GillesClerc/blackbox/docs/escapebox-vision.md

# EscapeBox — Vision produit

*Document de vision — Mai 2026*

---

## Le produit

Box physique électronique posée au centre d'une table. Les joueurs résolvent des énigmes immersives en interagissant avec les différentes faces du cube : écrans, zones tactiles, NFC, capteurs. La box se transforme à chaque scénario téléchargé — même principe qu'une console et ses jeux.

---

## L'objet

Cube ~120-150mm de côté en bois et ardoise *(dimension finale à valider au proto boîtier — la FSD travaille sur 150mm)*. Design artisanal, pensé pour rester sur une étagère entre deux parties. À l'intérieur : ESP32-S3, batterie LiPo, capteurs (NFC, capacitif, accéléromètre/gyro, souffle, température IR, aimant 3D, lumière, micro, potentiomètres), trois écrans (deux yeux ronds + bouche e-ink), haut-parleur stéréo. Un compartiment servo crée le moment de révélation physique (Phase 2).

Deux gammes :
- **Box Lite** (99-129 CHF) : MDF, capteurs essentiels, grand public
- **Box Pro** (199-249 CHF) : bois massif + ardoise + laiton, plateau rotatif, capteurs complets, passionnés et collectors

---

## L'expérience

Le joueur pose un objet NFC sur la box → elle s'allume, une voix lance l'histoire. Chaque énigme exploite un capteur différent. La coopération est dans le design : certaines énigmes nécessitent deux joueurs simultanément. La partie se termine par une révélation physique et un QR vers le leaderboard.

---

## Le modèle

Box achetée une fois. Scénarios achetés à l'unité (19-29 CHF) via la webapp, synchronisés sur la box via WiFi. La box fonctionne 100% offline pendant le jeu.

---

## Go-to-market

1. **FFF** — valider avec proches, retours qualitatifs, ajustements scénario/boîtier
2. **Kickstarter** — 50-100 early adopters à ~150 CHF si traction confirmée
3. **Lancement** — catalogue 3+ scénarios, marketplace créateurs, partenariats escape rooms et établissements scolaires (Phase 3)

---

## Vision à 3 ans

Catalogue de 15-20 scénarios, marketplace ouverte aux créateurs tiers, partenariats B2B (escape rooms, écoles, musées). Référence francophone dans le segment escape game électronique premium rejouable.

---

*Ce document est la vision du projet, pas une spec technique. Il peut évoluer.*
