GillesClerc/blackbox/docs/pcb/01-netlist.txt

══════════════════════════════════════════════════════════════════════════════
  ESCAPEBOX — NETLIST COMPLETE
  Format : texte structure pour reference lors du cablage dans Fusion 360
  Convention : NET_NAME : PIN1, PIN2, PIN3, ...
══════════════════════════════════════════════════════════════════════════════

═══ ALIMENTATIONS ════════════════════════════════════════════════════════════

NET 5V_USB:
  J1.VBUS (4 pins physiques a relier ensemble : A4, A9, B4, B9), U8.IN, C_IN.+, U12.VBUS

NET VSYS:
  U8.OUT (bq24075 power path output)
  U5.VIN (LDO digital), C_D1.+
  U6.VIN (LDO audio), C_A1.+
  U7.VIN (MT3608 boost), U7.EN (tie a VIN), C_B1.+
  L1.1 (inductance boost, autre borne sur BOOST_SW)
  (USB branche: ~4.4V / batterie: 3.0-4.2V)

NET VBAT:
  U8.BAT (bq24075), U9.VDD (DW01A), J2.1 (+), C_BAT.+

NET BAT_TS (2026-09-27, cellule 18650 avec NTC collee) :
  J2.3 (NTC 10k de la cellule), U8.TS (pin 1), R_TS.1 (10k fixe, DNP)
  (J2 = JST-PH 3 broches : 1 = BAT+, 2 = BAT-, 3 = NTC.
   /!\ Monter la NTC OU R_TS, jamais les deux : en parallele la mesure est
   faussee et le bq24075 suspend la charge sans symptome visible. TS flottante
   suspend la charge egalement. Fenetre obtenue : 0-50 C.)

NET 3V3_D (digital):
  U5.VOUT (pin 1 — AP2112M en SO-8 depuis le 2026-09-27, cf. brochage
   dans docs/datasheets/AP2112.md ; U5.GND = pins 6 ET 7), C_D2.+
  U1.3V3 (ESP32-S3 VDD)
  U4.VDD (ICS-43434)
  U11.VDDIO (pin 5, LSM6DSOXTR), U11.VDD (pin 8), U11.CS (pin 12, force mode I2C),
  C4.+ (100nF, decouplage VDDIO), C5.+ (100nF, decouplage VDD) — sheet imu.kicad_sch,
  IMU deplacee du satellite capteurs vers Main (2026-09-21), aucune contrainte de position
  (le ST25DV NFC est parti sur le satellite face Dessus — sheet nfc.kicad_sch, projet
  PCB separe, plus dans ce netlist Main)
  J3.VCC, J4.VCC, J5.VCC, J6.VCC (I2C satellites — pin 2, brochage Qwiic :
   1 = GND, 2 = 3V3, 3 = SDA, 4 = SCL, depuis 2026-09-23)
  J7.VCC (2x GC9A01 yeux)
  J7b.VCC (display bouche, TBD — pas e-ink)
  J8.VCC (toggles face avant + reserve)
  R3.1, R4.1 (pull-up I2C)
  R6.1 (pull-up EN)
  R_PG.1, R_CHG.1 (pull-up debug PGOOD/CHG, DNP par defaut)
  (R7 n'est plus utilise — le ST25DV n'a pas de pin reset/power-down equivalente
   au RSTPD du PN532. R7 retire du BOM.)

NET 3V3_A (audio):
  U6.VOUT, C_A2.+
  R5.1 (pull-up XSMT — vers 3V3_A, cf. NET PCM_XSMT)
  U2.AVDD (pin 8), C_AVDD.+
  U2.DVDD (pin 28), C_DVDD.+
  U2.CPVDD (pin 1), C_CPVDD.+
  U2.XSMT (pin 25) via R5
  (⚠ pins PCM5122 corrigees 2026-09-11 — vs datasheet TI SLAS763C, mode I2C.
   L'ancien netlist avait TOUS les numeros de pins PCM5122 faux, y compris
   ceux-ci. CPGND(3)/DGND(27)/AGND(9) restent a raccorder explicitement —
   non couverts par le NET GND generique actuel, a traiter au schematic capture.)

NET BOOST_SW:
  U7.SW (MT3608 pin 1)
  L1.2 (autre borne sur VSYS)
  D1.A (SS14 anode)

NET BOOST_FB:
  U7.FB (MT3608 pin 3)
  R_FB_H.2 (750k, autre borne sur 5V)
  R_FB_L.1 (100k, autre borne sur GND)

NET 5V_BOOST (sortie du boost, avant le load switch — 2026-09-27) :
  D1.K (SS34 cathode), C_B2.+
  R_FB_H.1 (diviseur feedback — reste cote boost, la regulation ne voit pas
   la chute du load switch)
  Q1.S (AO3401A, source cote boost)

NET GATE_5V:
  Q1.G, Q2.D (2N7002), R21.2 (100k vers 5V_BOOST)
  (Q1 conduit grille basse alors que EN_SYS est haut box allumee -> Q2 inverse)

NET EN_SYS (marche/arret, 2026-09-27) :
  J12.2 (interrupteur SW3 face Cote 2), R20.1 (pull-down 100k vers GND),
  U5.EN (LDO 3V3_D), U6.EN (LDO 3V3_A), U7.EN (boost MT3608), Q2.G
  (etaient tous cables directement sur VSYS avant : la box s'allumait des
   qu'une batterie etait branchee, ~10 mA de repos)

NET VSYS (ajout J12) :
  J12.1 (l'interrupteur ramene VSYS sur EN_SYS quand il est ferme)

NET 5V (apres le load switch) :
  Q1.D
  J9.VCC (WS2812)
  U3.VDD (PAM8406)
  (VOUT = 0.6V x (1 + 750k/100k) = 5.1V — le MT3608 n'a pas de pin VOUT,
   la sortie passe par SW -> D1 -> Q1. Chute du load switch ~50 mV a 0,83 A,
   la charge voit donc ~5,05 V, dans les specs WS2812 et PAM8406.)

NET GND:
  (toutes les masses — plan continu, pas de split)
  J1.GND (4 pins physiques : A1, A12, B1, B12 + EMI plate/shield du connecteur),
  U1.GND, U2.GND, U3.GND, U4.GND, U5.GND, U6.GND,
  U7.GND, U8.GND, U9.GND, U10.GND, U11.GND, U12.GND,
  J3.GND, J4.GND, J5.GND, J6.GND, J7.GND, J7b.GND, J8.GND,
  J9.GND, J2.GND,
  tous condensateurs pin -, toutes resistances retour GND

═══ BUS I2C ══════════════════════════════════════════════════════════════════

NET I2C_SDA:
  U1.GPIO21
  R3.2 (pull-up 4.7k vers 3V3_D)
  U2.SDA (PCM5122 pin 11)
  U11.SDA (pin 14, LSM6DSOXTR)
  J3.SDA, J4.SDA, J5.SDA, J6.SDA (satellites)

NET I2C_SCL:
  U1.GPIO17
  R4.2 (pull-up 4.7k vers 3V3_D)
  U2.SCL (PCM5122 pin 12)
  U11.SCL (pin 13, LSM6DSOXTR)
  J3.SCL, J4.SCL, J5.SCL, J6.SCL (satellites)

NET GND (ajout U11 LSM6DSOXTR):
  U11.SDO/SA0 (pin 1 — fixe l'adresse I2C a 0x6A), U11.SDx (pin 2, inutilise en
  mode 1), U11.SCx (pin 3, inutilise en mode 1)

(U11.INT1 (pin 4), U11.INT2 (pin 9), U11.OSC_AUX (pin 10), U11.SDO_AUX (pin 11) :
 non connectes — pas de GPIO libre pour les interruptions, OSC_AUX/SDO_AUX a
 laisser electriquement flottants en mode 1 par recommandation datasheet ST DS12814.
 Pinout complet verifie sur la datasheet primaire, voir docs/datasheets/LSM6DSOX.pdf)

(Le NET NFC_ANTENNA et le cablage ST25DV sont partis sur le satellite face Dessus,
 projet PCB separe — plus dans ce netlist Main. Voir nfc.kicad_sch.)

═══ BUS I2S0 — AUDIO SORTIE ═════════════════════════════════════════════════

NET I2S0_BCLK:
  U1.GPIO4
  U2.BCK (PCM5122 pin 21)

NET I2S0_LRCK:
  U1.GPIO5
  U2.LRCK (PCM5122 pin 23)

NET I2S0_DOUT:
  U1.GPIO6
  U2.DIN (PCM5122 pin 22)

═══ BUS I2S1 — AUDIO ENTREE (MICRO) ═════════════════════════════════════════

NET I2S1_SCK:
  U1.GPIO16
  U4.SCK (ICS-43434)

NET I2S1_WS:
  U1.GPIO18
  U4.WS (ICS-43434)

NET I2S1_SD:
  U1.GPIO7
  U4.SD (ICS-43434)

═══ BUS SPI2 — DISPLAY BOUCHE (type à définir, pas e-ink) + microSD (J11) ═══
(bus partage : MOSI/SCLK communs, MISO utilise par la SD seule,
 CS distincts — display bouche GPIO10, SD GPIO47)

NET SPI2_MOSI:
  U1.GPIO11
  J7b.MOSI (display bouche DIN)
  J11.DI (microSD Data In — bus partage display + SD)

NET SPI2_SCLK:
  U1.GPIO12 -> R13 (22R serie, ex-FB1) -> SPI2_SCLK (C6 10pF vers GND, DNP)
  J7b.SCLK (display bouche CLK)
  J11.CLK (microSD clock — bus partage)

NET SPI2_CS:
  U1.GPIO10
  J7b.CS (display bouche CS)

NET SPI2_DC:
  U1.GPIO9
  J7b.DC (display bouche DC)

NET SPI2_RST:
  U1.GPIO8
  J7b.RST (display bouche RST)

NET SPI2_BUSY:
  U1.GPIO13
  J7b.BUSY (display bouche BUSY, active low, lecture seule — a confirmer selon composant retenu)

═══ BUS SPI3 — YEUX (2x GC9A01) ════════════════════════════════════════════

NET SPI3_MOSI:
  U1.GPIO38
  J7.MOSI (GC9A01 #1 SDA + GC9A01 #2 SDA, partage)

NET SPI3_SCLK:
  U1.GPIO39 -> R14 (22R serie, ex-FB2) -> SPI3_SCLK (C7 10pF vers GND, DNP)
  J7.SCLK (GC9A01 #1 SCL + GC9A01 #2 SCL, partage)

NET SPI3_CS_L:
  U1.GPIO40
  J7.CS_L (GC9A01 #1 oeil gauche CS)

NET SPI3_CS_R:
  U1.GPIO14
  J7.CS_R (GC9A01 #2 oeil droit CS)

NET SPI3_DC:
  U1.GPIO41
  J7.DC (GC9A01 #1 DC + GC9A01 #2 DC, partage)

NET SPI3_RST:
  U1.GPIO42
  J7.RST (GC9A01 #1 RES + GC9A01 #2 RES, partage)

═══ TOGGLES FACE AVANT (via J8) ═════════════════════════════════════════════
(les 8 controles analogiques SL1-SL4 + RV1-RV4 sont numerises par l'ADS7830
 sur le PCB face avant — voir section FACE AVANT. GPIO1-3 liberes.)

NET SW1:
  U1.GPIO1
  J8.SW1 (toggle SPDT commun -> GPIO1, borne vers GND, pull-up interne ESP32)

NET SW2:
  U1.GPIO2
  J8.SW2 (toggle SPDT commun -> GPIO2, borne vers GND, pull-up interne ESP32)

NET VBAT_SENSE:
  U1.GPIO3 (ADC1_CH2 — ex-reserve, desormais dediee a la lecture batterie)
  J8.RSV (meme fil, garde le nom de pin J8 pour compat connecteur)
  R_VBAT_H.2, R_VBAT_L.2, C_VBAT_SENSE.1 (pont diviseur sur feuille Power)
  (pont VBAT -> R_VBAT_H 1M -> VBAT_SENSE -> R_VBAT_L 1M -> GND, + C_VBAT_SENSE
   100nF filtrage. Ratio 1:1 -> VBAT 3.0-4.2V lu comme 1.5-2.1V sur l'ADC.
   Ajoute suite a l'audit brownout 2026-09-20 : le dropout LDO (~250mV) fait
   decrocher le rail 3V3 bien avant le seuil de coupure DW01A (2.4V, filet de
   securite cellule, pas indicateur "batterie faible") — necessite une
   surveillance logicielle active de VBAT via cet ADC, seuils a definir cote
   firmware.)

═══ GPIO DIVERS ═════════════════════════════════════════════════════════════

NET WS2812_DATA:
  U1.GPIO48
  R8.1 (330R serie — valeur non issue de la datasheet WS2812B, dans la plage
   recommandee Adafruit NeoPixel Uberguide 300-500R)
  R8.2 -> LED2.DIN (chaine des 12 WS2812 montees sur Main, halo face Dessous) :
   LED2.DOUT->LED3.DIN->LED4.DIN->LED5.DIN->LED6.DIN->LED7.DIN->LED8.DIN->
   LED9.DIN->LED10.DIN->LED11.DIN->LED12.DIN->LED13.DIN
   LED13.DOUT -> J9.DATA (continue vers le halo visage, satellite Devant)
  (chaque LED : pin1 VDD->5V, pin3 VSS->GND — sheet connector.kicad_sch,
   reference WS2812B-B/T LCSC C2761795, ajoutees 2026-09-21)

NET SPI2_MISO:
  U1.GPIO15
  J11.DO (microSD Data Out — seul peripherique SPI2 utilisant MISO)

NET SPI2_CS_SD:
  U1.GPIO47
  J11.CS (microSD chip select — distinct du CS display bouche GPIO10)

NET 3V3_D (ajout J11):
  J11.VDD (pin 4, alimentation carte SD — absente du netlist jusqu'ici, trou
   comble lors du cablage du sheet Connecteurs)

NET GND (ajout J11):
  J11.VSS (pin 6), J11.GND (pins 10,11,12,13 — masses mecaniques/blindage
   du slot TF-01A)

PULL-UPS CARTE SD (ajoutees le 2026-09-27, ESP-IDF sd_pullup_requirements.rst :
 « en mode SPI ou SD 1 bit, CMD et DAT0-DAT3 doivent etre tirees au plus par 10k,
 y compris les lignes non reliees a l'hote ») — R15 a R19, 10k vers 3V3_D sur un
 rail commun, feuille connector :
  R15 -> SPI2_CS_SD (J11.2, CS/DAT3)
  R16 -> SPI2_MOSI  (J11.3, CMD/DI)
  R17 -> SPI2_MISO  (J11.7, DAT0/DO)
  R18 -> SD_DAT1    (J11.8, DAT1 — net nomme a cette occasion)
  R19 -> SD_DAT2    (J11.1, DAT2 — net nomme a cette occasion)

(J11 pin 9/CD non connectee — card-detect
 non utilises, pas de GPIO libre pour le CD)

NET BTN1:
  U1.GPIO45
  (⚠ STRAPPING VDD_SPI — JAMAIS de pull-up externe : GPIO45 = 1 au reset
   → VDD_SPI 1,8 V → flash illisible. Flottante = pull-down interne = OK.
   Bouton seulement actif haut (vers 3V3_D), relache au reset.
   Ref. ESP32-S3 datasheet §3.2, docs/datasheets/ESP32-S3-datasheet.md)

NET BTN2:
  U1.GPIO46
  (strapping boot/ROM log — pas de pull-up externe ; flottante = 0 = OK.
   Download mode exige GPIO0 = 0 ET GPIO46 = 0. Ref. ESP32-S3 datasheet §3.1)

NET USB_DM:
  J1.D- (2 pins physiques a relier ensemble : A7=Dn1, B7=Dn2 — connecteur
  reversible, les deux paires miroir doivent etre courtcircuitees pour
  fonctionner quelle que soit l'orientation du plug, design USB2.0 only)
  R11.1 (22R serie)
  R11.2 -> U12.IO1 (USBLC6-2SC6 protection ESD)
  U12.IO1 -> U1.GPIO19

NET USB_DP:
  J1.D+ (2 pins physiques a relier ensemble : A6=Dp1, B6=Dp2 — idem D-)
  R12.1 (22R serie)
  R12.2 -> U12.IO2 (USBLC6-2SC6 protection ESD)
  U12.IO2 -> U1.GPIO20

NET USB_ESD_VCC:
  U12.VBUS -> 5V_USB (reference clamping USBLC6-2SC6)

NET USB_CC1:
  J1.CC1 (pin A5)
  R9.1 (5.1k, autre borne GND)

NET USB_CC2:
  J1.CC2 (pin B5)
  R10.1 (5.1k, autre borne GND)

(⚠ J1 = HOOYA/HAOYU USB-307HB-B-SU, connecteur USB-C SMD 24 pins verifie via
 datasheet fabricant 2026-09-20. Pins SS non utilisees (design USB2.0 only,
 pas de USB3) : A2/A3=SSTXp1/n1, A10/A11=SSRXn2/p2, B1... /B2/B3=SSTXp2/n2,
 B10/B11=SSRXn1/p1 -> NC, ne pas router. SBU1(A8)/SBU2(B8) -> NC egalement,
 pas utilises dans ce design.)

═══ PCM5122 — CONNEXIONS INTERNES ═══════════════════════════════════════════

NET PCM_XSMT:
  U2.XSMT (pin 25)
  R5.2 (10k pull-up vers 3V3_A -> unmute)

NET PCM_LDOO:
  U2.LDOO (pin 26)
  C_LDOO.+ (100nF vers GND, sortie LDO interne)

NET PCM_OUTL:
  U2.OUTL (pin 6)
  R1.1 (100R filtre)

NET PCM_OUTR:
  U2.OUTR (pin 7)
  R2.1 (100R filtre)

NET AUDIO_L:
  R1.2 (sortie filtre 100R)
  C21.1 (22nF vers GND)
  U3.INL (PAM8406 entree gauche)

NET AUDIO_R:
  R2.2 (sortie filtre 100R)
  C22.1 (22nF vers GND)
  U3.INR (PAM8406 entree droite)

NET PCM_CAPP:
  U2.CAPP (pin 2)
  C19.+ (2.2uF/25V flying cap)

NET PCM_CAPM:
  U2.CAPM (pin 4)
  C19.- (autre borne flying cap)
  C20.+ (2.2uF/25V reservoir cap, autre borne vers VNEG)

NET PCM_VNEG:
  U2.VNEG (pin 5)
  C20.- (reservoir cap)

(⚠ CPGND, pin 3, non raccorde dans ce netlist textuel — masse charge pump,
 a relier a GND au schematic capture, cf. note NET 3V3_A plus haut.)

═══ PAM8406 — SORTIES HP ════════════════════════════════════════════════════

Chaine de sortie (2026-09-27, audit A2 corrige) : chaque fil passe par une ferrite
BLM21PG221SN1D (220R@100MHz, 2 A, LCSC C85840) avant le connecteur J10, comme
l'exige la datasheet PAM8406 en classe D sans filtre (Application Note 2).
J10 = JST PH 4 broches : 1 = L+, 2 = L-, 3 = R+, 4 = R-.
/!\ Sorties en pont : AUCUNE masse commune sur J10, ne jamais relier les "-"
    entre elles ni a GND.
Haut-parleur retenu : PUI AS04008PO-2-R, 8 ohm, 1 W nominal / 2 W max
(docs/datasheets/AS04008PO.md), cable sur le canal L ; canal R en reserve.

NET HP_L+:
  U3.OUTL+ -> FB3.1

NET SPK_L+:
  FB3.2 -> J10.1 (haut-parleur +)

NET HP_L-:
  U3.OUTL- -> FB4.1

NET SPK_L-:
  FB4.2 -> J10.2 (haut-parleur -)

NET HP_R+:
  U3.OUTR+ -> FB5.1

NET SPK_R+:
  FB5.2 -> J10.3 (reserve 2e HP +)

NET HP_R-:
  U3.OUTR- -> FB6.1

NET SPK_R-:
  FB6.2 -> J10.4 (reserve 2e HP -)

NET PAM_SHDN:
  U3.SHDN -> 3V3_D via 10k (toujours actif)

═══ CHARGE BATTERIE (bq24075 + DW01A/FS8205) ════════════════════════════════

NET BQ_ILIM:
  U8.ILIM (pin 12) -> R_ILIM (1.5k vers GND -> I_IN max ~1.07A, mode RILIM actif)

NET BQ_ISET:
  U8.ISET (pin 16) -> R_ISET (890R vers GND -> courant charge 1A)

NET BQ_TMR:
  U8.TMR (pin 14) -> R_TMR 56k 1% -> GND
  (timers de securite actifs : t_MAXCHG = 10 x K_TMR x R_TMR = 5,6 a 9,3 h,
   t_PRECHG 34-56 min. Etait TMR->GND = timers desactives avant le 2026-09-27.)

NET BQ_SYSOFF:
  U8.SYSOFF (pin 15) -> GND (systeme ON, NE PAS laisser flottant)

NET BQ_TS:
  U8.TS -> R_TS (10k vers GND)
  (pas de NTC dans le pack : 10k fixe TS->VSS maintient une tension valide,
   SLUS810N table 7-1 et §9.3.6 — un diviseur vers VSYS fausserait la mesure
   car TS est polarisee par une source de courant interne 75uA)

NET BQ_CE:
  U8.CE (pin 4) -> GND (active LOW, LOW = charge ON)

NET BQ_EN1:
  U8.EN1 (pin 6) -> GND (LOW)

NET BQ_EN2:
  U8.EN2 (pin 5) -> VSYS (HIGH)
  (EN2=H, EN1=L -> mode RILIM : I_IN max = K_ILIM/R_ILIM ~1.07A, ref SLUS810N table 7-2)

NET BQ_PGOOD:
  U8.PGOOD (pin 7, open drain)
  R_PG.2 (100k pull-up vers 3V3_D, DNP par defaut — testpoint debug sonde)

NET BQ_CHG:
  U8.CHG (pin 9, open drain)
  R_CHG.2 (100k pull-up vers 3V3_D, DNP par defaut — testpoint debug sonde)

NET BAT_PROT:
  U9.VCC (pin 5) -> R_VCC 100R -> bq24075 BAT (pin 2,3) -> J2.+ (LiPo B+)
  U9.CS (pin 2) -> midpoint (jonction S1/S2 FS8205)
  U9.GND (pin 6) -> midpoint (idem, PAS le GND systeme)
  U9.OD (pin 1) -> U10.G1 (pin 4)
  U9.OC (pin 3) -> U10.G2 (pin 5)
  U9.TD (pin 4) -> NC (flottant)
  U10.D12 (pin 1, pin 8) -> J2.- (LiPo B-) -> GND systeme
  U10.S1 (pin 2, pin 3) -> midpoint
  U10.S2 (pin 6, pin 7) -> midpoint

═══ ESP32 — RESET ═══════════════════════════════════════════════════════════

NET ESP_EN:
  U1.EN
  R6.2 (10k pull-up vers 3V3_D)
  C_EN.+ (100nF vers GND, filtre RC)

═══ SATELLITE CAPTEURS (bus I2C sur JST) ════════════════════════════════════

> ⚠ Section legacy (architecture 2-satellites pre-2026-09-21). Le decoupage
> reel en PCB par face (Devant/Dessus/Cote1/Cote2/Cote3, voir FSD §2.2.3)
> n'est pas encore fige. LSM6DSOXTR (ex-U21 ici) est CONFIRME deplace sur
> Main (U11) — retire de cette section. VEML7700/BMP280/MLX90614 restent
> prevus sur la face Cote3/Devant selon le nouveau decoupage FSD ; MTCH2120
> et TMAG5273 idem sur Cote2/Cote3 — references U20/U22-U25 a reprendre
> quand chaque satellite aura son propre projet KiCad (namespace independant).

Sur le PCB satellite, les nets sont internes :

NET SAT_I2C_SDA:
  J_SAT.SDA (JST-SH pin 3)
  U20.SDA (MTCH2120)
  U22.SDA (VEML7700)
  U23.SDA (BMP280)
  U24.SDA (MLX90614)
  U25.SDA (TMAG5273)

NET SAT_I2C_SCL:
  J_SAT.SCL (JST-SH pin 4)
  U20.SCL (MTCH2120)
  U22.SCL (VEML7700)
  U23.SCL (BMP280)
  U24.SCL (MLX90614)
  U25.SCL (TMAG5273)

NET SAT_3V3:
  J_SAT.VCC (JST-SH pin 2 — brochage Qwiic/STEMMA QT depuis 2026-09-23)
  U20.VDD, U22.VDD, U23.VDD, U23.VDDIO,
  U24.VDD, U25.VDD (TMAG5273)
  C30-C35.+ (decouplage 100nF chaque — nombre a ajuster, 6 caps prevus pour
  un IC de moins depuis le depart du LSM6DSOXTR)

NET SAT_GND:
  (⚠ absente de ce netlist avant 2026-09-11 — a relier : JST-SH pin 1 (Qwiic),
   U20.GND, U22.GND, U23.GND, U24.GND, U25.GND (pin2, TMAG5273),
   C30-C35.-)

(⚠ Pins verifiees 2026-09-11 contre datasheets officiels — a integrer au
 schematic capture, non presentes dans ce netlist textuel :
 - MTCH2120 (U20, QFN-20, Microchip DS40002613) : SCL=1, ADD_SEL=2 (→ GND),
   GND=3, VDD=4, INT=11, RESET=19 (→ pull-up), SDA=20.
 - TMAG5273 (U25, SOT-23-6, TI SLYS045C) : SCL=1, GND=2, GND(TEST)=3 (→ GND),
   VCC=4, INT=5, SDA=6.
 - MLX90614 (U24, TO-39, Melexis DOC#3901090614) : SCL/Vz=1, SDA/PWM=2, VDD=3,
   VSS(GND)=4. Seulement 4 broches, pas d'adresse pin — cablage simple confirme.
   ⚠ Variante 3 V MLX90614Bxx obligatoire (Axx = 4,5-5,5 V). 100nF pres VDD/VSS.
 - BMP280 (U23, LGA-8, Bosch BST-BMP280-DS001 rev 1.26, verifie 2026-09-23) :
   GND=1, CSB=2 (→ VDDIO en DIRECT, sinon verrouillage SPI), SDI/SDA=3, SCK/SCL=4,
   SDO=5 (→ GND : adresse 0x76), VDDIO=6, GND=7, VDD=8. 100nF sur VDD et VDDIO.
 - MTCH2120 : adresse reelle 0x20 (ADD_SEL=GND), pas 0x28 (verifie 2026-09-23).
 - TMAG5273 : commander la variante A1 (adresse 0x35) ; INT non utilisee → GND +
   MASK_INTB=1 en firmware ; >= 0.01uF sur VCC.

Pinout ST25DV04KC-IE6S3 (SO8, remplace le PN532, EOL/abandonne 2026-09-20,
use-case badge externe abandonne) — deplace sur le futur satellite face
Dessus (sera U11 la-bas, namespace independant de Main) : pinout confirme
contre datasheet officielle ST DS10925 Rev9 : V_EH=1 (NC), AC0=2, AC1=3,
[CORRIGE 2026-09-27 : l'ancienne ligne inversait 1 et 2 ; figure 2 relue, symbole LCSC juste]
VSS=4 (GND), SDA=5, SCL=6, GPO=7 (NC, polling I2C prefere a l'interrupt —
budget GPIO sature), VCC=8 (3V3_D, decouplage 10nF+100nF). Beaucoup plus
simple que le PN532 : pas de cristal, pas de reseau d'adaptation RF externe
(capacite de tuning 28.5pF deja interne). Regulateur interne confirme
empecher tout retour de tension sur VCC quand alimente par RF seule (safe
meme box eteinte). Voir docs/datasheets/ST25DV04K.md pour le detail complet.

═══ FACE AVANT — ADS7830 + CONTROLES ANALOGIQUES (bus I2C sur JST) ══════════

Le PCB face avant porte U26 (ADS7830, ADC 8 canaux 8 bits, adresse I2C 0x48)
qui numerise les 4 faders SL1-SL4 et les 4 pots rotatifs RV1-RV4. Connexion
au main par un JST-SH 4p du bus I2C (J3-J6). Mesure ratiometrique : REFIN
cable sur le rail 3V3 qui alimente aussi les potentiometres (PD1PD0=01 cote
firmware pour couper la ref interne 2.5V).

NET FP_I2C_SDA:
  J_FP.SDA (JST-SH pin 3)
  U26.SDA (pin 15)

NET FP_I2C_SCL:
  J_FP.SCL (JST-SH pin 4)
  U26.SCL (pin 14)

NET FP_3V3:
  J_FP.VCC (JST-SH pin 2 — Qwiic)
  U26.+VDD (pin 16), C_FP1.+ (100nF decouplage)
  U26.REFIN (pin 10), C_FP2.+ (1uF — ref externe ratiometrique)
  SL1.1, SL2.1, SL3.1, SL4.1 (faders, borne haute)
  RV1.1, RV2.1, RV3.1, RV4.1 (pots rotatifs, borne haute)

NET FP_GND:
  J_FP.GND (JST-SH pin 1 — Qwiic)
  U26.GND (pin 9)
  U26.COM (pin 11, borne -IN commune single-ended)
  U26.A0 (pin 12), U26.A1 (pin 13) -> adresse 0x48
  SL1.3, SL2.3, SL3.3, SL4.3, RV1.3, RV2.3, RV3.3, RV4.3 (bornes basses)
  C_FP1.-, C_FP2.-

NET FP_CH0:  U26.CH0 (pin 1) -> SL1.2 (curseur fader 1)
NET FP_CH1:  U26.CH1 (pin 2) -> SL2.2 (curseur fader 2)
NET FP_CH2:  U26.CH2 (pin 3) -> SL3.2 (curseur fader 3)
NET FP_CH3:  U26.CH3 (pin 4) -> SL4.2 (curseur fader 4)
NET FP_CH4:  U26.CH4 (pin 5) -> RV1.2 (curseur pot rotatif 1)
NET FP_CH5:  U26.CH5 (pin 6) -> RV2.2 (curseur pot rotatif 2)
NET FP_CH6:  U26.CH6 (pin 7) -> RV3.2 (curseur pot rotatif 3)
NET FP_CH7:  U26.CH7 (pin 8) -> RV4.2 (curseur pot rotatif 4)

(Attention firmware : le mapping canal -> bits C2-C0 du command byte n'est
 pas sequentiel — voir docs/datasheets/ADS7830.md)

═══ NOTES DE CABLAGE ════════════════════════════════════════════════════════

1. Les condensateurs de decouplage doivent etre places au plus pres
   des pins VDD de chaque composant, avec via GND adjacent.

2. Le plan GND est sur le layer 2 (PCB 4 couches main board).
   Il doit etre CONTINU — aucune fente, aucune coupure.

3. Les traces I2S (BCLK, LRCK, DOUT) doivent etre courtes (< 3cm),
   groupees, et blindees par des traces GND adjacentes.

4. La zone audio (PCM5122 + LDO audio + filtre RC + PAM8406) doit
   etre isolee dans un coin du PCB, sans traces digitales en dessous.

5. (Note antenne ST25DV deplacee — s'applique au PCB satellite face Dessus,
   plus au Main. Zone de garde sans cuivre sous la boucle a prevoir la-bas.)

6. Le micro ICS-43434 necessite un trou acoustique D1mm dans le PCB.

7. Les deux GC9A01 et le display bouche (type a definir, pas e-ink) sont
   des MODULES externes connectes via JST-SH. Pas de composants ecran sur
   le PCB main.

══════════════════════════════════════════════════════════════════════════════
