GillesClerc/blackbox/docs/datasheets/CAP1298.md

# CAP1298 (Microchip) — contrôleur tactile 8 canaux, SMBus/I2C

> _Synthèse de la datasheet DS00001571B (fichier local [./CAP1298.pdf](./CAP1298.pdf) — PDF
> chiffré AES-128 sans mot de passe d'ouverture), lue le 2026-09-27._

**Catégorie** : 8 entrées tactiles, détection de proximité, garde active, motifs multi-touches
**Boîtiers** : SOIC-14, QFN-16 (3 × 3, pastille exposée)
**LCSC / JLCPCB (27/09/2026)** : CAP1298-1-SL-TR (SOIC-14) **C2652072**, 1,61 $ (1,35 $ par 10),
stock **125** ; CAP1298-1-A4-TR (QFN-16) C144326, stock 0

## Points vérifiés

- **8 entrées CS1-CS8** (description générale). **CS5 partagée avec SG** (garde active) : garde utilisée ⇒
  **7 touches** (tableau 1-1, broche 12 SOIC).
- **Adresse SMBus fixe `0101_000` = 0x28** (§3.2.2) — la même que le CAP1296 et le CAP1206 :
  **un seul contrôleur CAP12xx par bus**.
- VDD **3,0 à 5,5 V** (caractéristiques électriques) ; broches numériques tolérantes 5 V.
- SMBus / I2C : horloge **10 à 400 kHz** (caractéristiques SMBus).
- **ALERT#** : sortie d'interruption active basse, drain ouvert (pull-up requis).
- Entrées inutilisées : à la masse ; N/C à la masse.

## Brochage SOIC-14 (figure 1-2 + tableau 1-1)

| SOIC | Nom | | SOIC | Nom |
|---|---|---|---|---|
| 1 | CS2 | | 8 | GND |
| 2 | CS1 | | 9 | CS8 |
| 3 | ALERT# | | 10 | CS7 |
| 4 | SMDATA | | 11 | CS6 |
| 5 | SMCLK | | 12 | CS5 / SG |
| 6 | N/C (à la masse) | | 13 | CS4 |
| 7 | VDD | | 14 | CS3 |

## Notes projet

- ✅ **Retenu le 2026-09-27 pour le clavier de Côté 2** (8 touches, ou 7 + garde) : moins cher et
  disponible. BOM : COTE2-U2, C2652072.
- **ALERT# inutilisée → à GND** (tableau 1-1, « Unused Connection »), N/C à GND ; découplage
  100 nF au plus près de VDD.
- Adresse 0x28 prise : **aucun autre CAP12xx possible** sur le bus.
- **Répartition Côté 2 (27/09)** : CS1-CS4, CS6, CS7 = 6 touches ; **CS8 = proximité** « approche
  ta main » (grande électrode, gain augmenté, §4.5) ; **CS5 = garde SG** (registre 0x29 Signal Guard
  Enable, bit CS8_SG_EN ; CS5 désactivée quand la garde est active, §5.13).
- Découplage **1 µF + 0,1 µF** sur VDD (figure 3-1) ; pas de résistance série sur les CSx.
- Le connecteur Qwiic (4 fils) ne transporte pas ALERT# jusqu'à la Main → lecture par
  scrutation (polling) du registre d'état.
