GillesClerc/blackbox/docs/datasheets/AT42QT2120.md

# AT42QT2120 (Microchip, ex-Atmel) — QTouch 12 touches, I2C

> _Synthèse de la datasheet 9634E–AT42–06/12 (fichier local [./AT42QT2120.pdf](./AT42QT2120.pdf),
> miroir LCSC de C614938), lue le 2026-09-27._

**Catégorie** : 12 touches capacitives (dont proximité et canal de garde), I2C
**Boîtiers** : SOIC-20, TSSOP-20 (et VQFN)
**LCSC / JLCPCB (27/09/2026)** : AT42QT2120-SUR **C614938**, 1,85 $, stock **80** ;
AT42QT2120-XUR C2652098, 2,73 $, stock **25**

## Points vérifiés

- **Adresse I2C fixe 0x1C, non modifiable** (§4.2) → un seul par bus.
- I2C **400 kHz max** (§4.1.1) ; ligne **CHANGE** (drain ouvert, active basse) signalant un
  changement d'état, pull-up externe requis.
- 1 à 12 touches selon le mode ; 3 canaux peuvent former un slider ou une molette (il reste alors 9 touches). Supporte des **capteurs de
  proximité** et un **canal de garde** (§2.1).

## Notes projet

- **Écarté le 2026-09-27** au profit du CAP1298.

- Alternative « Microchip, documentation anglaise » au SC12B pour Côté 2, mais **stock JLCPCB
  faible** (80 / 25) et prix 3,5 à 5 fois plus élevé.
