GillesClerc/blackbox/docs/datasheets/MLX90614.md

# MLX90614

> ⚠ **Retiré du produit le 2026-09-27** (coût de la variante 3 V, bus I2C bridé à 100 kHz).
> Synthèse conservée pour référence.

> _Synthèse de la datasheet Melexis DOC#3901090614, rév. 021 du 02/06/2026 (fichier local [./MLX90614.pdf](./MLX90614.pdf))._

**Fabricant** : Melexis
**Catégorie** : Thermomètre infrarouge sans contact (thermopile), sortie SMBus / PWM
**Référence officielle** : MLX90614**B**xx (3 V) — ex. MLX90614ESF-BCC-000-TU (35° FOV)
**Datasheet source** : https://www.melexis.com/en/documents/documentation/datasheets/datasheet-mlx90614

## Vue d'ensemble

Capteur IR TO-39 étalonné en usine (température objet et ambiante), précision ±0,5 °C
autour de l'ambiante, interface SMBus compatible I2C ou sortie PWM / relais thermique.
Existe en variantes 5 V (Axx) et **3 V (Bxx, Dxx)**, et en plusieurs champs de vue (FOV).

## Codification (tableau 1)

`MLX90614` + température (E = −40…85 °C, K = −40…125 °C) + boîtier (SF = TO-39) +
**alimentation (A = 5 V, B = 3 V)** + gradient + FOV (ex. C = 35°).

## Pinout (TO-39)

| Pin | Nom | Fonction |
|---|---|---|
| 1 | SCL / Vz | Horloge SMBus (Vz : zener 5,7 V sur Axx seulement) |
| 2 | SDA / PWM | Données SMBus / sortie PWM |
| 3 | VDD | Alimentation |
| 4 | VSS | Masse |

## Paramètres électriques (Bxx, 3,0 V, 25 °C)

| Param | Min | Typ | Max | Unité | Note |
|---|---|---|---|---|---|
| VDD (Bxx) | 2,6 | 3,0 | 3,6 | V | Axx : 4,5–5,5 V |
| Courant | — | 1,3 | 2,5 | mA | |
| Sleep (Bxx uniquement) | — | 2 | 6 | µA | pas de sleep sur Axx |
| Horloge SMBus | 10 | — | 100 | kHz | |
| Adresse par défaut | — | 0x5A | — | | reprogrammable en EEPROM (0x0E) |
| Timeout SCL bas | 27 | — | 33 | ms | reset de l'interface |
| Requête SMBus (depuis PWM) | 1,44 | — | — | ms | SCL bas |
| Cycles EEPROM | — | 100 000 | — | | 25 °C |
| Effacement / écriture EEPROM | — | 5 / 5 | — | ms | |

## Interface

- **SMBus par défaut** au POR (PWM désactivé en usine).
- Lectures RAM/EEPROM sur 16 bits + octet **PEC** (CRC-8) ; adresse 0x00 = appel général.
- Jusqu'à 127 capteurs sur un bus (adresse 7 bits en EEPROM).
- Découplage : **100 nF céramique au plus près de VDD et VSS** (§5.7) ; du bruit peut être
  couplé par SCL dans le boîtier.

## Notes spécifiques projet

- Satellite face Côté 3, alimenté en 3V3 → **impérativement une variante Bxx** (une Axx ne
  fonctionne pas sous 4,5 V). Vérifier que la référence LCSC C58661 (FSD §10.1) est bien Bxx.
- Adresse : 0x5A entre en conflit avec le MPR121 (Phase 1 uniquement). En Phase 2 le
  MTCH2120 est en 0x20/0x21 → **pas de conflit, la reprogrammation en 0x5C n'est utile que
  si le MPR121 reste sur le bus**.
- Le bus I2C doit rester ≤ 100 kHz (firmware actuel : 100 kHz ✓).
- Brochage de la netlist documentée conforme (SCL 1, SDA 2, VDD 3, VSS 4).

## Sources

- Datasheet Melexis rév. 021 (PDF local)
