GillesClerc/blackbox/docs/datasheets/MPR121.md

# MPR121

> _Synthèse de la datasheet NXP MPR121 (fichier local [./MPR121.pdf](./MPR121.pdf), copie Adafruit). Composant de la **Phase 1** (breakout Adafruit STEMMA QT) ; remplacé par le **CAP1298** sur PCB (décision 2026-09-27) — voir [./CAP1298.md](./CAP1298.md). Fin de vie NXP depuis 2019._

**Fabricant** : NXP (ex-Freescale)
**Catégorie** : Contrôleur tactile capacitif 12 électrodes, I2C
**Référence officielle** : MPR121QR2 (QFN-20)

## Vue d'ensemble

12 électrodes tactiles + électrode de proximité virtuelle (13e), seuils et filtres
configurables, 8 électrodes utilisables en sorties LED/GPIO, broche IRQ.

## Paramètres clés

| Param | Valeur | Note |
|---|---|---|
| VDD | 1,71 – 3,6 V | régulateur interne 2,0–3,6 V (config 2) ; config 1 pour 1,71–2,75 V |
| Adresse I2C | 0x5A / 0x5B / 0x5C / 0x5D | ADDR relié à VSS / VDD / SDA / SCL |
| Boîtier | QFN-20 | |

## Notes spécifiques projet

- Phase 1 : breakout Adafruit (ADDR → GND, **0x5A**), identique à `MPR121_ADDR` du firmware ✓.
- ~~Conflit d'adresse avec le MLX90614 (0x5A)~~ : MLX90614 retiré du produit le 2026-09-27.
- Calibrage de la ligne de base à l'init : un doigt posé au démarrage devient la référence
  (constaté au proto, mémoire projet) → le menu de boot détecte le toucher après l'init.

## Sources

- Datasheet NXP MPR121 (PDF local, copie Adafruit : https://cdn-shop.adafruit.com/datasheets/MPR121.pdf)
