GillesClerc/blackbox/docs/datasheets/MTCH2120.md

# MTCH2120

> ⚠ **Abandonné le 2026-09-27** (aucun stock JLCPCB) : remplacé par le **CAP1298** —
> voir [./CAP1298.md](./CAP1298.md). Synthèse conservée pour référence.

> _Synthèse de la datasheet Microchip DS40002613E (fichier local [./MTCH2120.pdf](./MTCH2120.pdf))._

**Fabricant** : Microchip Technology
**Catégorie** : Contrôleur tactile capacitif 12 canaux, I2C, blindage actif
**Référence officielle** : MTCH2120 (VQFN-20, SOIC-20, SSOP-20)
**Datasheet source** : https://ww1.microchip.com/downloads/aemDocuments/documents/MCU08/ProductDocuments/DataSheets/MTCH2120-12CH-CapacitiveTouchControl-DataSheet-DS40002613.pdf

## Vue d'ensemble

12 capteurs tactiles ou de proximité (à travers plastique, bois, métal), réglage automatique
« Easy Tune », blindage actif (Driven Shield) sur BUTTON11, 4 « lumps » (groupes de
boutons), broche INT, paramètres réglables par I2C.

## Package & Footprint

- **Package** : VQFN-20 (aussi SOIC-20 / SSOP-20, brochage différent)
- **VQFN « REB »** (dessin C04-21380) : corps 3,00 × 3,00 mm, pas 0,40, hauteur 0,85 typ.
  (0,90 max), broches b = 0,20 (0,15-0,25) × L = 0,40 (0,35-0,45), pastille exposée
  D2 = E2 = 1,70 (1,60-1,80). Variante « 2LX » (C04-2476) : même corps, flancs mouillables.
- **Motif de pastilles recommandé REB** (C04-23380) : C1 = C2 = **3,00** (entraxe des
  rangées), pastilles X1 × Y1 = **0,20 × 0,80** (×20), pastille centrale X2 = Y2 = **1,80**,
  G1 (pastille ↔ centre) = 0,20, G2 (entre pastilles) = 0,20 ; vias thermiques Ø 0,30 au
  pas de 1,00, bouchés ou « tented » (note 2).
- **Pastille exposée (EP)** : non citée dans le tableau 1-1 ; à relier à **GND** (pratique
  usuelle, pas de consigne explicite dans le texte de la datasheet).
- **Codes de commande** : la section 8 de la datasheet renvoie à la page produit (aucun
  code listé). Plages de température annoncées : −40…+105 °C et −40…+125 °C.
  LCSC **C45606479 = MTCH2120-V/REB** (VQFN 3 × 3) ; stock JLCPCB **0** au 27/09/2026.
- ⚠ Le PDF local est **chiffré** (AES-256, R6, sans mot de passe d'ouverture) et ses polices
  sont encodées avec un décalage : `tools/pdf_text.py` ne sort rien tel quel.

## Pinout (VQFN-20, tableau 1-1)

| Pin | Nom | Fonction | Si inutilisée |
|---|---|---|---|
| 1 | SCL | Horloge I2C | — |
| 2 | ADD_SEL | Sélection d'adresse | relier à GND |
| 3 | GND | Masse | — |
| 4 | VDD | Alimentation | — |
| 5–10 | BUTTON0–5 / GPIO0–5 | Électrodes | ne pas connecter, configurer en sortie basse |
| 11 | INT | Interruption | — |
| 12 | GPIO12 | GPIO dédiée | relier à VDD ou GND |
| 13–17 | BUTTON6–10 / GPIO6–10 | Électrodes | idem |
| 18 | BUTTON11 / DS / GPIO11 | Électrode ou blindage actif | idem |
| 19 | RESET | Reset matériel | **pull-up** |
| 20 | SDA | Données I2C | — |

## Paramètres électriques

| Param | Valeur | Note |
|---|---|---|
| VDD | **3,0 – 5,5 V** | détecteur de sous-tension : reset sous 3 V |
| I2C | 100 kHz (standard), 400 kHz (fast) | |
| Charge du bus (C_B) | ≤ 400 pF | |
| Temps de montée t_R | ≤ 1000 ns (100 kHz), ≤ 300 ns (400 kHz) | |

## Interface I2C

- **Adresse** (tableau 3-3, lue au reset) : ADD_SEL = 0 → **0x20** ; ADD_SEL = 1 → **0x21**.
- **Adressage mémoire sur 16 bits** : écrire l'offset 16 bits, puis relire (start répété
  possible). Pour écrire à deux adresses distinctes, utiliser un stop, pas un start répété.
  Ordre des octets de l'offset : voir la figure 3-5 (à confirmer avant de coder ; driver
  hôte de référence : github.com/MicrochipTech/MTCH2120).

## Registres clés

| Offset | Nom | Reset | Description |
|---|---|---|---|
| 0x0000 | DEVID | 0x0B | Identifiant du composant (sonde au démarrage) |
| 0x0102 | BTNSTA | 0x0000 | État des 12 boutons (bits 0–11) et 4 lumps (bits 12–15), 1 = touché |

## Notes spécifiques projet

- Satellite face Côté 2 (zones tactiles). Brochage de la netlist documentée conforme
  (SCL 1, ADD_SEL 2 → GND, GND 3, VDD 4, INT 11, RESET 19 → pull-up, SDA 20).
- ⚠ **Adresse réelle 0x20** (ADD_SEL = GND), et non 0x28 comme dans le FSD et
  `firmware/components/hal_touch/mtch2120.h`.
- ⚠ Le driver `mtch2120.c` lit des registres 8 bits 0x00/0x01 : **incompatible** avec
  l'adressage 16 bits → lire DEVID (0x0000) pour la sonde et BTNSTA (0x0102) pour l'état.
- VDD min 3,0 V : sur batterie basse, 3V3_D (VBAT − dropout AP2112, − chute dans le câble)
  peut passer sous 3 V → reset du MTCH2120. Prévoir une extinction firmware sur VBAT basse.

## Sources

- Datasheet DS40002613E : https://ww1.microchip.com/downloads/aemDocuments/documents/MCU08/ProductDocuments/DataSheets/MTCH2120-12CH-CapacitiveTouchControl-DataSheet-DS40002613.pdf
