GillesClerc/blackbox/docs/datasheets/CH32V003.md

# CH32V003 (WCH) — MCU RISC-V très bon marché

> _Synthèse partielle de la datasheet V1.8 (en chinois, fichier local [./CH32V003.pdf](./CH32V003.pdf),
> miroir LCSC de C5299908 — PDF chiffré RC4, texte chinois mal extrait), lue le 2026-09-27._

**Catégorie** : RISC-V (RV32EC) 48 MHz, 16 Ko de flash, 2 Ko de SRAM
**LCSC / JLCPCB (27/09/2026)** : CH32V003F4U6 (QFN-20 3 × 3) **C5299908**, 0,31 $, stock 5 000 ;
CH32V003F4P6 (TSSOP-20) C5187096, 0,29 $, stock 1 035

## Points vérifiés (tableau de sélection et figure 1-1)

- F4P6 / F4U6 : 20 broches, **18 GPIO**, 1 I2C, 1 SPI, 1 USART, ADC 10 bits **8 entrées (AIN0-AIN7)**.
- Alimentation **2,7 à 5,5 V**.
- Programmation par **SDI une broche** (sonde WCH-LinkE).

## Non vérifié

- La détection tactile (« TKey », via l'ADC) est annoncée par WCH, mais je n'ai pas pu la lire dans
  la datasheet (texte chinois illisible à l'extraction). Au mieux 8 touches (8 entrées ADC).
