GillesClerc/blackbox/docs/datasheets/STM32F042.md

# STM32F042 (ST) — MCU Cortex-M0 avec contrôleur tactile TSC

> _Synthèse partielle de la datasheet (fichier local [./STM32F042.pdf](./STM32F042.pdf), miroir LCSC
> de C2969989), lue le 2026-09-27._

**LCSC / JLCPCB (27/09/2026)** : STM32F042F6P6TR (TSSOP-20) C2969989, 1,77 $, stock 3 200

- TSC (§3.11) : jusqu'à 14 canaux capacitifs selon le boîtier ; **TSSOP-20 (F042Fx) : 7 canaux**
  seulement (tableau 6). Écarté le 2026-09-27 pour un clavier de 8-12 touches.
