GillesClerc/blackbox/docs/datasheets/bq24075.md

# bq24075

> _Synthèse générée par component-research. Datasheet PDF : [./bq24075.pdf](./bq24075.pdf)_

**Fabricant** : Texas Instruments
**Catégorie** : Chargeur LiPo linéaire 1 cellule + power path management (DPPM)
**Référence officielle** : BQ24075RGTR (datasheet commun BQ24072/73/74/75/79, SLUS810N rév. octobre 2021)
**Datasheet source** : https://www.ti.com/lit/ds/symlink/bq24075.pdf

## Vue d'ensemble

Chargeur Li-Ion/LiPo linéaire 1 cellule (4,2 V) jusqu'à 1,5 A avec power path dynamique
(DPPM) : alimente le système sur OUT tout en chargeant la batterie indépendamment, et bascule
en « battery supplement mode » si la source ne suffit pas. Compatible USB (limites 100 mA /
500 mA / programmable via ILIM), VIN-DPM contre les sources USB faibles, protection
surtension entrée 28 V max (suspension > 6,6 V). Le BQ24075 ajoute la pin SYSOFF
(déconnexion batterie) ; OUT régulé à 5,5 V typ quand l'entrée est présente.
Configuration 100 % matérielle par résistances — aucun bus de contrôle.

## Package & Footprint

- **Package** : VQFN-16 (RGT) avec pad thermique exposé
- **Dimensions** : 3 × 3 mm
- **Pitch** : 0,5 mm
- **Empreinte LCSC** : C15464 (BQ24075RGTR)
- **Pad thermique** : à connecter au plan GND (même potentiel que VSS), vias thermiques — mais VSS pin 8 reste la masse principale du circuit

## Pinout (BQ24075, VQFN-16 RGT)

| Pin | Nom | Direction | Fonction |
|---|---|---|---|
| 1 | TS | IN | Entrée thermistance NTC 10k du pack batterie. **Sans thermistance : une résistance fixe 10 kΩ TS→VSS** (maintient une tension valide, sinon charge suspendue) |
| 2, 3 | BAT | I/O | Sortie étage de charge + sense batterie. Vers borne + LiPo. Bypass 4,7–47 µF vers VSS |
| 4 | CE | IN | Charge enable **actif bas**. LOW = charge ON. Pull-down interne ~285 kΩ, ne pas laisser flottant |
| 5 | EN2 | IN | Sélection limite courant d'entrée (voir table EN1/EN2). Pull-down interne ~285 kΩ |
| 6 | EN1 | IN | idem EN2 |
| 7 | PGOOD | OUT | Open-drain, LOW = source d'entrée valide. Pull-up 1 k–100 kΩ ou LED |
| 8 | VSS | PWR | Masse. Toujours connectée (le pad thermique ne remplace pas cette pin) |
| 9 | CHG | OUT | Open-drain, LOW = charge en cours. High-Z = charge finie ou désactivée. Pull-up 1 k–100 kΩ ou LED |
| 10, 11 | OUT | OUT | Sortie système (power path). 5,5 V typ sur entrée valide, sinon VBAT (sauf SYSOFF haut). Bypass 4,7–47 µF |
| 12 | ILIM | IN | Programmation limite courant d'entrée (mode EN2=H/EN1=L) : R 1,1 k–8 kΩ vers VSS. **ILIM flottant = toute charge désactivée** |
| 13 | IN | IN | Entrée DC 4,35–6,4 V (suspension au-dessus, destruction > 28 V). Bypass 1–10 µF vers VSS |
| 14 | TMR | IN | Timers de sécurité : flottant = défauts (précharge 30 min, charge 5 h), R 18–72 kΩ = programmable, **GND = timers désactivés** |
| 15 | SYSOFF | IN | HIGH = déconnecte la batterie de OUT. **GND pour fonctionnement normal, ne pas laisser flottant** |
| 16 | ISET | I/O | Programmation courant de charge rapide : R 590 Ω–8,9 kΩ (1 %) vers VSS. La tension sur ISET reflète le courant de charge réel (monitoring). Flottant = charge désactivée |

### Table EN1/EN2 (limite courant d'entrée)

| EN2 | EN1 | Limite IN |
|---|---|---|
| 0 | 0 | 100 mA (USB100) |
| 0 | 1 | 500 mA (USB500) |
| 1 | 0 | Programmée par R_ILIM (K_ILIM/R_ILIM) |
| 1 | 1 | Standby (USB suspend) |

## Paramètres électriques

| Param | Min | Typ | Max | Unité | Note |
|---|---|---|---|---|---|
| VIN opérationnel | 4,35 | — | 6,4 | V | BQ24075 (le '74 monte à 10,2 V) |
| VIN abs max | –0,3 | — | 28 | V | suspension (OVP) à 6,6 V typ |
| V_OVP | 6,4 | 6,6 | 6,8 | V | seuil surtension entrée |
| UVLO | 3,2 | 3,3 | 3,4 | V | |
| V_BAT(REG) | 4,16 | 4,20 | 4,23 | V | tension de fin de charge |
| V_OUT(REG) | 5,4 | 5,5 | 5,6 | V | entrée valide (power path) |
| V_DO(IN-OUT) | — | 300 | 475 | mV | dropout IN→OUT @ 1 A |
| V_DO(BAT-OUT) | — | 50 | 100 | mV | dropout BAT→OUT @ 1 A (sur batterie) |
| I_CHG | 100 | — | 1500 | mA | K_ISET/R_ISET, K_ISET = 890 AΩ typ |
| I_PRECHG | — | K_PRECHG/R_ISET | — | A | K_PRECHG = 88 AΩ typ (~10 % de I_CHG) |
| I_TERM (interne) | 0,09×I_CHG | 0,10×I_CHG | 0,11×I_CHG | A | fin de charge |
| V_LOWV | 2,9 | 3,0 | 3,1 | V | seuil précharge → charge rapide |
| V_RCH | — | V_REG–100mV | — | V | seuil de recharge auto |
| V_DPPM | 4,2 | 4,3 | 4,4 | V | seuil OUT où la charge est réduite ('75) |
| I_BAT sleep | — | 4,3 | 6,5 | µA | conso sur BAT sans entrée (85 °C) |
| I_NTC (bias TS) | 72 | 75 | 78 | µA | courant injecté dans TS pendant la charge |
| T_J max | –40 | — | 125 | °C | régulation thermique à 125 °C (réduit I_CHG) |

## Interface

- **Type** : configuration matérielle pure (résistances + niveaux logiques). Aucun bus I²C/SPI.
- **Statuts vers MCU (optionnel)** : PGOOD et CHG en open-drain → pull-up vers 3V3 et lecture GPIO.
- **Monitoring courant de charge (optionnel)** : tension ISET ∝ I_CHG réel → lisible sur un ADC.

## Registres clés

_(non applicable — composant analogique sans interface numérique)_

## Dimensionnement (formules)

```
R_ISET = K_ISET / I_CHG        → 890 AΩ / 1,0 A  = 890 Ω   (charge 1 A)
R_ILIM = K_ILIM / I_IN_MAX     → 1610 AΩ / 1,5 kΩ ≈ 1,07 A  (mode EN2=H/EN1=L)
R_TMR  = t_MAXCHG / (10 × 48 s/kΩ)   — ou TMR→GND pour désactiver les timers
TS sans NTC : R fixe 10 kΩ TS→VSS (§9.3.6 et table 7-1 du datasheet)
```

## Séquence d'initialisation

```
1. Aucune — démarrage autonome dès VIN > UVLO et VIN > VBAT + 80 mV.
2. Au power-on : test court-circuit ILIM/ISET, détection batterie, puis précharge
   (VBAT < 3,0 V) ou charge rapide. Inrush limité par séquence propriétaire (USB-IF).
3. Côté firmware : rien d'obligatoire. Option : lire PGOOD/CHG sur GPIO pour
   afficher l'état de charge.
```

## Exemple ESP-IDF

Pas de driver nécessaire. Lecture optionnelle des statuts open-drain :

```c
// PGOOD / CHG : open-drain, pull-up externe 100k vers 3V3_D.
// LOW = actif (source valide / charge en cours).
static void charger_status_read(gpio_num_t pgood, gpio_num_t chg)
{
    bool input_ok  = (gpio_get_level(pgood) == 0);
    bool charging  = (gpio_get_level(chg) == 0);
    ESP_LOGI("charger", "input=%s charge=%s",
             input_ok ? "OK" : "absent", charging ? "en cours" : "terminee/off");
}
```

_(dans l'EscapeBox les pins PGOOD/CHG ne sont pas câblées au MCU — budget GPIO épuisé ; pull-ups optionnels prévus pour debug sonde)_

## Drivers existants

| Source | URL | License | Couvre | Maturité |
|---|---|---|---|---|
| — | — | — | ❌ aucun driver requis : composant 100 % matériel | — |

## Breakouts disponibles

- **Adafruit #4755** (bq24074, cousin direct) : https://www.adafruit.com/product/4755 — schéma open hardware CC-BY-SA, bonne référence de câblage
- **SparkFun Power Cell / chargeurs bq2407x** : variantes selon stock
- **TI EVM** : BQ24075EVM, design de référence avec layout

## Notes spécifiques projet

- **EscapeBox** : U8 sur Main board. R_ISET = 890 Ω → I_CHG = 1,0 A. R_ILIM = 1,5 kΩ.
- CE→GND (charge ON), SYSOFF→GND (obligatoire, jamais flottant).
- **TMR : R_TMR 56 kΩ 1 % vers VSS** (schéma, 2026-09-27) → t_MAXCHG = 10 × K_TMR × R_TMR
  = **5,6 à 9,3 h** (K_TMR 36-60 s/kΩ), t_PRECHG 34-56 min. Une charge de 3000 mAh à 1 A
  dure ~4 h, donc pas de faux défaut ; le timer se ralentit quand DPPM réduit le courant.
  Auparavant TMR→GND, c'est-à-dire **timers de sécurité désactivés** (§6.1).
- **TS : NTC 10 kΩ de la cellule** (schéma du 2026-09-27) — net `BAT_TS`, broche 3 de J2
  (JST-PH **4** broches) ; **retour de la NTC sur J2.4 = GND** (VSS), pas sur BAT− : la TS
  mesure par rapport à VSS, et BAT− est séparé de GND par les MOSFET du FS8205 (audit
  2026-09-27 H2). `R_TS` (10 kΩ fixe) est conservée sur le PCB mais **en DNP** :
  montée en même temps que la NTC, elle fausserait la mesure et le chargeur suspendrait
  la charge **sans aucun symptôme visible**. Monter l'une **ou** l'autre, jamais les deux,
  et jamais aucune des deux (TS flottante = charge suspendue aussi).
  Fenêtre de charge obtenue : **0-50 °C** [§8.5, note (1)].
- _(historique : une résistance fixe de 10 kΩ était prévue tant que la batterie retenue
  n'avait pas de thermistance ; le choix d'une cellule 18650 avec NTC collée la remplace.)_
  ⚠ L'ancien schéma utilisait un diviseur 10k/10k vers VSYS — incorrect : TS est polarisée
  par une source de courant interne 75 µA, un diviseur vers VSYS fausse la tension et peut
  suspendre la charge silencieusement (CHG reste bas → aucun symptôme visible).
- **EN1/EN2 : mode RILIM retenu** (décision 2026-06-11) : EN2=VSYS (H), EN1=GND (L)
  → entrée limitée à ~1,07 A par R_ILIM = 1,5 kΩ, la charge atteint son 1 A.
  Implique un chargeur USB ≥ 1,5 A (pas un vieux port USB-A 500 mA — VIN-DPM
  n'est actif qu'en modes USB100/500, EN2=L).
- OUT = VSYS (5,5 V sur USB, VBAT sur batterie) → alimente les 2 AP2112K + MT3608.

## Sources

- Datasheet officiel SLUS810N : https://www.ti.com/lit/ds/symlink/bq24075.pdf
- Page produit TI : https://www.ti.com/product/BQ24075
- Breakout de référence Adafruit bq24074 : https://www.adafruit.com/product/4755
