GillesClerc/blackbox/docs/datasheets/FS8205.md

# FS8205

> _Synthèse de la datasheet Fortune Semiconductor FS8205 rév. 1.7 (fichier local [./FS8205.pdf](./FS8205.pdf))._

**Fabricant** : Fortune Semiconductor Corporation
**Catégorie** : Double MOSFET canal N (drain commun) pour protection batterie Li-ion
**Référence officielle** : FS8205 / FS8205A (SOT23-6)
**Datasheet source** : https://wmsc.lcsc.com/wmsc/upload/file/pdf/v2/lcsc/1811081616_Fortune-Semicon-FS8205A_C32254.pdf

## Vue d'ensemble

Deux MOSFET N à drain commun (D12), utilisés en série sur le négatif d'une cellule
Li-ion et pilotés par un DW01A (grille 1 = décharge, grille 2 = charge).

## Package & Footprint

- **Package** : SOT23-6 (vue de dessus : G1 / D12 / G2 en haut, S1 / D12 / S2 en bas)
- **Empreinte LCSC** : C32254 (FS8205A)

## Pinout (SOT23-6)

| Pin | Nom | Fonction |
|---|---|---|
| 1 | S1 | Source MOSFET 1 |
| 2 | D12 | Drain commun |
| 3 | S2 | Source MOSFET 2 |
| 4 | G2 | Grille MOSFET 2 |
| 5 | D12 | Drain commun |
| 6 | G1 | Grille MOSFET 1 |

_(brochage **confirmé le 2026-09-27** sur la datasheet, §4 « Pin Assignment », SOT23-6
vue de dessus : 1 S1, 2 D12, 3 S2 / 6 G1, 5 D12, 4 G2 — capture fournie par Gilles, le
PDF local n'ayant pas de texte extractible. Le schéma KiCad est conforme.)_

## Paramètres électriques

| Param | Valeur | Unité | Note |
|---|---|---|---|
| V_DS | 20 | V | abs max |
| V_GS | ±12 | V | abs max |
| I_D continu @ 25 °C / 70 °C | 6 / 5 | A | |
| I_DM pulsé | 25 | A | |
| R_DS(on) @ V_GS 4,5 V, I_D 4 A | ≤ 28 | mΩ | max |
| R_DS(on) @ V_GS 2,5 V, I_D 3 A | ≤ 37 | mΩ | max |
| P_D @ 25 °C | 1 | W | |
| Rth j-a | 125 | °C/W | max |

## Notes spécifiques projet

- **U10** : pin 1 (S1) = VBAT− (J2.2), pin 6 (G1) = OD du DW01A, pins 2/5 = drain commun,
  pin 3 (S2) = GND carte, pin 4 (G2) = OC du DW01A → conforme ✓.
- Deux R_DS(on) en série (≈ 56–74 mΩ) fixent le seuil de surintensité du DW01A (voir `DW01A.md`).

## Sources

- Datasheet : https://wmsc.lcsc.com/wmsc/upload/file/pdf/v2/lcsc/1811081616_Fortune-Semicon-FS8205A_C32254.pdf
