GillesClerc/blackbox/docs/datasheets/MT3608.md

# MT3608

> _Synthèse de la datasheet Aerosemi MT3608 (fichier local [./MT3608.pdf](./MT3608.pdf))._

**Fabricant** : Xi'an Aerosemi Technology
**Catégorie** : Convertisseur boost DC-DC 1,2 MHz, switch intégré 4 A
**Référence officielle** : MT3608 (SOT23-6)
**Datasheet source** : https://datasheet.lcsc.com/lcsc/XI-AN-Aerosemi-Tech-MT3608_C84817.pdf (copie locale issue d'un miroir Olimex)

## Vue d'ensemble

Boost à fréquence fixe 1,2 MHz, entrée 2–24 V, sortie réglable jusqu'à 28 V, limite de
courant switch interne 4 A, PFM automatique à faible charge, protection thermique.
Topologie asynchrone : inductance + diode Schottky externes.

## Package & Footprint

- **Package** : SOT23-6
- **Empreinte LCSC** : C84817

## Pinout

| Pin | Nom | Fonction |
|---|---|---|
| 1 | SW | Sortie du switch de puissance (vers inductance et diode) |
| 2 | GND | Masse |
| 3 | FB | Feedback, régulé à 0,6 V (pont diviseur) |
| 4 | EN | Enable : haut = marche, bas = arrêt. Non utilisé → relier à IN |
| 5 | IN | Alimentation |
| 6 | NC | Non connecté |

## Paramètres électriques

| Param | Min | Typ | Max | Unité | Note |
|---|---|---|---|---|---|
| VIN opérationnel | 2 | — | 24 | V | abs max IN/EN 26 V |
| VOUT | — | — | 28 | V | SW jusqu'à 28 V |
| V_FB | 0,588 | 0,6 | 0,612 | V | |
| Courant d'arrêt (EN = 0 V) | — | 0,1 | 1 | µA | |
| Iq PFM (sans commutation) | — | 100 | 200 | µA | |
| Iq PWM (commutation) | — | 1,6 | 2,2 | mA | |
| Fréquence | — | 1,2 | — | MHz | |
| Rapport cyclique max | 90 | — | — | % | |
| EN V_IH / V_IL | 1,5 / — | — | — / 0,4 | V | |
| Limite de courant SW | — | 4 | — | A | VIN 5 V, D 50 % |
| Arrêt thermique | — | 155 | — | °C | |

## Dimensionnement

`VOUT = 0,6 V × (1 + R_haut / R_bas)`

⚠ Boost asynchrone : **EN bas ne coupe pas la sortie**, le chemin IN → inductance → diode
maintient VOUT ≈ VIN − V_F. Pour une vraie coupure du rail, un interrupteur de charge
(load switch) est nécessaire (conséquence de la topologie, pas une fonction du composant).

## Notes spécifiques projet

- **U7** : VSYS → rail `5V` (12 × WS2812B, PAM8406, connecteur J9).
- R_FB_H = 750 kΩ, R_FB_L = 100 kΩ → VOUT = 5,1 V (5,0–5,2 V avec la tolérance de V_FB) :
  sous le max absolu WS2812B (5,3 V) et dans la plage PAM8406 (≤ 5,5 V) ✓.
- **L1 = Sunlord SWPA5040S6R8MT** (6,8 µH ±20 %, Isat 2,9 A — `SWPA5040S.md`, décision 2026-09-27 ; remplace un 22 µH 1210 sans référence). D1 = **SS34** (`SS34.md`). C_B2 22 µF en sortie ; **C_B1 22 µF 16 V en entrée** (passé de 10 à 22 µF le 2026-09-27 : la datasheet recommande 22 µF céramique en entrée et en sortie, « Capacitor Selection »).
- EN actuellement relié à VSYS (toujours actif). Pilotable en 3,3 V (V_IH 1,5 V).
- Courant de charge estimé et limites : voir audit `docs/audits/2026-09-23-hardware-db.md`.

## Sources

- Datasheet : https://datasheet.lcsc.com/lcsc/XI-AN-Aerosemi-Tech-MT3608_C84817.pdf
