GillesClerc/blackbox/docs/audits/2026-09-27-audit.md

# Audit complet — 2026-09-27

Périmètre : hardware Main (schéma KiCad, BOM), firmware, web/API, base de données, outils,
documentation (FSD, BOM, netlist documentée). Satellites : pas de schéma, seulement les
constats du 23/09 repris.

Base : commit `5cf7de7`, plus la sauvegarde KiCad **non commitée** de 14:01 (fichiers
`hardware/main/*.kicad_sch` et `.kicad_pro`). La synthèse vivante qui en découle est
`RESTE-A-FAIRE.md`. Les audits du 23/09 restent la référence pour le détail des points déjà
soldés.

## Méthode

- Netlist reconstruite par `tools/kicad_netlist.py` (6 feuilles, 145 symboles, 134 nets,
  499 broches) sur l'état actuel **et** sur `HEAD`, puis comparée. Pas d'ERC/DRC ici
  (kicad-cli absent du container) : le dernier rapport `ERC.rpt` (13:11) liste 5 erreurs,
  traitées dans `5cf7de7`.
- Chaque bloc confronté à sa synthèse `docs/datasheets/*.md` et, pour les points neufs, au
  PDF (`tools/pdf_text.py`) : bq24075, DW01A, FS8205, AP2112, MT3608, PAM8406, AS04008PO,
  WS2812B V5, AO3401A, 2N7002, LSM6DSOX, ESP32-S3 + WROOM-1 + guide de conception.
- BOM : `tools/check_bom.py`, puis relecture ligne par ligne des **deux** fichiers BOM.
- Firmware : relecture de `main/` et des composants (hors cJSON, minimp3 et assets), des
  conventions CLAUDE.md et de `sdkconfig`. Tests host relancés : validateur 26/26 et
  crypto OK.
- Web : routes `/api/box/*`, `lib/box-auth.ts`, `next.config.ts`, `package.json`.

**Verdict** : le schéma Main est électriquement propre, et ses corrections du 23/09 sont
toutes vérifiées sur la netlist. Il reste **trois points à régler avant de router** (H1-H3),
**quatre décisions de placement** (H4-H7), et une **BOM de référence qui dit autre chose
que le schéma** (H8) : ce dernier point ne bloque pas le routage, mais il faut le régler
avant toute commande. Le firmware et le web n'ont pas bougé depuis le 23/09 : leurs points
ouverts restent valables. S'y ajoutent des écarts avec le nouveau hardware (F1-F6).

---

## 1. Hardware — carte Main

### État de la sauvegarde KiCad non commitée

À la connectivité près, la netlist est **identique à `HEAD`**. La sauvegarde a seulement :
- **annoté les points de test** : `TP_VBUS` → `TP_VBUS1`, etc. (13 références). La BOM et
  `docs/pcb/03-validation-qualite.md` utilisent encore les anciens noms, et
  `check_bom.py` signale 13 écarts ;
- retourné R_VCC (broches 1/2 échangées, sans effet sur une résistance) ;
- laissé **deux bouts de fil pendants** sur la feuille `power` : (86,36 ; 161,29) → 162,56,
  superposé à `C_U9`, et (124,46 ; 162,56) → 167,64, **dessiné sur le corps de `R_CS`**
  mais ne touchant que sa broche 2. Aucun effet électrique, mais l'ERC les signalera et
  le second trompe à la lecture.

### 🔴 À régler avant de router

**H1 — L1 (boost MT3608) : aucune référence choisie, empreinte 1210.**
La datasheet recommande 4,7 à 22 µH et demande de tenir compte du courant de saturation
[MT3608, « Inductor Selection »]. En boost, le courant moyen dans l'inductance vaut
I_OUT × V_OUT / (V_IN × η). Avec 1 A sur le rail 5 V (12 LEDs à 432 mA + audio + halo J9),
V_IN = 3,4 V en fin de batterie et η ≈ 0,85 (hypothèse, à mesurer au proto), on obtient
**≈ 1,8 A**. Le ripple reste faible (≈ 0,05 A en 22 µH, ≈ 0,2 A en 4,7 µH à 1,2 MHz).
Il faut donc une inductance avec **I_sat ≥ ~2,5 A** et une DCR faible. La BOM ne donne ni
référence ni LCSC (« Inductance 22uH, 1210 »), et le choix fixe l'empreinte.
→ Choisir la référence et télécharger sa fiche **avant le placement**. Une 4,7-10 µH
blindée d'environ 5 × 5 mm est l'ordre de grandeur habituel pour ce courant, mais c'est
sa fiche qui doit trancher.

**H2 — La NTC de la cellule revient sur `VBAT-`, pas sur `VSS`.**
J2 = BAT+ / BAT− / NTC : l'autre patte de la NTC collée sur la cellule rejoint donc
BAT− = `VBAT-`, le négatif de la cellule **avant** les MOSFET de protection. La TS du
bq24075 mesure par rapport à VSS (= `GND`), en injectant **I_NTC = 75 µA**, avec un seuil
chaud **V_HOT = 300 mV** (270-330) et un seuil froid V_COLD = 2,1 V [bq24075 §8.5,
« Battery-pack NTC monitor »]. Pendant la charge, le courant traverse les deux MOSFET du
FS8205 : **56-74 mV à 1 A** (2 × R_DS(on) ≤ 28 mΩ à V_GS 4,5 V, ≤ 37 mΩ à 2,5 V
[FS8205]). Cette tension s'ajoute à la mesure :
- le seuil chaud n'est atteint que pour R_NTC ≈ (0,30 − 0,065) / 75 µA ≈ 3,1 kΩ au lieu
  de 4,0 kΩ, soit **≈ +7 °C** avec une NTC B ≈ 3950 : la coupure passe d'environ 47-50 °C
  à environ 54-57 °C (calcul avec l'équation B, pas la courbe Vishay exacte) ;
- après une décharge profonde, le DW01A laisse le MOSFET de décharge ouvert et la charge
  passe par sa diode interne (≈ 0,6 V) : **la protection en surchauffe disparaît** pendant
  toute la phase de récupération.
→ **J2 en JST-PH 4 broches** (BAT+, BAT−, NTC, retour NTC relié à `GND`), avec un
harnais de cellule à 4 fils. C'est un changement d'empreinte : à faire avant le
placement.

**H3 — FS8205 (U10) : brochage SOT-23-6 déduit, jamais lu.**
La synthèse précise « numérotation déduite de la vue de dessus » : le PDF local est une
image, sans texte extractible. Le schéma suit ce brochage (1 = S1 sur `VBAT-`, 2/5 = D12,
3 = S2 sur `GND`, 4 = G2 ← OC, 6 = G1 ← OD). Une erreur ici court-circuite ou isole la
batterie.
→ Ouvrir le PDF et confirmer à l'œil le dessin « Pin configuration » avant de router.
Au passage, la BOM annonce un TSSOP-8 pour C32254 : c'est le schéma (SOT-23-6) qui doit
faire foi, mais il faut vérifier sur la page LCSC que C32254 est bien en SOT-23-6.

### 🟠 Décisions à prendre avant ou pendant le placement

**H4 — BTN1/BTN2 (GPIO45/46) ne sortent nulle part.** Les deux nets restent sur la feuille
`esp32`, alors que le FSD place des boutons poussoir sur Côté 1 (§2.2.3) et une navigation
par GPIO45/46 (§6.4). J8.5 et J8.6 sont libres (J8 va justement vers Côté 1).
Si on les route :
- bouton **actif haut** vers 3V3_D, jamais de pull-up : GPIO45 à 1 au reset sélectionne
  une flash à 1,8 V et la box ne démarre plus [ESP32-S3 §3, `ESP32-S3-datasheet.md`] ;
- une pull-down externe est autorisée (elle confirme l'état 0 voulu) et utile sur un câble
  de 10-20 cm, car la pull-down interne ne fait que 45 kΩ [ESP32-S3, tableau des
  caractéristiques DC] ;
- un bouton maintenu pendant le reset reste un risque résiduel : c'est une contrainte de
  firmware (ne pas demander d'appui au démarrage) et d'ergonomie.
Sinon, on les laisse en réserve avec une pastille de test.

**H5 — Connecteurs I2C : 4 sur la carte, 5 faces satellites en ont besoin.** Devant
(BMP280, VEML7700), Dessus (ST25DV), Côté 1 (ADS7830), Côté 2 (MTCH2120) et Côté 3
(MLX90614, TMAG5273) ont chacun des composants I2C. Il faut soit un 5ᵉ connecteur J3-J6,
soit un chaînage (un satellite avec deux connecteurs Qwiic). La question est déjà ouverte
au FSD, mais elle devient bloquante au placement.

**H6 — Où sort le port USB-C ?** Le FSD place le « port USB-C réel » (charge + énigme de la
clé) sur **Côté 2**, mais J1 (USB-307HB-B-SU, vertical) est soudé sur la Main, qui est la
face **Dessous**. Il faut trancher entre :
- une rallonge USB-C panneau vers Côté 2 : impédance et longueur à respecter pour
  l'USB 2.0, et l'ESD se déplace ;
- un port en face Dessous : le FSD est à corriger ;
- une Main orientée pour que J1 affleure un côté.
Ce choix influence aussi l'énigme de la clé USB (S7 : fournir le VBUS en mode host).

**H7 — Antenne du module et entourage.** Le module doit être en bord de carte, avec au moins
15 mm de dégagement une fois en boîtier et sans module placé au centre avec évidement
[guide de conception ESP32-S3, `ESP32-S3-WROOM-1-hardware-design-guidelines.md`]. Sur la
face Dessous, l'antenne a pour voisins la cellule 18650 (enveloppe acier) et l'aimant du
haut-parleur. → À intégrer dès le placement : antenne au bord opposé à la cellule, et pas
de cuivre sous l'antenne.

### 🟠 BOM de référence (avant toute commande)

**H8 — `hardware/main/BOM/02-bom-lcsc.csv` (celle que lit `check_bom.py`) contredit le
schéma.**

| Ligne BOM | BOM dit | Schéma / décision |
|---|---|---|
| U11 (Main) | **PN5321A3HN, lecteur NFC**, C28925 | **LSM6DSOXTR** (C481766) — la carte recevrait un PN532 |
| U21 (Satellite) | LSM6DSOXTR | Doublon : l'IMU est sur la Main depuis le 21/09 |
| R1, R2 | **100 Ω** | **470 Ω** (filtre de sortie du DAC [PCM5122 §8.3.5.2]) |
| C21, C22 | **22 nF**, sans diélectrique | **2,2 nF NP0/C0G** (même filtre, f_c ≈ 153 kHz) |
| U25 | TMAG5273**A2** | **A1** (±40/80 mT, décision du 23/09 [TMAG5273, tableau 6-2]) |
| U10 | TSSOP-8 | SOT-23-6 au schéma (voir H3) |
| « — » bouche | SSD1680 e-ink 2,9" | Écran bouche **non choisi, pas e-ink** |
| J7b | « vers SSD1680 e-ink » | idem |
| R_PG, R_CHG | « DNP par défaut » | montées au schéma |
| D1, Q1, Q2 | code LCSC dans la colonne MPN | colonne LCSC vide → comptées « sans LCSC » |
| J9 | « 32 LEDs ≈ 1,9 A » | objectif retiré (décision du 27/09) |
| J8 | « réserve GPIO3 » | J8.5 non connectée depuis le 27/09 |
| U3 | « 5W+5W » | 1,8 W/canal max sur 8 Ω [PAM8406] |
| L1 | « 22uH recommandé datasheet » | la datasheet dit 4,7-22 µH ; référence à choisir (H1) |
| TP_* | anciens noms | `TP_xxx1` depuis la sauvegarde KiCad |
| — | haut-parleur absent | AS04008PO-2-R (hors carte, comme SW3) |

`docs/pcb/02-bom-lcsc.csv` est une **seconde BOM, plus ancienne**, qui a divergé
(FB1/FB2 encore présentes, noms `C1_AV`… faux, R_MODE_D en double). Deux BOM, c'est une
dérive garantie.
→ Corriger la BOM de `hardware/main/`, supprimer celle de `docs/pcb/` (ou la générer), et
faire comparer par `check_bom.py` **la MPN et les valeurs des lignes à plusieurs
références** : il n'a vu ni U11 ni R1/R2/C21/C22, justement parce qu'il ne regarde que les
lignes à une seule référence et jamais la MPN.

### 🟡 Faible

- **H9 — Rail 5 V et max absolu WS2812** : 5,3 V [WS2812B V5]. Sur USB, V_OUT(REG) du
  bq24075 peut atteindre 5,6 V avec une source haute [bq24075], donc 5V_BOOST ≈ VSYS −
  V_F(D1) ≈ 5,2-5,3 V (boost inactif quand V_IN > V_OUT). Avec une source USB conforme
  (≤ 5,25 V), on reste vers 4,9 V. Risque marginal, à mesurer au proto (TP_5V) avec
  plusieurs chargeurs.
- **H10 — Charge sur un port PC à 500 mA** : mode R_ILIM = 1,07 A, CC en 5,1 kΩ sans
  détection de capacité de la source, et VIN-DPM inactif dans ce mode [`bq24075.md`, table
  EN1/EN2]. Un port USB 2.0 peut couper ou s'effondrer. C'est assumé (chargeur ≥ 1,5 A
  requis), mais à écrire dans la notice et à tester.
- **H11 — UART0 (TXD0/RXD0) sans pastille** : c'est la seule console si l'USB natif ne
  répond plus (firmware planté tôt, USB mal soudé). Deux pastilles coûtent peu, et le
  guide Espressif recommande aussi une pull-up externe sur GPIO0 (pull-up interne seule
  aujourd'hui, `TP_GPIO0` présent).
- **H12 — J12 fait sortir VSYS dans un câble** vers l'interrupteur. Les protections
  existent (court-circuit OUT du bq24075, DW01A), mais une résistance série de 1-10 kΩ
  sur la broche VSYS de J12 limiterait un défaut de câble à quelques mA. EN_SYS ne
  consomme rien (R20 = 100 kΩ). Remarque de conception, pas une exigence datasheet.
- **H13 — Micro ICS-43434 bottom-port sur une carte en face Dessous** : son trou traverse
  la carte vers la table, ou vers l'intérieur du cube selon la face de montage. À prévoir
  avec le boîtier (conduit acoustique ou orientation), sinon le test « claquement à 1 m »
  risque d'échouer.
- **H14 — Fenêtre de charge 0-50 °C vs cellule** : beaucoup de cellules 18650 limitent la
  charge à 45 °C. À vérifier sur la fiche de la cellule choisie. Si c'est le cas, la
  fenêtre du bq24075 se resserre avec deux résistances autour de la NTC (formules dans la
  section TS de la datasheet, « IC's Hot/Cold Trip Threshold »).
- **H15 — Synthèse `LSM6DSOXTR.md` : tableau de brochage faux** (broches 4 à 14). Le
  **schéma est juste** : 4 INT1, 5 VDDIO, 6-7 GND, 8 VDD, 9 INT2, 10 OCS_Aux, 11 SDO_Aux,
  12 CS, 13 SCL, 14 SDA [DS12814 p. 8, tableau 2]. **Synthèse corrigée le
  2026-09-27.**
- **DW01A (rappel, non modifié)** : seuil de surintensité 1,6-3,2 A selon la dispersion
  [DW01A V_OI1 120-180 mV / 2 × R_DS(on)]. Le pire cas (LEDs blanches, audio fort, WiFi TX,
  batterie basse) peut s'en approcher par le bas → plafonds firmware (F1) et mesure au
  proto (FSD §8.1.1, « charge crête »).

### Contraintes de layout (rappel consolidé)

- **U5 (AP2112M SO-8)** : plan de cuivre sous et autour (θJA 114 °C/W ; +64 °C à 0,56 W sous USB).
- **bq24075** : pad exposé sur GND avec vias thermiques ; VSS (broche 8) raccordée aussi.
- **Boost** : boucle SW → L1 → D1 → C_B2 → GND la plus courte possible ; C_B1 au pied de IN.
- **USBLC6 (U12)** au plus près de J1 [USBLC6-2 §2.3].
- **ICS-43434** : C3 au plus près des broches 5 et 3, sans via [ICS-43434] ; trou du micro (H13).
- **Audio** : PCM5122 + PAM8406 dans un coin, pas de piste numérique dessous, **GND unique
  continu (pas de split)** ; I2S court et groupé.
- **EN (RC 10 k / 1 µF)** : piste courte [guide Espressif].
- **Antenne** : H7.
- **Points de test** : nom sérigraphié, regroupés face Dessous, une masse qui accepte une pince.

### ✅ Vérifié conforme (netlist actuelle)

- Tous les points 🔴/🟠 du 23/09 sont présents dans la netlist : C20 sur VNEG–GND, C19 sur
  CAPP–CAPM, J10 + FB3-FB6 (`HP_x → FBn → SPK_x → J10`), J3-J6 en Qwiic (1 = GND,
  2 = 3V3_D), R15-R19 (10 k) sur les 5 lignes SD dont `SD_DAT1`/`SD_DAT2`, R13/R14 22 Ω
  + C_CLK2/3 en DNP, R_TMR 56 k, NTC sur `BAT_TS` avec R_TS en DNP, D1 SS34, U5 en SO-8.
- **U5 AP2112M** : 1 = VOUT, 5 = EN, 6/7 = GND, 8 = VIN, conforme au dessin SO-8
  [`AP2112.md`] ; EN_SYS ≤ 5,6 V < V_IH max 6,0 V [AP2112].
- **Marche/arrêt** : EN_SYS → EN de U5/U6/U7 + grille de Q2 ; R20 100 k en pull-down.
  Q1 AO3401A : S = 5V_BOOST, D = 5V, R21 grille-source, diode interne orientée pour ne
  pas alimenter le 5 V à l'arrêt ; R_DS(on) < 60 mΩ à V_GS −4,5 V [AO3401A]. Q2 2N7002 :
  V_GS(th) ≤ 2,0 V, conduit sur toute la plage batterie [2N7002]. MT3608 : EN V_IH 1,5 V,
  arrêt ≤ 1 µA [MT3608]. Consommation éteinte estimée : ≈ 15-20 µA (sommeil BAT du
  bq24075 4,3-6,5 µA, DW01A, pont VBAT 2 µA, pont FB du boost ≈ 4,4 µA via L1/D1,
  veilles AP2112/MT3608 ≤ 1 µA chacune) → cohérent avec le critère ≤ 20 µA du FSD §8.1.1,
  à mesurer.
- **bq24075** : brochage [§6.1], EN2 = VSYS / EN1 = GND (R_ILIM), CE et SYSOFF à GND,
  ISET 890 Ω (1 A), ILIM 1,5 k, TMR 56 k, PGOOD/CHG en pull-up 100 k vers 3V3_D (open-drain :
  aucun courant quand 3V3_D est coupé).
- **DW01A + FS8205** : R_VCC 100 Ω / C_U9 100 nF, R_CS 1 k vers GND (P−), TD non connectée,
  OD → G1, OC → G2, sous réserve de H3 [DW01A, application typique].
- **MT3608** : FB 750 k / 100 k → 5,1 V (5,0-5,2 V) [MT3608].
- **PAM8406** : R_MODE_D montée / R_MODE_AB en DNP (jamais les deux), MUTE et SHDN tirés
  hauts, VREF 1 µF, découplage 3 × 1 µF + 22 µF, sorties en pont sans masse commune [PAM8406].
- **LSM6DSOX** : CS = VDDIO (I2C), SA0 = GND (0x6A), SDx/SCx → GND (« connect to VDDIO or
  GND »), OCS_Aux et SDO_Aux non connectées (« leave unconnected »), INT1 flottante =
  pull-down interne, I2C + I3C actifs [DS12814 tableau 2, §5] ; C4/C5 100 nF.
- **ESP32** : EN RC 10 k / 1 µF ; C1 10 µF + C2 100 nF ; USB série 22 Ω ; VBAT_SENSE sur
  ADC1_CH2 avec 100 nF ; GPIO35-37 non connectées (PSRAM octale) [guide Espressif].
- **Carte SD** : brochage microSD standard (1 DAT2, 2 CD/DAT3, 3 CMD, 4 VDD, 5 CLK, 6 VSS,
  7 DAT0, 8 DAT1), CD non connectée.
- **WS2812** : chaîne R8 330 Ω → LED2 … LED13 → J9.3, pilotage en 3,3 V (V_IH 2,7 V) [WS2812B V5].

---

## 2. Firmware

Aucun changement de code depuis le 23/09. Les points ouverts à cette date restent valables
(WiFi, BLE, OTA, hygiène : voir `2026-09-23-audit.md`). S'y ajoutent les écarts avec le
hardware rév. actuelle.

- **F1 — LEDs** (`hal_leds.c`, `main.c`) : `hal_leds_init(48, 1)` alors qu'il y en a 12,
  plus la chaîne J9 ; timings hors spécification V5 (T0H 0,4 µs > 380 ns, T1L 0,45 µs
  < 580 ns ; il faut 0,3/0,9 et 0,8/0,6 µs [WS2812B V5]). **Aucun plafond global de
  luminosité** : `action_flash` pousse jusqu'à 255 sur toutes les LEDs (12 × 36 mA =
  432 mA en blanc). `s_buf` et `hal_leds_show` sont appelés sans mutex depuis flash_task
  (cœur 0), le moteur de scénario et le menu de boot : glitches visuels possibles.
- **F2 — Audio** (`hal_audio_set_volume`) : 100 % = 0 dB. Plafond à poser vers **−22 dB**
  (0x5C) pour le haut-parleur 8 Ω / 1 W [`PAM8406.md`, `AS04008PO.md`] ; alternative
  propre, le gain analogique −6 dB (page 1, reg. 0x02) plus un plafond numérique réduit
  d'autant. La loi de volume est linéaire en pas de 0,5 dB : 50 % donne déjà −51 dB, il
  faut une courbe utilisable. **Un seul haut-parleur, sur L** (J10.1-2) : les sources
  stéréo perdent leur canal R → mixage mono (L+R)/2 dans le mixer, et R coupé
  numériquement.
- **F3 — Extinction sur batterie basse** : aucun code ADC (VBAT_SENSE non lu). Seuil
  ~3,4-3,5 V (MTCH2120 et ESP32 ≥ 3,0 V après le dropout de l'AP2112). Le pont 1 M // 1 M
  impose un échantillonnage lent (C_VBAT_SENSE 100 nF).
- **F4 — Drivers capteurs** : `hal_imu` vise l'IMU à **400 kHz** alors que le bus est
  plafonné à **100 kHz par le MLX90614** [MLX90614 §3.2] ; il contient 7
  `ESP_ERROR_CHECK` sur des accès I2C (IMU absente ou défaillante → abort → reboot en
  boucle, contraire à CLAUDE.md), et il n'est pas branché (l'inclinaison est simulée par
  un appui long). `hal_light` (VEML7700, **satellite débranchable**) a le même défaut.
  **Drivers inexistants** : TMAG5273, MLX90614, BMP280, ADS7830, ST25DV (`hal_nfc` est
  l'ancien PN532), servo, micro I2S. Le FSD les disait « écrits » pour certains.
- **F5 — MTCH2120** : toujours en 0x28 et registres 8 bits (voir le 23/09).
- **F6 — Boutons GPIO45/46** : rien côté firmware ; dépend de H4.
- **F7 — Verrouillage PLL du PCM5122 mal lu** (`hal_audio.c`, init) : le code lit le
  registre **0x05**, marqué « Reserved. Do not access », et affiche « locked » quand
  bit 4 = 1. Le flag est au **registre 4, bit 4 (PLCK), 0 = verrouillé, 1 = non
  verrouillé** [PCM5122 tableau 57, « Page 0 / Register 4 »]. Le son fonctionne quand
  même, mais le log « PLL locked » cité comme preuve de validation le 23/09 n'a pas de
  valeur. La synthèse `pcm5122-registers.md` ne mentionne pas PLCK : à compléter.
- **F8 — `yaml2json.py` ne connaît pas `eye_blink`/`eye_emotion`/`eye_look`** : ces
  actions ne font qu'un avertissement (« action inconnue ») alors que le firmware les
  exécute ; `servo` y est encore listée.

Rappels du 23/09, toujours ouverts : reconnexion WiFi et sync périodique, BLE LE Secure
Connections + fermeture de la fenêtre après `wifi_ok`, OTA (mark_valid, sha256/signature,
MP3 embarqué d'1 Mo à retirer : binaire à 2,63 Mo pour 3 Mo de partition), raccourcis
debug du keypad hors mode dev, borne sur `count` (`action_flash`), `voice_stop_wait` qui
peut expirer, licences cJSON/NimBLE, `dependencies.lock` gitignoré, code mort. Nouveau et
mineur : coredump désactivé (`CONFIG_ESP_COREDUMP_ENABLE_TO_NONE`), utile pour le terrain
(il faudrait une partition dédiée).

## 3. Web et base de données

Aucun changement depuis le 23/09 ; tous les points restent ouverts : licences liées à la
box plutôt qu'à l'utilisateur (à trancher avant Stripe), migrations SQL versionnées,
contraintes `firmware_releases`, `/register` qui répond 500 sur une course (23505) au lieu
de 409, version de scénario en double (DB + manifest), clé JWT = master brut (le
commentaire « dérivée » de `box-auth.ts` est faux), pas de rate limiting (WB-11), pas
d'en-têtes de sécurité (`next.config.ts` vide), `shadcn` en `dependencies`, pas de CI.
Précision : aucune révocation de JWT (WB-12) — une box retirée d'un compte garde son
token jusqu'à 2 h.

## 4. Documentation

- **FSD** : une trentaine de passages périmés ou contradictoires (drivers annoncés écrits
  qui n'existent pas, commande de flash en 8 Mo à 0x10000, UUID et sécurité BLE qui ne
  sont pas ceux du code, API §6.1 différente des routes réelles, AP2112K/SS14/J2 en 2
  broches/J9 à 1,9 A, AGND/PGND séparées contre « GND unique », servos et AS5600 retirés
  mais toujours dans les exigences). **Nettoyé le 2026-09-27** (voir le journal en tête
  du FSD).
- **BOM** : deux fichiers qui divergent, et une référence fausse (H8).
- **`docs/pcb/01-netlist.txt`** : en retard sur KiCad (section power, J8.5 encore sur
  VBAT_SENSE, pas de J10/J12/Q1/Q2). KiCad est désormais la source de vérité : ce fichier
  est à régénérer depuis `kicad_netlist.py` ou à archiver.
- **`docs/schematics/*.txt`** : schémas ASCII d'avant KiCad (ILI9488, XPT2046, PN532,
  AS5600, SS14…) → à archiver.
- **CLAUDE.md** : « Reste : BLE + option B (F5), OTA (F6) » contredit « Enregistrement
  box (dette soldée, F5) » quelques lignes plus haut ; seul le parcours E2E navigateur
  reste pour F5 (`docs/plans/firmware-cloud-client.md`).

## 5. Sécurité produit (inchangé)

Secure Boot et flash encryption désactivés (secret de la box en clair en NVS), packages
de scénario en clair sur la SD, pas de signature des scénarios ni du firmware (FW-02/WB-05
non réalisés). Acceptable en prototype, pas à la vente.
