GillesClerc/blackbox/docs/datasheets/AP2112.md

# AP2112 (AP2112K-3.3)

> _Synthèse de la datasheet Diodes Inc. DS32315 (fichier local [./AP2112.pdf](./AP2112.pdf)). Valeurs relevées dans le PDF — ne pas compléter de mémoire._

**Fabricant** : Diodes Incorporated
**Catégorie** : Régulateur linéaire LDO CMOS 600 mA avec enable
**Référence officielle** : AP2112K-3.3TRG1 (SOT-23-5 « SOT25 »)
**Datasheet source** : https://www.diodes.com/assets/Datasheets/AP2112.pdf

## Vue d'ensemble

LDO 600 mA garantis (min), dropout 250 mV typ à 600 mA, Iq 55 µA, stable avec 1 µF
céramique. Entrée EN active haute avec pull-down interne, décharge active de la sortie
quand EN est bas. Protection courant (foldback, 50 mA en court-circuit) et thermique (160 °C).

## Package & Footprint

- **Packages et codes de commande** : SOT25 = **AP2112K**, SOT89-5 = **AP2112R5**,
  SO-8 = **AP2112M**
- **Empreintes LCSC** : C51118 (AP2112K-3.3TRG1, SOT-25) · **C5290219**
  (AP2112M-3.3TRG1, SO-8)

### Brochage SO-8 (≠ SOT-25 !)

Relevé sur le dessin « Pin Assignments (Top View) » de la datasheet (le tableau
correspondant n'est pas extractible en texte) :

| Broche | Fonction |
|---|---|
| **1** | VOUT |
| 2, 3, 4 | NC |
| **5** | EN |
| **6, 7** | GND (les deux à relier) |
| **8** | VIN |

⚠ Rien à voir avec le SOT-25 (1 = VIN, 2 = GND, 3 = EN, 4 = NC, 5 = VOUT) : ne jamais
transposer une empreinte d'un boîtier à l'autre sans refaire le brochage.

## Pinout (SOT25)

| Pin | Nom | Fonction |
|---|---|---|
| 1 | VIN | Entrée |
| 2 | GND | Masse |
| 3 | EN | Enable : H = marche, L = arrêt (pull-down interne 3 MΩ) |
| 4 | NC | Non connecté |
| 5 | VOUT | Sortie |

## Paramètres électriques (AP2112-3.3, VIN = 4,3 V, CIN = COUT = 1 µF)

| Param | Min | Typ | Max | Unité | Note |
|---|---|---|---|---|---|
| VIN (recommandé) | 2,5 | — | 6,0 | V | abs max 6,5 V |
| VOUT | 3,251 | 3,3 | 3,350 | V | ±1,5 %, 1–30 mA |
| IOUT(MAX) | 600 | — | — | mA | garanti |
| Dropout @ 10 mA | — | 5 | 8 | mV | |
| Dropout @ 300 mA | — | 125 | 200 | mV | |
| Dropout @ 600 mA | — | 250 | 400 | mV | |
| Iq | — | 55 | 80 | µA | IOUT = 0 |
| I standby (EN bas) | — | 0,01 | 1,0 | µA | |
| PSRR 100 Hz / 1 kHz | — | 65 / 65 | — | dB | IOUT = 100 mA |
| EN V_IH | 1,5 | — | 6,0 | V | |
| EN V_IL | 0 | — | 0,4 | V | |
| EN pull-down | — | 3,0 | — | MΩ | |
| Décharge sortie (EN bas) | — | 60 | — | Ω | |
| Courant de court-circuit | — | 50 | — | mA | VOUT = 0 V |
| Arrêt thermique / hystérésis | — | 160 / 25 | — | °C | |
| θJA SOT25 / SOT89-5 / SO-8 | — | 184 / 120 / 114 | — | °C/W | sans dissipateur |
| TJ max (abs) | — | — | 150 | °C | |

Condensateurs : 1 µF céramique mini en entrée et sortie, X7R/X5R recommandé (note 4).

## Interface

_(non applicable — composant analogique, seule l'entrée EN est logique)_

## Dimensionnement thermique

`P = (VIN − 3,3 V) × IOUT` ; `ΔT_J = P × θJA` (184 °C/W en SOT25).
Exemples : VIN 4,9 V / 250 mA → 0,40 W → +74 °C ; VIN 4,9 V / 400 mA → 0,64 W → +118 °C.
Sur batterie (VIN ≈ 3,7 V) la dissipation est faible (0,1 W à 250 mA).

## Notes spécifiques projet

- **U5** → `3V3_D` (ESP32, SD, écrans, satellites I2C, IMU) ; **U6** → `3V3_A` (PCM5122, ICS-43434).
- Entrée = VSYS (sortie bq24075) : ≈ VBAT sur batterie, ≈ VIN USB − dropout sur secteur ;
  V_OUT(REG) du bq24075 max 5,6 V < 6,0 V recommandé ✓.
- Budget 3V3_D : l'ESP32-S3 exige une alimentation ≥ 0,5 A (datasheet ESP32-S3 §5.2) ;
  pics TX WiFi 355 mA / BLE 344 mA (datasheet WROOM-1 §6.4). 600 mA garantis → marge
  faible une fois SD + écrans ajoutés.
- **Décision 2026-09-27** : **U5 (3V3_D) passe en SO-8** (`AP2112M-3.3TRG1`, LCSC
  C5290219) — θJA 114 au lieu de 184 °C/W, soit +64 °C au lieu de +103 °C à 0,56 W sous
  USB. **U6 (3V3_A) reste en SOT-25** : il n'alimente que le PCM5122 (~25 mA), il ne
  chauffe pas. Deux références du même LDO dans la BOM, c'est assumé.
  ⚠ Stock LCSC faible (~30 pièces en direct, ~2 660 chez d'autres fournisseurs sous
  3-5 jours) : suffisant pour les prototypes, à surveiller pour une série — et un
  composant « extended » à faible stock peut bloquer un ordre d'assemblage JLCPCB.
- Symbole : la bibliothèque KiCad officielle ne contient que les variantes K (SOT-25).
  Le symbole `lcsc_imported:AP2112M-3.3` a été créé dans la bibliothèque projet à partir
  du brochage ci-dessus, avec les positions de broches du symbole officiel pour que le
  câblage existant reste valable.
- EN : piloté par l'interrupteur marche/arrêt proposé (TODO FSD Phase 2).

## Sources

- Datasheet officiel : https://www.diodes.com/assets/Datasheets/AP2112.pdf
