GillesClerc/blackbox/docs/datasheets/2N7002.md

# 2N7002 — MOSFET N d'inversion de commande (Q2)

> _Synthèse de la datasheet **Diodes Incorporated DS30366** (fichier local
> [./2N7002.pdf](./2N7002.pdf))._

**Catégorie** : MOSFET canal N de signal, enrichissement
**Référence projet** : 2N7002 — **LCSC C8545** (fabricant **JSCJ / Jiangsu Changjing**)
**Datasheet source (PDF local)** : https://www.diodes.com/assets/Datasheets/ds30366.pdf

## ⚠ Fabricant du PDF ≠ fabricant approvisionné

Le PDF local est celui de **Diodes Inc.** ; le composant en stock chez LCSC/JLCPCB sous
C8545 est celui de **JSCJ**. Le 2N7002 est un type industriel standard (même brochage,
mêmes ordres de grandeur), mais **les valeurs fines diffèrent d'un fabricant à l'autre**.
Pour cet usage — tirer une grille de MOSFET, donc à courant nul — aucun paramètre critique
n'est en jeu ; si un jour ce transistor devait commuter un vrai courant, reprendre la
fiche JSCJ depuis la page LCSC.

## Package & Footprint

- **Package** : SOT-23 — empreinte KiCad `Package_TO_SOT_SMD:SOT-23`
- **Brochage** : **1 = G, 2 = S, 3 = D** (symbole KiCad `Transistor_FET:2N7002`)

## Paramètres électriques (datasheet Diodes)

| Param | Min | Typ | Max | Unité | Condition |
|---|---|---|---|---|---|
| **V_GS(th)** (seuil de grille) | **0,8** | 1,4 | **2,0** | V | V_DS = V_GS, I_D = 1 mA |
| R_DS(ON) | — | 3,2 | — | Ω | |
| V_GS max | — | — | ±20 | V | |
| I_GSS | — | — | ±100 | nA | |

Caractéristiques mises en avant par la datasheet : **seuil de grille bas**, faible
capacité d'entrée, commutation rapide.

## Notes spécifiques projet

- **Q2** (feuille `power`) : inverseur de commande du load switch Q1 (`AO3401A.md`).
  Grille sur `EN_SYS`, drain sur `GATE_5V`, source sur `GND`.
- **Pourquoi un inverseur** : Q1 est un P-MOS high-side, il conduit **grille basse**, alors
  que `EN_SYS` est **haut** quand la box est allumée. Q2 met `GATE_5V` à la masse dans ce
  cas ; sinon R21 (100 kΩ) ramène la grille à la source et Q1 reste bloqué.
- **Marge sur le seuil — vérification faite** : `EN_SYS` est à VSYS, soit **3,0 V au pire**
  (batterie en fin de décharge) contre un **V_GS(th) de 2,0 V maximum**. Q2 conduit donc
  dans toute la plage d'usage. Son R_DS(ON) élevé (3,2 Ω) est sans importance : il ne
  charge qu'une grille de MOSFET, à courant quasi nul (I_GSS ±100 nA).
- Le 2N7002 est donné pour un courant drain faible (~115 mA chez JSCJ) : **ne pas le
  réutiliser** ailleurs pour commuter une charge réelle.

## Sources

- Datasheet Diodes DS30366 : https://www.diodes.com/assets/Datasheets/ds30366.pdf
- LCSC C8545 (JSCJ) : https://www.lcsc.com/product-detail/C8545.html
