GillesClerc/blackbox/docs/datasheets/AO3401A.md

# AO3401A — MOSFET P, load switch du rail 5 V (Q1)

> _Synthèse de la datasheet Alpha & Omega Semiconductor, **rév. 3.1, décembre 2023**
> (fichier local [./AO3401A.pdf](./AO3401A.pdf))._

**Fabricant** : Alpha & Omega Semiconductor (AOS)
**Catégorie** : MOSFET canal P, technologie trench
**Référence officielle** : AO3401A — **LCSC C15127**
**Datasheet source** : http://www.aosmd.com/pdfs/datasheet/AO3401A.pdf

## Vue d'ensemble

MOSFET P à faible R_DS(ON), faible charge de grille, commandable dès **2,5 V de tension de
grille**. La datasheet le désigne explicitement comme convenant à un **usage en load
switch** — c'est exactement notre emploi.

## Package & Footprint

- **Package** : SOT-23 — empreinte KiCad `Package_TO_SOT_SMD:SOT-23`
- **Brochage (vue de dessus)** : **1 = G, 2 = S, 3 = D** (symbole KiCad
  `Transistor_FET:AO3401A`, conforme)

## Paramètres électriques (T_A = 25 °C sauf mention)

| Param | Min | Typ | Max | Unité | Condition |
|---|---|---|---|---|---|
| BV_DSS (tension drain-source) | −30 | — | — | V | |
| I_D (courant drain continu) | — | — | **−4,0** | A | V_GS = −10 V, T_A = 25 °C |
| **R_DS(ON)** | — | — | **< 50** | mΩ | V_GS = −10 V |
| **R_DS(ON)** | — | — | **< 60** | mΩ | **V_GS = −4,5 V** ← notre cas |
| R_DS(ON) | — | — | < 85 | mΩ | V_GS = −2,5 V |
| V_GS(th) (seuil) | −0,5 | −0,9 | −1,3 | V | |
| I_GSS (fuite de grille) | — | — | ±100 | nA | |
| R_θJA | — | 70 | 100 | °C/W | |
| T_J, T_STG | −55 | — | 150 | °C | |

## Notes spécifiques projet

- **Q1** (feuille `power`) : load switch du rail 5 V, entre `5V_BOOST` (sortie du MT3608
  après D1) et `5V` (12 WS2812 + PAM8406 + J9).
- **Pourquoi il est indispensable** : le MT3608 est un **boost asynchrone**. Même EN bas,
  VBAT passe par L1 puis D1 et le rail 5 V reste à VBAT − V_F : sans ce switch, les WS2812
  resteraient alimentées box éteinte (`MT3608.md`).
- **Orientation — le point qui casse ce montage s'il est inversé** : **Source côté boost,
  Drain côté charge**. La diode intrinsèque du P-MOS va du Drain vers la Source ; box
  éteinte, la source est à VBAT − V_F et le drain à 0 V, donc elle est **bloquée**. Dans
  l'autre sens, elle conduirait et le switch ne servirait à rien.
- **Pertes** : sous 5 V, V_GS = −5 V → R_DS(ON) ≈ 60 mΩ (valeur max à −4,5 V, donc
  pessimiste). À la charge réelle de 0,83 A : **50 mV de chute, 41 mW**. Même à 1,6 A :
  96 mV et 0,15 W, soit ~15 °C d'élévation à 100 °C/W. Confortable.
- **Commande** : la grille (`GATE_5V`) est tirée à la source par **R21 = 100 kΩ** (bloqué
  par défaut) et mise à la masse par **Q2** (2N7002) quand `EN_SYS` est haut — un P-MOS
  high-side conduit grille basse, alors que EN_SYS est haut box allumée, d'où l'inverseur.
- ⚠ **V_GS maximal** : ±12 V (abs. max, datasheet). Ici V_GS ne dépasse jamais 5,5 V. OK.

## Sources

- Datasheet AOS rév. 3.1 : http://www.aosmd.com/pdfs/datasheet/AO3401A.pdf
- LCSC C15127 : https://www.lcsc.com/product-detail/C15127.html
