GillesClerc/blackbox/docs/datasheets/SS14.md

# SS14

> _Synthèse de la datasheet Vishay SS12-SS16 (doc 88746, fichier local [./SS14.pdf](./SS14.pdf))._

**Fabricant** : Vishay General Semiconductor
**Catégorie** : Diode Schottky de redressement 1 A
**Référence officielle** : SS14 (DO-214AC / SMA)
**Datasheet source** : https://www.vishay.com/docs/88746/ss12.pdf

## Vue d'ensemble

Schottky 40 V / 1 A en boîtier SMA, faible chute directe, forte capacité de surcharge.

## Package & Footprint

- **Package** : DO-214AC (SMA) — empreinte KiCad `Diode_SMD:D_SMA`

## Pinout

| Pin | Nom | Fonction |
|---|---|---|
| 1 | K | Cathode (bande) |
| 2 | A | Anode |

## Paramètres électriques

| Param | Valeur | Unité | Note |
|---|---|---|---|
| V_RRM (SS14) | 40 | V | |
| I_F(AV) | 1,0 | A | courant moyen max à T_L (courbe de derating fig. 1) |
| I_FSM | 40 | A | 8,3 ms demi-sinus |
| V_F @ 1,0 A | 0,50 (SS12–SS14) / 0,75 (SS15–SS16) | V | valeur max datasheet |
| RθJA / RθJL | 88 / 28 | °C/W | typique |

## Notes spécifiques projet

- **D1** : diode de sortie du boost MT3608 (rail `5V`). Dans un boost, le courant moyen de
  la diode = courant de sortie. 1 A max → insuffisant pour la charge du rail 5 V.
  **❌ Plus utilisé sur le projet depuis le 2026-09-27** : D1 est passée au **SS34** (3 A,
  même empreinte SMA, LCSC C8678) — voir `SS34.md`. Cette fiche reste pour mémoire.

## Sources

- Datasheet officiel : https://www.vishay.com/docs/88746/ss12.pdf
