GillesClerc/blackbox/docs/datasheets/SS34.md

# SS34 — Schottky 40 V / 3 A, SMA (remplace le SS14 en D1)

> _PDF local [./SS34.pdf](./SS34.pdf) = **Vishay General Semiconductor, famille SS32 thru
> SS36**, révision du 02/04/2020._

**Catégorie** : diode Schottky de redressement 3 A, boîtier DO-214AC (SMA)
**Référence projet** : **SS34**
**Composant approvisionné** : **MDD (Microdiode Semiconductor) SS34 — LCSC C8678**,
référencé **Basic part** chez JLCPCB (pas de frais de composant étendu).

## ⚠ Limite de vérification — à lire avant de citer un chiffre

Deux précautions, conformes à la règle « datasheet d'abord » du projet :

1. **Le PDF local est celui de Vishay, pas celui du composant qui sera monté.** LCSC bloque
   le téléchargement automatisé de la fiche MDD depuis le container (renvoie une page HTML).
   Les deux sont des SS34 40 V / 3 A en SMA, mais **les valeurs fines diffèrent d'un
   fabricant à l'autre** (V_F, I_R, thermique) : pour tout chiffre critique, ouvrir la fiche
   MDD depuis la page LCSC C8678.
2. **Les tableaux du PDF Vishay ne sont pas extractibles en texte** dans le container : sa
   police perd les chiffres à l'extraction (« .0 A » au lieu de « 3.0 A »). Les valeurs
   ci-dessous viennent donc des **fiches distributeur**, identifiées comme telles, et non
   d'une lecture du PDF. À confirmer visuellement dans le PDF avant tout dimensionnement
   serré.

## Caractéristiques (source : fiches LCSC / JLCPCB du MDD C8678)

| Param | Valeur | Source |
|---|---|---|
| V_RRM (tension inverse répétitive) | 40 V | fiche LCSC C8678 |
| I_F(AV) (courant moyen redressé) | **3 A** | fiche LCSC C8678 |
| V_F à 3 A | 550 mV | fiche LCSC C8678 |
| I_R à 40 V | 500 µA | fiche LCSC C8678 |
| Boîtier | SMA (DO-214AC) | fiche LCSC + PDF Vishay |
| Marquage | « S4 » (famille Vishay : S2/S3/S4/S5/S6 selon la tension) | PDF Vishay, device marking code |

Caractéristiques qualitatives lisibles dans le PDF Vishay : faibles pertes, rendement
élevé, faible chute directe, **forte capacité de surcharge**, protection par avalanche
non répétitive, plage de température de jonction et de stockage étendue (valeurs
numériques non extractibles, cf. avertissement ci-dessus).

## Pourquoi le remplacement (audit 2026-09-23, A5)

Le MT3608 est un **boost asynchrone** : tout le courant de sortie passe par D1, donc le
courant moyen dans la diode **est** le courant du rail 5 V.

| Charge du rail 5 V | Courant | Source |
|---|---|---|
| 12 × WS2812B en blanc | 432 mA | `WS2812B-B.md` |
| PAM8406 sur 8 Ω, un haut-parleur | ≈ 400 mA | `PAM8406.md`, `AS04008PO.md` |
| **Total sans J9** | **≈ 0,83 A** | |
| J9 (LEDs externes, intention FSD) | jusqu'à ~1,9 A | FSD §2.2.3 |

Le **SS14 est donné pour 1,0 A** (`SS14.md`) : le total actuel passe tout juste, sans
marge, et le moindre usage de J9 le dépasse. Le SS34 porte la limite à 3 A **dans la même
empreinte SMA**, pour ~0,013 $. Aucune raison de s'en priver.

À notre courant réel (~0,83 A, bien en dessous des 3 A nominaux), la chute directe sera
sensiblement **inférieure** aux 550 mV spécifiés à 3 A — le rendement du boost ne se
dégrade pas par rapport au SS14.

## Notes spécifiques projet

- **D1** sur la feuille `power` : anode sur `BOOST_SW` (sortie SW du MT3608 + L1), cathode
  sur le rail `5V`. Remplacement effectué le 2026-09-27 (symbole `Diode:SS34` dérivé de
  `Diode:SS14`, mêmes broches et même empreinte).
- ⚠ **Symbole** : KiCad n'étant pas installé dans le container, la définition `Diode:SS34`
  a été dérivée de `Diode:SS14` et embarquée dans la feuille. Si la bibliothèque système
  ne contient pas de symbole `SS34`, KiCad le signalera lors d'un « Update Symbols from
  Library » — sans effet sur la netlist ni sur le PCB.
- **L'objectif de 1,9 A sur J9 reste à revoir** indépendamment de la diode : sur batterie,
  1,9 A de LEDs externes représenteraient à eux seuls ~3,1 A côté cellule, au-delà du seuil
  de coupure du DW01A (1,6-3,2 A, `DW01A.md`).
- **BOM** : remplacer `Diode Schottky SS14 / SMA` par `Diode Schottky SS34 / SMA`,
  LCSC **C8678**.

## Sources

- PDF local : Vishay SS32 thru SS36 — https://www.vishay.com/docs/88751/ss32.pdf
- Composant approvisionné : https://www.lcsc.com/product-detail/C8678.html (MDD SS34)
- JLCPCB (Basic part) : https://jlcpcb.com/partdetail/C8678
