GillesClerc/blackbox/docs/datasheets/ICS-43434.md

# ICS-43434

> _Synthèse de la datasheet TDK InvenSense DS-000069 v1.2 (fichier local [./ICS-43434.pdf](./ICS-43434.pdf), copie Farnell)._

**Fabricant** : TDK InvenSense
**Catégorie** : Microphone MEMS numérique, sortie I2S 24 bits
**Référence officielle** : ICS-43434 (LGA-6, port par le dessous)
**Datasheet source** : https://invensense.tdk.com/wp-content/uploads/2016/02/DS-000069-ICS-43434-v1.2.pdf

## Vue d'ensemble

Micro omnidirectionnel avec ADC sigma-delta, filtres de décimation et interface I2S
esclave (24 bits, complément à deux). Deux modes (haute performance / basse consommation)
selon la fréquence d'échantillonnage ; veille automatique si SCK < ~200 kHz.

## Package & Footprint

- **Package** : LGA-6 3,5 × 2,65 mm, port acoustique par le dessous (trou dans le PCB)
- **Empreinte KiCad** : `Sensor_Audio:InvenSense_ICS-43434-6_3.5x2.65mm` ; LCSC C5656610 (BOM projet)

## Pinout

| Pin | Nom | Direction | Fonction |
|---|---|---|---|
| 1 | WS | IN | Word select I2S (pull-down interne) |
| 2 | LR | IN | Canal : bas = gauche, haut = droite |
| 3 | GND | PWR | Masse |
| 4 | SCK | IN | Horloge bit I2S |
| 5 | VDD | PWR | 1,65–3,63 V — **découpler par 0,1 µF vers GND** |
| 6 | SD | OUT | Données I2S, trois états hors de son slot — **pull-down 100 kΩ recommandée** |

## Paramètres électriques

| Param | Min | Typ | Max | Unité | Note |
|---|---|---|---|---|---|
| VDD | 1,65 | — | 3,63 | V | abs max −0,3 à 3,63 V |
| Sensibilité (1 kHz, 94 dB SPL) | −27 | −26 | −25 | dB FS | haute performance |
| SNR (20 kHz, pondéré A) | — | 64 | — | dBA | |
| Point de surcharge acoustique | — | 120 | — | dB SPL | |
| Courant (haute performance, VDD 1,8 V) | — | 490 | 550 | µA | |
| Courant (basse conso, VDD 1,8 V) | — | 230 | 300 | µA | |
| Courant en veille | — | 12 | 20 | µA | f_S < 3,125 kHz |
| Échantillonnage haute performance | 23 | — | 51,6 | kHz | |
| Démarrage | — | — | 20 | ms | |
| Charge max sur SD | — | — | 85 | pF | |

## Interface

- I2S esclave, 24 bits, **64 cycles SCK par trame WS**.
- Canal gauche (LR bas) : données après le front descendant de WS.
- Ne pas envoyer d'horloges (WS/SCK) quand VDD est coupé (diodes ESD passantes, fiabilité).

## Notes spécifiques projet

- **U4** : VDD = 3V3_A ✓, LR = GND (gauche) ✓, SD avec R_SD_PD 100 kΩ ✓, I2S1 : SCK = GPIO16,
  WS = GPIO18, SD = GPIO7.
- ⚠ Pas de condensateur de 0,1 µF au pied de VDD (fortement recommandé par la datasheet,
  au plus près des pins 5/3, sans via) → à ajouter.

## Sources

- Datasheet officiel DS-000069 : https://invensense.tdk.com/wp-content/uploads/2016/02/DS-000069-ICS-43434-v1.2.pdf

## Note projet — découplage (vérifié 2026-09-27)

Le condensateur de découplage **existe déjà** : `C3`, 100 nF 0402, entre `3V3_A` et `GND`,
placé sur le schéma juste au-dessus de U4 (feuille `audio`). Le constat A4 de l'audit
2026-09-23 (« aucun condensateur de découplage ») était **infondé** — vérification faite
par netlist sur le fichier du 23/09, C3 y était déjà.

⚠ Ce qui reste vrai est une **contrainte de layout, pas de schéma** : la datasheet demande
le 0,1 µF X7R **au plus près des broches 5 et 3, sans via** entre le condensateur et le
composant. À vérifier au placement.
