GillesClerc/blackbox/docs/datasheets/AS04008PO.md

# PUI Audio AS04008PO-2-R (haut-parleur)

> _Synthèse de la datasheet PUI Audio « 40 x 28.3mm Speaker », dessin
> AS04008PO-2-R.idw révision C du 05/05/2015 (fichier local
> [./AS04008PO.pdf](./AS04008PO.pdf))._

**Fabricant** : PUI Audio (Dayton, Ohio)
**Catégorie** : haut-parleur ovale à aimant néodyme, cône papier
**Référence officielle** : AS04008PO-2-R
**Datasheet source** : https://puiaudio.com/file/specs-AS04008PO-2-R.pdf
**Fiche produit** : https://puiaudio.com/product/speakers-and-receivers/as04008po-2-r

## ⚠ Contradiction interne au PDF — lire le tableau, pas l'accroche

La **page 1** (« Product Overview », texte commercial) annonce « **2W continuous, 4W
maximum** power handling ». Le **tableau SPECIFICATIONS du dessin coté** du même document
dit « RATED INPUT POWER **1 W** / MAX INPUT POWER **2 W** ». La fiche produit en ligne
confirme 1 W / 2 W.

→ **Retenir 1 W nominal / 2 W maximum.** L'accroche de la page 1 semble reprise d'un
modèle voisin (l'AS04008PR-6 fait bien 3 W / 4 W). Dimensionner sur 2 W max.

## Spécifications (tableau du dessin coté)

| Param | Valeur | Unité |
|---|---|---|
| Puissance nominale | **1** | W |
| Puissance maximale | **2** | W |
| Impédance | **8 ±15 %** | Ω |
| SPL @ 1 W / 0,5 m (moy. 1,0 / 1,2 / 1,5 / 2,0 kHz) | 84 ±3 | dBA |
| Distorsion (max.) | 5 | % |
| Fréquence de résonance | **450 ±20 %** | Hz |
| Plage de fréquences | 450 à 20 000 | Hz |
| Masse | 13 | g |

- **Dimensions** : 40 × 28,3 mm (ovale). Hauteur **12 mm** d'après la fiche produit en
  ligne — le PDF porte une révision « REVISED SPEAKER HEIGHT » (05/05/2015) mais la cote
  n'est que dans le dessin graphique, non extractible en texte : à confirmer sur le dessin.
- **Terminaison** : fils (« wire leads ») d'après la fiche produit. Longueur, section et
  couleurs ne sont pas dans le texte du PDF (dessin seul) → à relever à la réception.
- **Température d'utilisation** : −20 °C à +60 °C (fiche produit ; cohérent avec les
  essais ci-dessous).

## Matériaux (§ Material Listing, « all materials meet GU-001 »)

Châssis SPCC (acier), cône tissu, saladier (yoke) acier 1,5 T, cache-poussière papier,
bobine mobile papier, aimant **NdFeB**, plaque acier 2,0 t, PCB époxy.

## Essais mécaniques et d'environnement (datasheet, page 2)

| Essai | Condition |
|---|---|
| Température haute | 60 °C ±2 °C, humidité aléatoire, 96 h |
| Température basse | −20 °C ±2 °C, humidité aléatoire, 96 h |
| Humidité | 40 °C, 90 à 95 % HR, 96 h |
| Vibration | 1,5 mm modulé de 10 à 55 Hz, 2 h |
| Chute | 100 cm en chute libre sur planche de 20 mm, 1 cycle par direction sur X, Y, Z (6 au total) |
| Cycles thermiques | −20 °C à 60 °C, 4 cycles |

Critère : après repos d'une heure, le SPL ne doit pas dévier de plus de ±4 dB de la mesure
initiale.

## Notes spécifiques projet

- **Face Dessus** du cube (FSD §2.2.2c) : voix du personnage. Relié à **J10** (JST PH
  4 broches, feuille `audio`) sur le canal **L** (broches 1 et 2), à travers les ferrites
  **FB3/FB4** (`BLM21PG.md`). Le canal R reste disponible sur les broches 3 et 4 pour un
  éventuel second haut-parleur (par exemple derrière la bouche).
- ⚠ **Sorties en pont** : les fils du haut-parleur ne doivent jamais être mis en commun ni
  reliés à GND (cf. `PAM8406.md`).
- **Adaptation à l'ampli** : le PAM8406 sous 5 V délivre au maximum **1,8 W sur 8 Ω**
  (THD 10 %) et 1,45 W à THD 1 % (`PAM8406.md`). C'est **sous les 2 W max** du
  haut-parleur — la butée physique de l'ampli le protège — mais **au-dessus de son 1 W
  nominal**, d'où le plafond de volume numérique à **−22 dB** côté firmware (calcul dans
  `PAM8406.md`).
- **Conséquence sur le rail 5 V** : ≈ 0,4 A par canal, contre 1,15-1,44 A qu'aurait
  demandés un 4 Ω. C'est ce qui détend le budget du boost MT3608 et de la diode D1
  (audit `docs/audits/2026-09-23-hardware-db.md`, A5).
- **Résonance à 450 Hz** : pas de grave sous 450 Hz. Acceptable pour de la voix, à garder
  en tête pour le design sonore (les effets très graves ne passeront pas). Le PUI
  AS04008PR-6 (rond 40 mm, f0 170 Hz, 3 W) était l'alternative, écartée pour ses 19 mm de
  profondeur.
- Montage : prévoir un joint/mousse entre le haut-parleur et la face pour éviter les
  fuites d'air et les vibrations parasites du cube (pas de spécification fabricant).

## Sources

- Datasheet PUI Audio AS04008PO-2-R : https://puiaudio.com/file/specs-AS04008PO-2-R.pdf
- Fiche produit : https://puiaudio.com/product/speakers-and-receivers/as04008po-2-r
