GillesClerc/blackbox/docs/datasheets/PAM8406.md

# PAM8406 (PAM8406DR)

> _Synthèse de la datasheet Diodes Inc. DS43342 rév. 2-2 (fichier local [./PAM8406.pdf](./PAM8406.pdf))._

**Fabricant** : Diodes Incorporated
**Catégorie** : Ampli audio stéréo 5 W, classe D (sans filtre) ou classe AB, sortie pont (BTL)
**Référence officielle** : PAM8406DR (SOP-16)
**Datasheet source** : https://www.diodes.com/assets/Datasheets/PAM8406.pdf

## Vue d'ensemble

Ampli stéréo sélectionnable classe D / AB, gain fixe 24 dB, sorties différentielles
attaquant le haut-parleur directement (pas de filtre LC ni de condensateur de liaison en
classe D), rendement jusqu'à 90 %, protections court-circuit et thermique.

## Package & Footprint

- **Package** : SOP-16 (existe en SOP-16 EP)
- **Empreinte LCSC** : C86270 ; θJA SOP-16 = 110 °C/W, θJC = 23 °C/W

## Pinout

| Pin | Nom | Fonction |
|---|---|---|
| 1 / 3 | +OUT_L / −OUT_L | Sortie gauche (pont) |
| 2 / 15 | PGNDL / PGNDR | Masses de puissance |
| 4 / 13 | PVDDL / PVDDR | Alimentations de puissance |
| 5 | MUTE | Mute, actif bas (pull-up interne, peut rester flottante) |
| 6 | VDD | Alimentation analogique |
| 7 / 10 | INL / INR | Entrées (via condensateur de liaison) |
| 8 | VREF | Référence interne : condensateur vers GND |
| 9 | MODE | Haut = classe D, bas = classe AB — **ne jamais laisser flottante** |
| 11 | GND | Masse analogique |
| 12 | SHDN | Shutdown, actif bas (pull-up interne) |
| 14 / 16 | −OUT_R / +OUT_R | Sortie droite (pont) |

## Paramètres électriques (TA 25 °C, VDD 5 V, gain 24 dB)

| Param | Min | Typ | Max | Unité | Note |
|---|---|---|---|---|---|
| VDD recommandé | 2,5 | — | 5,5 | V | abs max 6,0 V |
| P_O 4 Ω, THD 10 % | — | 3,14 (5 V) / 1,5 (3,6 V) | — | W/canal | |
| P_O 4 Ω, THD 1 % | — | 2,55 (5 V) / 1,45 (3,6 V) | — | W/canal | |
| P_O 2 Ω, THD 10 %, classe D | — | 5,0 (5 V) / 2,6 (3,6 V) | — | W/canal | |
| P_O 8 Ω, THD 10 % | — | 1,8 (5 V) / 0,92 (3,6 V) | — | W/canal | |
| Gain (fixe) | — | 24 | — | dB | R_F max 142 kΩ, R_I min 18 kΩ |
| Rendement classe D (THD 10 %) | — | 90 / 87 / 80 | — | % | 8 / 4 / 2 Ω |
| Iq classe D (sans charge) | — | 10 (5 V) / 8 (3,6 V) | — | mA | |
| Iq classe AB (sans charge) | — | 25 (5 V) / 15 (3,6 V) | — | mA | |
| Courant en mute | — | 2,4 | — | mA | |
| Courant en shutdown | — | < 1 | — | µA | |
| V_IH / V_IL SHDN, MUTE, MODE | 1,4 / — | — | — / 0,4 | V | VDD 5 V |
| f_SW classe D | — | 250 | — | kHz | |
| UVLO | — | off ≤ 2,0 / on ≥ 2,2 | — | V | |
| Protection thermique | — | 150 (±15), hystérésis 30 | — | °C | |

## Application (datasheet §Application Information)

- **Découplage** : 1 µF céramique faible ESR au plus près de VDD + ≥ 20 µF céramique près de l'ampli.
- **VREF (C_BYP)** : 0,47–1 µF céramique.
- **Entrée** : `f_c = 1 / (2π R_I C_I)`, R_I min 18 kΩ.
- **Classe D sans filtre** : ajouter une **ferrite sur les fils du haut-parleur** (note 2, EMI).
- **Classe D avec filtre LC** : brancher le haut-parleur avant la mise sous tension (note 1).
- **Note 4** : un signal d'entrée trop fort provoque un écrêtage qui peut **endommager** le
  composant, vu le gain élevé.

## Notes spécifiques projet

- **U3** : alimenté par le rail `5V` (MT3608), partagé avec les 12 WS2812B.
- MODE via 10 kΩ vers 3V3_A (classe D) ✓, MUTE et SHDN via 10 kΩ vers 3V3_A ✓, VREF 1 µF ✓,
  entrées 1 µF (f_c ≈ 8,8 Hz), découplage 3 × 1 µF + 22 µF ✓.
- ✅ Sorties HP : **J10** (JST PH 4 broches, 1 = L+, 2 = L−, 3 = R+, 4 = R−) via les
  ferrites **FB3-FB6** (BLM21PG221SN1D, une par fil — voir `BLM21PG.md`), feuille `audio`,
  2026-09-27. Sorties en pont : **aucune masse commune sur J10**, ne jamais relier les `−`
  entre elles ni à GND.
- **Haut-parleur retenu** : PUI Audio AS04008PO-2-R, **8 Ω**, 1 W nominal / 2 W max
  (`AS04008PO.md`). Conséquence : le maximum de l'ampli sur 8 Ω est **1,8 W** (THD 10 %),
  donc **sous le max du haut-parleur** — la butée physique de l'ampli protège le HP.
  Courant du rail 5 V pour l'audio : ≈ **0,4 A par canal** (1,8 W / rendement 90 %).
- ⚠ Niveau d'entrée : PCM5122 2,1 Vrms à 0 dB × 24 dB ≫ excursion possible sous 5 V
  (≈ 3,5 Vrms en pont) → entrée utile ≈ 0,22 Vrms. Plafond de volume numérique à viser :
  **−22 dB** avec ce haut-parleur (1 W sur 8 Ω = 2,83 Vrms en sortie ÷ 15,85 = 0,179 Vrms
  en entrée, soit −21,4 dB sous la pleine échelle du DAC) — protège à la fois l'ampli de
  l'écrêtage (note 4) et le HP de son nominal. Alternative : atténuateur résistif avant
  INL/INR.
- Si 3V3_A est coupé mais pas le 5 V (ou inversement), les pull-ups 10 kΩ de MUTE/SHDN/MODE
  vers 3V3_A mettent ces entrées hors plage (−0,3 V à VDD + 0,3 V) : à garder en tête
  pour le bouton marche/arrêt.

## Sources

- Datasheet officiel DS43342 : https://www.diodes.com/assets/Datasheets/PAM8406.pdf
