GillesClerc/blackbox/docs/datasheets/BMP280.md

# BMP280

> _Synthèse de la datasheet Bosch Sensortec BST-BMP280-DS001 rév. 1.26 (fichier local [./BMP280.pdf](./BMP280.pdf))._

**Fabricant** : Bosch Sensortec
**Catégorie** : Capteur de pression barométrique + température, I2C/SPI
**Référence officielle** : BMP280 (LGA 8 broches, 2,0 × 2,5 mm, avec trou d'évent)
**Datasheet source** : https://www.bosch-sensortec.com/media/boschsensortec/downloads/datasheets/bst-bmp280-ds001.pdf

## Vue d'ensemble

Pression 300–1100 hPa (résolution jusqu'à 0,16 Pa), température (0,01 °C), filtre IIR
intégré, modes sleep / forced / normal, I2C jusqu'à 3,4 MHz ou SPI 3/4 fils.

## Package & Footprint

- **Package** : LGA-8 métal, 2,0 × 2,5 mm, **trou d'évent** (à orienter vers l'ouverture du boîtier)
- **Empreinte LCSC** : C83291 (FSD §10.1)

## Pinout (tableau 29)

| Pin | Nom | Fonction | Connexion en I2C |
|---|---|---|---|
| 1 | GND | Masse | GND |
| 2 | CSB | Chip select | **VDDIO (liaison directe)** |
| 3 | SDI | Données | SDA |
| 4 | SCK | Horloge | SCL |
| 5 | SDO | LSB d'adresse | GND → 0x76 / VDDIO → 0x77 |
| 6 | VDDIO | Alimentation interface | 3V3 |
| 7 | GND | Masse | GND |
| 8 | VDD | Alimentation analogique | 3V3 |

## Paramètres électriques

| Param | Min | Typ | Max | Unité | Note |
|---|---|---|---|---|---|
| VDD | 1,71 | 1,8 | 3,6 | V | ripple ≤ 50 mVpp |
| VDDIO | 1,2 | 1,8 | 3,6 | V | |
| Abs max VDD/VDDIO | −0,3 | — | 4,25 | V | |
| Courant 1 Hz forced, conso min | — | 2,8 | 4,2 | µA | |
| Courant crête (mesure de pression) | — | 720 | 1120 | µA | |
| Sleep / standby | — | 0,1 / 0,2 | 0,3 / 0,5 | µA | 25 °C |
| Précision relative pression | — | ±0,12 | — | hPa | 700–900 hPa, 25–40 °C |
| Charge du bus I2C (Cb) | — | — | 400 | pF | SDI et SCK |

## Interface

- **Sélection automatique** : CSB relié à VDDIO → I2C ; CSB tiré bas → SPI. **Si CSB est vu
  bas au démarrage, l'interface reste verrouillée en SPI** (§5.1) → liaison directe à VDDIO recommandée.
- **Adresse I2C** : `111011x` → **0x76** (SDO = GND) ou **0x77** (SDO = VDDIO).
- **Chip ID** : registre 0xD0 = **0x58**.
- Ne pas maintenir une broche d'interface à l'état haut quand VDDIO est coupé.
- VDD et VDDIO sans contrainte d'ordre de montée ; POR interne.

## Connexion recommandée (§6.3)

C1 (VDD) et C2 (VDDIO) : **100 nF** chacun ; CSB directement sur VDDIO.

## Notes spécifiques projet

- Satellite face Devant, près de la bouche (souffle). Netlist documentée : VDD et VDDIO sur
  SAT_3V3 ✓, mais **CSB → VDDIO et SDO → GND ne sont pas spécifiés** → à ajouter (adresse
  0x76 conforme au FSD).
- Le souffle se traduit par une variation rapide de pression : réduire le filtre IIR et
  utiliser le mode normal à ODR élevé (à tester au proto).

## Sources

- Datasheet BST-BMP280-DS001-26 (PDF local)
