GillesClerc/blackbox/docs/datasheets/WS2812B-B.md

# WS2812B-B (WS2812B V5)

> _Synthèse de la datasheet Worldsemi WS2812B Ver. V5 (fichier local [./WS2812B-B.pdf](./WS2812B-B.pdf), PDF LCSC C2761795)._

**Fabricant** : Worldsemi
**Catégorie** : LED RGB adressable 5050 avec contrôleur intégré (protocole NZR une ligne)
**Référence officielle** : WS2812B-B/T (LCSC C2761795) — datasheet « WS2812B V5 »
**Datasheet source** : https://www.lcsc.com/datasheet/lcsc_datasheet_2412041609_Worldsemi-WS2812B-B-T_C2761795.pdf

> ⚠ Ne pas utiliser les timings et seuils de l'ancienne datasheet WS2812B (C114586, citée
> dans le FSD §10.1) : la V5 a un V_IH et des timings différents.

## Vue d'ensemble

Pixel RGB 24 bits (GRB, MSB en premier), 800 kbps, remise en forme du signal à chaque
pixel, reset > 280 µs. La datasheet indique **« pas besoin de composants externes, pas
même de condensateur »**.

## Package & Footprint

- **Package** : 5050, 5,0 × 5,4 × 1,57 mm
- **Empreinte** : `lcsc_footprints:C2761795_LED-SMD_4P-L5_0-W5_0-TL_WS2812B-B`
- **MSL 5a** : 24 h hors emballage avant refusion (sinon étuvage à 70–75 °C ≥ 12 h)

## Pinout

| Pin | Nom | Fonction |
|---|---|---|
| 1 | VDD | Alimentation |
| 2 | DOUT | Sortie données (vers le DIN suivant) |
| 3 | VSS | Masse |
| 4 | DIN | Entrée données |

## Paramètres électriques (TA 25 °C, VDD 5 V)

| Param | Min | Typ | Max | Unité |
|---|---|---|---|---|
| VDD (abs max) | 3,7 | — | 5,3 | V |
| Entrée logique (abs max) | VDD − 0,3 (sic) | — | VDD + 0,7 | V |
| **V_IH (DIN)** | **2,7** | — | VDD + 0,7 | V |
| V_IL (DIN) | −0,3 | — | 0,7 | V |
| Courant d'entrée | — | — | ±1 | µA |
| Courant de repos | — | 0,6 | — | mA (par LED) |
| Courant par couleur (condition de mesure) | — | 12 | — | mA |
| Délai DIN → DOUT | — | — | 300 | ns |

## Timings (V5)

| Symbole | Valeur |
|---|---|
| T0H (bit 0, haut) | 220–380 ns |
| T0L (bit 0, bas) | 580 ns – 1 µs |
| T1H (bit 1, haut) | 580 ns – 1 µs |
| T1L (bit 1, bas) | 580 ns – 1 µs |
| RES (reset) | > 280 µs |

## Exemple ESP-IDF (RMT, horloge 10 MHz → 0,1 µs/tick)

```c
rmt_bytes_encoder_config_t enc_cfg = {
    .bit0 = { .duration0 = 3, .level0 = 1, .duration1 = 9, .level1 = 0 }, // 0,3 / 0,9 µs
    .bit1 = { .duration0 = 8, .level0 = 1, .duration1 = 6, .level1 = 0 }, // 0,8 / 0,6 µs
    .flags.msb_first = 1,
};
```

## Notes spécifiques projet

- **LED2–LED13** (halo, Main) : chaîne R8 (330 Ω) → LED2 → … → LED13 → J9, sur le rail `5V`.
- Pilotage 3,3 V depuis GPIO48 : **conforme** (V_IH min 2,7 V).
- Pas de condensateur par LED : **conforme** à la datasheet.
- 12 LEDs au repos = 7,2 mA même éteintes → à couper physiquement pour la veille ou l'arrêt.
- ⚠ Firmware `hal_leds.c` : T0H = 0,4 µs (> 380 ns max) et T1L = 0,45 µs (< 580 ns min)
  → hors spec V5, à corriger (valeurs ci-dessus).
- `hal_leds_init(48, 1)` → passer à 12 LEDs (+ chaîne externe J9) au bring-up.

## Sources

- Datasheet V5 (LCSC) : https://www.lcsc.com/datasheet/lcsc_datasheet_2412041609_Worldsemi-WS2812B-B-T_C2761795.pdf
