GillesClerc/blackbox/docs/audits/2026-09-23-audit.md

# Audit complet — 2026-09-23

Périmètre : firmware (main + 17 composants), web (`/api/box/*`, server actions,
`proxy.ts`), outils Python, configuration de build, dépendances.
Base : commit `7fd5682`. Corrections des points critiques : commits `a3a8204`
→ `f5bf780`.

Verdict global : code de bonne facture (downloads sha256 + tmp/rename +
reprise, sanitisation des chemins des deux côtés, nonces à usage unique,
conventions CLAUDE.md respectées). Les problèmes étaient surtout
architecturaux et de robustesse aux cas limites.

---

## Plan de correction — points critiques (FAIT)

### Étape 1 — Séparation de domaine des signatures (#1) · `a3a8204`
- [x] 1.1 `hal_box_auth_sign(purpose, …)` signe `"<purpose>:<uid>:<challenge>"`
- [x] 1.2 `cloud_client` → `auth` ; `ble_prov` ne signe que `register`
- [x] 1.3 Serveur : `verifyBoxHmac(purpose, …)` — `/auth` exige `auth`, `/register` exige `register`
- [x] 1.4 `tools/box_crypto.py` + `test_box_api.py` alignés (le test vérifie qu'une preuve `register` est refusée par `/auth`)
- [x] 1.5 Vecteur de référence produit par le serveur Node → `tools/test_box_crypto.py`

### Étape 2 — Identité box dans une partition dédiée (#2) · `dec8024`
- [x] 2.1 `partitions.csv` : `box_nvs` (0x12000, 24 Ko), aucun offset existant déplacé
- [x] 2.2 `hal_box_auth` : lecture `box_nvs`, migration auto depuis l'ancien namespace, fallback legacy si ancienne table
- [x] 2.3 `provision_box.py` : n'écrit plus que `box_nvs` (la NVS applicative est préservée)

### Étape 3 — Boot robuste sans DAC ni écran (#3) · `5054ac1`
- [x] 3.1 `hal_audio_init` : DAC absent → libère I2C/I2S, API sans effet
- [x] 3.2 `main.c` : écran et audio optionnels ; `ui_face_*` sans effet si non initialisé

### Étape 4 — Moteur de scénario robuste (#4) · `85c341e`
- [x] 4.1 `scenario_validate.c` (cJSON seul, testable host) appelé au chargement → scénario refusé = fallback embarqué
- [x] 4.2 Gardes NULL au runtime ; step introuvable = arrêt du scénario (plus de boucle)
- [x] 4.3 `yaml2json.py` refuse `expect.code`/`expect.uid` non chaînes
- [x] 4.4 `firmware/test_host/run.sh` : 26 cas sous ASan/UBSan

### Étape 5 — Flux d'ajout de box (#5) · `f5bf780`
- [x] 5.1 `/devices/add` : preuve de possession demandée juste avant `/register`

### Vérifications effectuées
- [x] `idf.py fullclean build` : 0 warning dans le code projet, binaire 2,5 Mo (16 % libre)
- [x] Table de partitions générée décodée : `box_nvs` présente à 0x12000
- [x] Image `box_nvs` générée par `provision_box.py` décodée (`nvs_tool.py`) : `box_uid` + `box_secret` corrects
- [x] Tests host : crypto (Python ↔ Node), validateur (26/26), `yaml2json` (JSON identique au commité ; `code: 7394` non quoté refusé)
- [x] Web : `tsc --noEmit`, `eslint`, `next build` OK
- [x] E2E API (serveur de dev local + Supabase prod, box `ESP32S3-8FF7-D684`) : challenge 200 → auth 200 → preuve `register` sur `/auth` **401** → sync 200
- [x] **Sur cible (2026-09-23, box ESP32S3-8FF7-D684)** : flash complet OK (hashes vérifiés), table avec `box_nvs` @ 0x12000, identité migrée (relecture de `box_nvs` en flash : `box_creds` = `box_uid` + `box_secret` 32 octets), boot complet sans warning ni erreur (yeux, PCM5122 PLL locked, SD, scénario, bg MP3), WiFi OK, **auth cloud OK avec le nouveau format de signature** (`authentifiée auprès de https://box.agill.es`), sync OK (capitaine_verdier v4)

---

## ⚠ Déploiement — rupture de protocole

Le format signé change : **serveur et firmware doivent être mis à jour
ensemble**. Une box en ancien firmware reçoit 401 sur `/api/box/auth` dès que
le serveur est déployé (et inversement).

Procédure pour la box de test `ESP32S3-8FF7-D684` :

1. Déployer le web (Coolify, push sur `master`).
2. Brancher la box, **flash complet** (la table de partitions change) — la
   commande du CLAUDE.md écrit bootloader + table + otadata + app, sans toucher
   la NVS applicative (0x9000) :
   ```
   cd firmware && python -m esptool --chip esp32s3 -p /dev/ttyACM0 -b 460800 \
     --before default-reset --after hard-reset write_flash --flash_mode dio \
     --flash_size 16MB --flash_freq 80m 0x0 build/bootloader/bootloader.bin \
     0x8000 build/partition_table/partition-table.bin \
     0xf000 build/ota_data_initial.bin 0x20000 build/blackbox.bin
   ```
3. Logs attendus au premier boot :
   `box_auth: box provisionnée: ESP32S3-8FF7-D684 (identité migrée vers box_nvs)`,
   puis `cloud_client: authentifiée auprès de https://box.agill.es`.
   Au boot suivant : `box provisionnée: ESP32S3-8FF7-D684` (lu depuis box_nvs).
4. Si la migration échoue : `BOX_MASTER_SECRET=<hex> python3 tools/provision_box.py --flash`
   (n'écrit que `box_nvs`).

---

## Points restants (non traités)

### 🟠 Moyen
6. **Schéma DB absent du dépôt** — pas de migrations ni de policies RLS
   versionnées ; non vérifiable : `UNIQUE(devices.box_uid)` (race sur
   `/register` concurrent), policy insert `waitlist`, index `box_challenges`.
   → `supabase/migrations/` (DDL à passer par Gilles dans Studio).
7. **Version de scénario en double** — `scenarios.version` (DB) et
   `manifest.json` doivent coïncider à la main ; si divergence,
   `cloud_client.c` re-télécharge le manifest et re-hashe tous les fichiers à
   chaque sync. → le serveur lit la version dans le manifest.
8. **Clé JWT = master brut** (`box-auth.ts`, commentaire « dérivée » faux) —
   réutilisation de clé HKDF/HMAC. → `HKDF(master, "escapebox:jwt")` + `iss`/`aud`.
9. **Pas de rate limiting** sur `/api/box/*` — `/challenge` non authentifié
   insère une ligne par appel.
10. **WiFi sans reconnexion** après 5 échecs (`hal_wifi.c`) et **pas de sync
    périodique** (boot / appairage uniquement).
11. **BLE sans LE Secure Connections** (`sm_sc = 0`) — mot de passe WiFi en
    clair dans les airs ; fenêtre BLE non fermée après `wifi_ok`.
12. **Secure Boot / flash encryption désactivés**, secret en clair en NVS —
    acceptable en proto, pas en production. Packages en clair sur la SD
    (copie triviale) : choix business.
13. **`shadcn` en `dependencies`** → tire `@modelcontextprotocol/sdk`, express,
    hono, body-parser : vulnérabilités `high` à `npm audit`. → devDependencies
    + `npm audit fix`.

### 🟡 Faible / hygiène
- **cJSON (MIT) absent de `THIRD_PARTY_LICENSES`** (vendoré dans
  `components/scenario/`), NimBLE (Apache-2.0) aussi.
- `dependencies.lock` gitignoré (`firmware/.gitignore`) → le commiter.
- Code mort : LVGL déclaré non utilisé, `hal_imu`/`hal_nfc`/`hal_light` non
  référencés, dossier `/components` racine vide, `stripe` non importé.
- Raccourcis debug actifs (`main.c` touch_task : maintien 9/10/11 simule
  RFID/rotary/tilt) → derrière `config_get_dev_mode()`.
- `main.c` action_flash : `count` casté `uint8_t` sans borne.
- `register/route.ts` : `name` non-chaîne ou body `null` → 500.
- `hal_audio.c` : si `voice_stop_wait` expire, buffer réalloué pendant la
  lecture du mixer (use-after-free improbable).
- OTA (F6) : pas de `esp_ota_mark_app_valid_cancel_rollback()` ; 16 % libres
  dans la partition app (retirer le MP3 embarqué de 1 Mo, déjà sur SD) ;
  l'`url` OTA devra être vérifiée (signature ou sha256).
- `next.config.ts` : aucun header de sécurité (CSP, HSTS, frame-ancestors).
- Pas de captcha/rate limit sur inscription et waitlist.
- Pas de CI : brancher `tools/test_box_crypto.py`, `firmware/test_host/run.sh`,
  `tsc`/`lint` et la validation des scénarios.
