GillesClerc/blackbox/docs/plans/web-implementation.md

# Web Platform — Guide d'implémentation

*Guide opérationnel uniquement. Spec fonctionnelle dans `docs/escapebox-fsd.md`.*

---

## Découpage en phases (sprint ~4 semaines)

| Phase | Contenu | Livrable vérifiable |
|---|---|---|
| **0** | Infra Coolify : Supabase self-hosted + service Next.js | `curl` → 200 sur les deux domaines |
| **1** | Init projet + landing + formulaire waitlist | Landing en ligne, emails dans `waitlist` |
| **2** | Auth (email + Google) + schéma SQL + catalogue + bibliothèque | Register/login OK, `/shop` liste le seed |
| **3** | API box : challenge/auth (HMAC→JWT), register, sync, session + page publique `/v/` | `curl` du flux d'auth box complet |
| **4** | Stripe : checkout + webhook → licence | Achat test 4242… → licence en DB |
| **5** | Studio + simulateur (Phase 2 produit) | Player JSON dans le navigateur |

> Ordre choisi pour livrer de la valeur visible tôt (landing/waitlist pour le FFF) et débloquer le firmware ensuite (API box avant Stripe — la box peut synchroniser des scénarios gratuits sans paiement).

> ⚠ **Mise à jour 2026-07 (F3 firmware)** : la livraison des scénarios décrite plus bas a évolué — voir `docs/plans/firmware-cloud-client.md`. En résumé : `scenarios.scenario_path` est devenu `package_path` (+ colonne `version`), les artefacts ne sont plus dans `web/public/scenarios/` mais dans `web/scenario-packages/` (privé), servis par `GET /api/box/pkg/[slug]/[...path]` (JWT box + droit `device_scenarios`). Le schéma SQL et l'arborescence ci-dessous n'ont pas été réécrits.

---

## Phase 0 — Infrastructure Coolify (manuel, ~1h)

### 0.1 Supabase self-hosted
1. Coolify → New Resource → Supabase (template one-click)
2. Sous-domaine : `https://supabase.agill.es/`
3. Récupérer : `SUPABASE_URL`, `ANON_KEY`, `SERVICE_ROLE_KEY`
4. Studio : `https://supabase.agill.es/dashboard`

### 0.2 Service Next.js
1. Coolify → New Resource → Application → GitHub
2. Repo `GillesClerc/blackbox`, branch `master`, **base directory `web/`**
3. Build pack : Nixpacks
4. Domaine `box.agill.es` (dev/FFF) — prod : `escapebox.ch` (à valider, Phase 3)
5. SSL auto

Variables d'env :
```env
NEXT_PUBLIC_SUPABASE_URL=https://supabase.agill.es/
NEXT_PUBLIC_SUPABASE_ANON_KEY=eyJ...
SUPABASE_SERVICE_ROLE_KEY=eyJ...
NEXT_PUBLIC_STRIPE_PUBLISHABLE_KEY=pk_test_...
STRIPE_SECRET_KEY=sk_test_...
STRIPE_WEBHOOK_SECRET=whsec_...
BOX_MASTER_SECRET=<openssl rand -hex 32>   # master de dérivation par-box (jamais embarqué)
NEXT_PUBLIC_APP_URL=https://box.agill.es
```

### 0.3 Stripe test mode (optionnel, sera fait en Phase 4)
1. stripe.com → Test mode → Créer produit "Capitaine Verdier" prix fixe CHF
2. Récupérer `pk_test_` / `sk_test_`
3. Webhook → `https://box.agill.es/api/webhooks/stripe`

---

## Phase 1 — Init projet

```bash
cd /workspaces/blackbox
npx create-next-app@16.2.6 web \
  --typescript --tailwind --eslint --app \
  --no-src-dir --import-alias "@/*" \
  --no-git
cd web
npx shadcn@latest init   # style: default, dark, CSS variables: yes
```
> `--no-git` : monorepo avec `.git` à la racine — pas de repo imbriqué. `--eslint` doit être explicite sinon le prompt peut bloquer en CI.

```bash
npm install @supabase/supabase-js @supabase/ssr \
            stripe @stripe/stripe-js \
            jose zod lucide-react
```
> Le scénario est servi au format **JSON** (artefact généré par `tools/yaml2json.py`, déjà parsé par le firmware) — pas de parseur YAML côté web.
> `jose` signe/vérifie les JWT box. En Next.js 16, le `proxy` (ex-`middleware`) tourne en runtime **nodejs** (l'edge n'y est plus supporté) — `jose` comme le module natif `crypto` y fonctionnent sans souci.

---

## Arborescence

```
web/
  app/
    layout.tsx
    page.tsx                                    # Landing (/)
    (marketing)/
      activate/[token]/page.tsx                 # Activation QR code physique
      v/[scenario]/[session]/page.tsx           # Résultat / leaderboard (public, sans auth)
    (auth)/
      login/page.tsx
      register/page.tsx
    (app)/                                      # route group : N'AJOUTE PAS de segment URL
      layout.tsx                                # Shell authentifié — pages servies à la racine :
      shop/page.tsx                             #   → /shop  (PAS /app/shop)
      shop/[slug]/page.tsx                      #   → /shop/[slug]
      checkout/success/page.tsx
      checkout/cancel/page.tsx
      library/page.tsx                          #   → /library
      devices/page.tsx                          #   → /devices
      devices/add/page.tsx
      scores/page.tsx                           #   → /scores
      account/page.tsx                          #   → /account
    api/
      box/                                      # WB-11 : rate limiting 10 req/min/box_uid (Phase 2 produit)
        challenge/route.ts                      # GET  — nonce HMAC (usage unique, TTL 60s)
        auth/route.ts                           # POST — HMAC response → JWT 2h
        register/route.ts                       # POST — enregistrement box (max 3 box/compte, WB-04)
        sync/route.ts                           # GET  — scénarios + firmware
        session/route.ts                        # POST — upload score
      waitlist/route.ts                         # POST — formulaire landing (ou server action)
      checkout/route.ts
      webhooks/
        stripe/route.ts
    studio/                                     # vrai segment /studio/* (PAS un route group)
      page.tsx
      new/page.tsx
      [id]/edit/page.tsx
      [id]/simulate/page.tsx
  components/
    ui/                                         # shadcn/ui (auto-généré)
    ScenarioCard.tsx
    ScenarioPlayer.tsx
    DeviceCard.tsx
  lib/
    supabase/
      client.ts
      server.ts
    stripe.ts
    scenario-engine.ts                          # Port JS du moteur firmware
    box-auth.ts
  proxy.ts                                      # Next 16 : ex-middleware.ts (runtime nodejs)
  public/
    scenarios/
      capitaine_verdier.json                    # Copié depuis firmware/scenarios/ (artefact généré)
  .env.local
  next.config.ts
```

---

## Snippets clés

**`lib/supabase/server.ts`**
```typescript
import { createServerClient } from '@supabase/ssr'
import { cookies } from 'next/headers'

export async function createClient() {
  const cookieStore = await cookies()
  return createServerClient(
    process.env.NEXT_PUBLIC_SUPABASE_URL!,
    process.env.NEXT_PUBLIC_SUPABASE_ANON_KEY!,
    {
      cookies: {
        getAll: () => cookieStore.getAll(),
        setAll: (cookiesToSet) => {
          try {
            cookiesToSet.forEach(({ name, value, options }) =>
              cookieStore.set(name, value, options)
            )
          } catch {
            // Server Component read-only — ignoré, proxy.ts gère le refresh
          }
        },
      },
    }
  )
}
```

**`lib/supabase/client.ts`**
```typescript
import { createBrowserClient } from '@supabase/ssr'

export function createClient() {
  return createBrowserClient(
    process.env.NEXT_PUBLIC_SUPABASE_URL!,
    process.env.NEXT_PUBLIC_SUPABASE_ANON_KEY!
  )
}
```

**`proxy.ts`** *(Next.js 16 : `middleware.ts` est déprécié → renommé `proxy.ts`, fonction `proxy`, runtime nodejs)*
```typescript
import { createServerClient } from '@supabase/ssr'
import { NextResponse, type NextRequest } from 'next/server'

// Les pages protégées vivent dans le route group (app)/ → servies à la racine
// (/shop, /library, /devices, /scores, /account). Un route group NE crée PAS
// de segment d'URL : tester startsWith('/app') ne matcherait jamais. On liste
// donc les préfixes réels.
const PROTECTED = ['/shop', '/library', '/devices', '/scores', '/account', '/checkout', '/studio']

export async function proxy(request: NextRequest) {
  let supabaseResponse = NextResponse.next({ request })

  const supabase = createServerClient(
    process.env.NEXT_PUBLIC_SUPABASE_URL!,
    process.env.NEXT_PUBLIC_SUPABASE_ANON_KEY!,
    {
      cookies: {
        getAll: () => request.cookies.getAll(),
        setAll: (cookiesToSet) => {
          cookiesToSet.forEach(({ name, value }) => request.cookies.set(name, value))
          supabaseResponse = NextResponse.next({ request })
          cookiesToSet.forEach(({ name, value, options }) =>
            supabaseResponse.cookies.set(name, value, options)
          )
        },
      },
    }
  )

  const { data: { user } } = await supabase.auth.getUser()
  const { pathname } = request.nextUrl

  if (!user && PROTECTED.some((p) => pathname === p || pathname.startsWith(p + '/'))) {
    const url = request.nextUrl.clone()
    url.pathname = '/login'
    return NextResponse.redirect(url)
  }

  // TODO Phase 3 : vérifier plan Pro+ pour /studio/*

  return supabaseResponse
}

export const config = {
  matcher: ['/((?!_next/static|_next/image|favicon.ico|api/).*)'],
}
```
> ⚠️ Collision de route à éviter : `app/page.tsx` (landing, `/`) et un éventuel `(studio)/page.tsx` résolvent tous deux vers `/` → build en échec. D'où le **vrai dossier `studio/`** (segment `/studio`) plutôt qu'un route group.

**`lib/box-auth.ts`**

> 🔐 **Secret par box, pas de secret global.** Ne jamais utiliser un `BOX_SHARED_SECRET` unique compilé dans tous les firmwares : son extraction depuis une seule box (dump flash) compromettrait *toutes* les box (forge de JWT, faux scores). Chaque box a un secret **dérivé de son UID eFuse** via un master serveur jamais embarqué : `box_secret = HKDF(BOX_MASTER_SECRET, box_uid)`. Le firmware ne stocke que *son* secret dérivé (idéalement en eFuse/flash chiffrée) ; le serveur le recalcule à la volée.

```typescript
import { SignJWT, jwtVerify } from 'jose'
import { createHmac, hkdfSync, timingSafeEqual, randomUUID } from 'crypto'

const masterSecret = process.env.BOX_MASTER_SECRET! // 32+ octets, jamais embarqué

// Clé de signature des JWT : propre au serveur (le JWT est émis ET vérifié côté
// serveur), dérivée du master pour ne pas multiplier les secrets d'env.
const jwtSecret = new TextEncoder().encode(masterSecret)

// Secret propre à une box, dérivé de son UID (jamais stocké tel quel côté serveur)
function boxSecret(boxUid: string): Buffer {
  return Buffer.from(hkdfSync('sha256', masterSecret, '', `escapebox:${boxUid}`, 32))
}

export function verifyBoxHmac(boxUid: string, challenge: string, hmac: string): boolean {
  const expected = createHmac('sha256', boxSecret(boxUid))
    .update(`${boxUid}:${challenge}`)
    .digest('hex')
  const a = Buffer.from(expected)
  const b = Buffer.from(hmac)
  if (a.length !== b.length) return false
  return timingSafeEqual(a, b)
}

export async function signBoxJwt(payload: { boxUid: string; deviceId: string; ownerId: string }) {
  return new SignJWT({ device_id: payload.deviceId, owner_id: payload.ownerId })
    .setProtectedHeader({ alg: 'HS256' })
    .setSubject(payload.boxUid)
    .setJti(randomUUID())
    .setIssuedAt()
    .setExpirationTime('2h')
    .sign(jwtSecret)
}

export async function verifyBoxJwt(token: string) {
  const { payload } = await jwtVerify(token, jwtSecret)
  return payload as { sub: string; device_id: string; owner_id: string; jti: string }
}
```

**`lib/stripe.ts`**
```typescript
import Stripe from 'stripe'
// Pas d'apiVersion épinglée : le SDK utilise la version qu'il a été buildé contre,
// ce qui garantit la cohérence types ↔ API. Épingler une vieille date casse les types.
export const stripe = new Stripe(process.env.STRIPE_SECRET_KEY!)
```

---

## Schema SQL — Supabase Studio → SQL Editor

```sql
-- Waitlist
create table public.waitlist (
  id uuid primary key default gen_random_uuid(),
  email text unique not null,
  created_at timestamptz default now()
);

-- Profiles
create table public.profiles (
  id uuid references auth.users(id) on delete cascade primary key,
  email text,
  created_at timestamptz default now()
);
alter table public.profiles enable row level security;
create policy "own profile" on public.profiles for all using (auth.uid() = id);

create or replace function public.handle_new_user()
returns trigger language plpgsql security definer as $$
begin
  insert into public.profiles (id, email) values (new.id, new.email);
  return new;
end;
$$;
create trigger on_auth_user_created
  after insert on auth.users
  for each row execute function public.handle_new_user();

-- Devices
create table public.devices (
  id uuid primary key default gen_random_uuid(),
  owner_id uuid references public.profiles(id) on delete set null,
  box_uid text unique not null,       -- eFuse ESP32 (format ESP32S3-XXXX-XXXX)
  name text default 'EscapeBox',
  firmware_version text,
  last_sync_at timestamptz,
  created_at timestamptz default now()
);
alter table public.devices enable row level security;
create policy "own devices" on public.devices for all using (auth.uid() = owner_id);
-- WB-04 : max 3 box par compte — vérifié dans /api/box/register (count avant insert),
-- pas de contrainte SQL (le service_role doit pouvoir réassigner en SAV)

-- Scenarios
create table public.scenarios (
  id uuid primary key default gen_random_uuid(),
  slug text unique not null,
  title text not null,
  description text,
  difficulty int check (difficulty between 1 and 5),
  duration_min int,
  min_players int default 1,
  max_players int default 6,
  language text default 'fr',
  hardware_required text[],
  price_chf numeric(10,2) not null default 0,
  stripe_price_id text,
  cover_url text,
  scenario_path text,                           -- artefact JSON généré (yaml2json.py)
  active boolean default true,
  created_at timestamptz default now()
);
alter table public.scenarios enable row level security;
create policy "public read" on public.scenarios for select using (active = true);

-- Licenses
create table public.licenses (
  id uuid primary key default gen_random_uuid(),
  owner_id uuid references public.profiles(id) on delete cascade,
  scenario_id uuid references public.scenarios(id),
  stripe_payment_intent text,
  purchased_at timestamptz default now(),
  unique(owner_id, scenario_id)
);
alter table public.licenses enable row level security;
create policy "own licenses" on public.licenses for all using (auth.uid() = owner_id);

-- Device <-> Scenario installé
create table public.device_scenarios (
  device_id uuid references public.devices(id) on delete cascade,
  scenario_id uuid references public.scenarios(id),
  installed_at timestamptz default now(),
  primary key (device_id, scenario_id)
);
alter table public.device_scenarios enable row level security;
create policy "own device scenarios" on public.device_scenarios for all using (
  exists (select 1 from public.devices d where d.id = device_id and d.owner_id = auth.uid())
);
-- Modèle pull : le webhook Stripe insère ici le droit (device_id, scenario_id).
-- La box ne reçoit aucun push — elle le découvre au prochain GET /api/box/sync
-- (sync auto au boot si WiFi, ou manuelle depuis le menu). Voir FSD §6.4.4.

-- Game sessions
create table public.game_sessions (
  id uuid primary key default gen_random_uuid(),
  device_id uuid references public.devices(id),
  scenario_id uuid references public.scenarios(id),
  score integer,
  duration_seconds integer,
  hints_used integer default 0,
  completed boolean default false,
  session_token text unique default encode(gen_random_bytes(16), 'hex'),
  -- Micro-enquête post-partie (FSD §7.3.4), remplie depuis la page /v/ publique
  feedback_rating smallint check (feedback_rating between 1 and 3),       -- 😕/😊/🤩
  feedback_difficulty text check (feedback_difficulty in ('too_easy','balanced','too_hard')),
  feedback_recommend boolean,
  played_at timestamptz default now()
);
-- Insertion : route /api/box/session (service_role après vérif JWT box).
-- Lecture page /v/[scenario]/[session] et écriture feedback : route handler
-- server-side (service_role) qui matche le session_token — jamais d'accès
-- client direct, pas de policy RLS publique.

-- Challenges box (anti-replay du nonce d'auth)
-- Indispensable : une Map en mémoire ne survit ni aux restarts ni au multi-instance.
create table public.box_challenges (
  challenge text primary key,
  box_uid text not null,
  expires_at timestamptz not null,          -- now() + 60s
  used boolean default false
);
-- /api/box/challenge insère ; /api/box/auth vérifie (non used, non expiré) puis used=true.
-- Purge opportuniste (pas besoin de cron) : chaque GET /api/box/challenge commence par
-- delete from box_challenges where expires_at < now();

-- Seed
insert into public.scenarios (slug, title, description, price_chf, difficulty, duration_min, scenario_path)
values ('capitaine_verdier', 'Le Mystère du Capitaine Verdier',
        'Un mystère maritime en 3 énigmes.', 19.00, 3, 60,
        '/scenarios/capitaine_verdier.json');
```

---

## Vérification par phase

```bash
# Phase 0
curl https://supabase.agill.es/rest/v1/          # → 200
curl https://box.agill.es                       # → page Next.js

# Phase 1 : landing en ligne · POST waitlist → ligne dans la table · git push → Coolify build vert

# Phase 2 : register/login OK · tables dans Supabase Studio · /shop affiche le seed

# Phase 3 — Auth box
curl "https://box.agill.es/api/box/challenge?box_uid=ESP32S3-TEST-0001"
# → { "challenge": "abc123...", "expires_in": 60 }

curl -X POST https://box.agill.es/api/box/auth \
  -H 'Content-Type: application/json' \
  -d '{"box_uid":"ESP32S3-TEST-0001","challenge":"abc123...","challenge_response":"hmac..."}'
# → { "token": "eyJ...", "server_time": 1234567890 }

# Phase 4 — Stripe webhook local
stripe listen --forward-to localhost:3000/api/webhooks/stripe
# Achat test (card 4242 4242 4242 4242) → license créée dans Supabase
```

---

## Fichiers critiques

| Fichier | Rôle |
|---|---|
| `web/proxy.ts` | (Next 16, ex-middleware) Refresh session Supabase + protection des préfixes réels (`/shop`, `/library`, `/devices`, `/scores`, `/account`, `/checkout`, `/studio`) |
| `web/lib/supabase/server.ts` | Client SSR (async cookies) |
| `web/lib/box-auth.ts` | HMAC challenge + JWT 2h (jose) |
| `web/app/api/box/challenge/route.ts` | Nonce anti-replay (usage unique, TTL 60s) |
| `web/app/api/box/auth/route.ts` | Auth firmware → JWT |
| `web/app/api/box/register/route.ts` | Enregistrement box (BLE provisioning) |
| `web/app/api/webhooks/stripe/route.ts` | Création licence post-paiement |
| `web/app/(marketing)/v/[scenario]/[session]/page.tsx` | Page résultat QR (publique) |
| `web/lib/scenario-engine.ts` | Port JS du moteur C firmware |
