GillesClerc/blackbox/hardware/main/BOM/02-bom-lcsc.csv

Designator | MPN | Value | Footprint | LCSC Part # | Qty | Board | Notes
U1 | ESP32-S3-WROOM-1-N16R8 |  | ESP32-S3-WROOM-1 | C2913202 | 1 | Main | Module WiFi+BT 16MB flash 8MB PSRAM
U2 | PCM5122PW |  | TSSOP-28 | C1540085 | 1 | Main | DAC audio stereo I2S+I2C
U3 | PAM8406DR |  | SOP-16 | C86270 | 1 | Main | Ampli classe D stereo en pont ; 1,8 W/canal max sur le HP 8 ohms retenu (docs/datasheets/PAM8406.md)
U4 | ICS-43434 |  | BGA-6 bottom-port | C5656610 | 1 | Main | Micro MEMS I2S 24-bit
U5 | AP2112M-3.3TRG1 |  | SO-8 | C5290219 | 1 | Main | LDO 3.3V digital 600mA — SO-8 (114 °C/W au lieu de 184) pour la thermique sous USB
U6 | AP2112K-3.3TRG1 |  | SOT-23-5 | C51118 | 1 | Main | LDO 3.3V audio 600mA
U7 | MT3608 |  | SOT-23-6 | C84817 | 1 | Main | Boost 3.7V->5V 2A
U8 | bq24075RGTR |  | QFN-16 | C15464 | 1 | Main | Chargeur LiPo 1.5A + power path DPPM
U9 | DW01A |  | SOT-23-6 | C351410 | 1 | Main | Protection batterie
U10 | FS8205 |  | SOT-23-6 | C32254 | 1 | Main | Dual MOSFET protection
U11 | LSM6DSOXTR |  | LGA-14 | C481766 | 1 | Main | Accelerometre + gyro 6 axes + MLC, soude sur la Main (feuille imu) — docs/datasheets/LSM6DSOXTR.md
COTE2-U1 | USBLC6-2SC6 |  | SOT-23-6 | C7519 | 1 | Satellite Cote 2 | [Satellite Cote 2, projet hardware/cote2/ (ex-U12 de la Main, deplace le 2026-09-27).] Au plus pres de J1. Protection ESD USB D+/D-
COTE2-J1 | HOOYA USB-307HB-B-SU |  | USB-C-24P SMD vertical | C309361 | 1 | Satellite Cote 2 | [Satellite Cote 2, projet hardware/cote2/ (ex-J1 de la Main, deplace le 2026-09-27).] Connecteur USB-C femelle 24 pins (fab. Dongguang Haoyu Electronics) — sur LCSC/JLCPCB, importable via easyeda2kicad ou plugin kicad-lcsc-manager (LCSC ID C309361). Pinout standard verifie sur datasheet fabricant 2026-09-20 (voir docs/pcb/01-netlist.txt) : VBUS=A4/A9/B4/B9, GND=A1/A12/B1/B12+shield, D+=A6+B6, D-=A7+B7, CC1=A5, CC2=B5, pins SS/SBU non utilisees (design USB2.0 only).
J3,J4,J5,J6,J13 |  | Connecteur JST-SH 4pin | JST-SH-4P | — | 5 | Main | Bus I2C vers satellites (brochage Qwiic ; J13 ajoute le 2026-09-27 : 5 faces satellites en I2C)
J7 |  | Connecteur JST-SH 10pin | JST-SH-10P | — | 1 | Main | SPI3 vers 2x GC9A01 yeux
J7b |  | Connecteur JST-SH 8pin | JST-SH-8P | — | 1 | Main | SPI2 vers l ecran bouche (type a choisir)
J8 |  | Connecteur JST-SH 6pin | JST-SH-6P | — | 1 | Main | Cote 1 : 3V3_D, GND, SW1, SW2, BTN1 (J8.5), BTN2 (J8.6)
J9 |  | Connecteur JST-PH 4pin | JST-PH-4P | — | 1 | Main | WS2812 externes + reserve (le budget batterie limite a ~8-10 LEDs externes ; au-dela, alimenter la bande separement)
J2 |  | Connecteur batterie JST-PH 4pin (BAT+/BAT-/NTC/retour NTC) | JST-PH-4P | — | 1 | Main | Cellule 18650 + NTC collee, harnais 4 fils : le retour NTC va sur GND (VSS du bq24075), pas sur BAT- (audit 2026-09-27 H2)
J10 |  | Connecteur haut-parleur JST-PH 4pin | JST-PH-4P | — | 1 | Main | Sorties en pont L+/L-/R+/R- via ferrites FB3-FB6 — aucune masse commune, ne jamais relier les - entre elles ni a GND
J11 |  | Slot microSD push-push | TF-PUSH | C91145 | 1 | Main | Carte SD sur SPI2 partage (MISO=15 CS=47) - verifier ref LCSC avant commande
L1 | Sunlord SWPA5040S6R8MT | 6.8uH | SMD 5x5x4mm | C36411 | 1 | Main | Inductance boost MT3608 : 6,8 uH +-20 %, Isat 2,9 A, Irms 2,5 A, DCR 56 mOhm max (decision 2026-09-27, docs/datasheets/SWPA5040S.md) — remplace le 22uH 1210
C2,C3,C4,C5 |  | 100nF 16V ceramique X7R | 0402 | — | 4 | Main | Decouplage generique (ESP32 C2, micro C3, IMU C4/C5)
C_AVDD,C_DVDD,C_CPVDD,C_LDOO |  | 100nF 16V ceramique X7R | 0402 | — | 4 | Main | PCM5122 AVDD(pin8)/DVDD(pin28)/CPVDD(pin1)/LDOO(pin26) — 0,1 uF (docs/datasheets/pcm5122.md)
C_EN |  | 1uF 16V ceramique X5R | 0402 | — | 1 | Main | Filtre RC de EN (ESP32) : R6 10 k + 1 uF (guide Espressif, ESP32-S3-WROOM-1-hardware-design-guidelines.md). Etait range a tort dans la ligne 100 nF (corrige 2026-09-27)
C_D2,C_A2 |  | 10uF 10V ceramique X5R | 0805 | — | 2 | Main | Sorties LDO U5/U6
C_B1 |  | 22uF 16V ceramique X5R | 0805 | — | 1 | Main | Entree MT3608 (VSYS) — 22 uF recommandes par la datasheet MT3608, Capacitor Selection ; 16V pour le derating DC bias, comme C_B2
C15,C16,C17 |  | 10uF 16V ceramique X5R | 0805 | — | 3 | Main | Bulk decouplage PCM5122 (AVDD/DVDD/CPVDD)
C19,C20 |  | 2.2uF 25V ceramique X5R | 0603 | — | 2 | Main | Charge pump PCM5122
C21,C22 |  | 2.2nF 50V ceramique C0G/NP0 | 0603 | — | 2 | Main | Filtre RC sortie DAC PCM5122 (470 ohm + 2,2 nF)
C_IN | Samsung CL10A475KA8NQNC | 4.7uF 25V ceramique X5R | 0603 | C69335 | 1 | Main | bq24075 IN pin13 (datasheet : 1-10 uF). 25 V (decision 2026-09-27) contre les surtensions de branchement USB ; X5R (-55/+85 C) suffisant, garde l empreinte 0603
C_D1,C_A1 |  | 1uF 10V ceramique X5R | 0402 | — | 2 | Main | Entrees LDO U5/U6
C_B2 |  | 22uF 16V ceramique X5R | 0805 | — | 1 | Main | Sortie MT3608 boost (16V pour derating DC bias)
R1,R2 |  | 470 ohm | 0603 | — | 2 | Main | Filtre RC sortie DAC PCM5122 (470 ohm + 2,2 nF, docs/datasheets/pcm5122.md)
R3,R4 |  | 4.7k ohm | 0402 | — | 2 | Main | Pull-up I2C SDA/SCL
R5,R6 |  | 10k ohm | 0402 | — | 2 | Main | Pull-up XSMT (R5 vers 3V3_A) / EN ESP32 (R6)
R8 |  | 330 ohm | 0402 | — | 1 | Main | Serie WS2812 data
R_ILIM |  | 1.5k ohm | 0402 | — | 1 | Main | bq24075 ILIM pin12 (input current limit en mode RILIM EN2=H/EN1=L)
R_PG,R_CHG |  | 100k ohm | 0402 | — | 2 | Main | Pull-up PGOOD/CHG bq24075 (montees au schema)
R_ISET |  | 890 ohm | 0402 | — | 1 | Main | bq24075 ISET pin16 (charge current 1A)
R_VCC |  | 100 ohm | 0402 | — | 1 | Main | DW01A VCC serie (protection)
R_FB_H |  | 750k ohm | 0402 | — | 1 | Main | MT3608 feedback diviseur haut
R_FB_L |  | 100k ohm | 0402 | — | 1 | Main | MT3608 feedback diviseur bas
C_BAT |  | 4.7uF 10V ceramique X5R | 0603 | — | 1 | Main | bq24075 BAT decouplage
C_OUT |  | 4.7uF 10V ceramique X5R | 0603 | — | 1 | Main | bq24075 OUT decouplage
R_TS |  | 10k ohm (DNP) | 0402 | — | 1 | Main | DNP — remplacee par la NTC de la cellule sur J2.3. Monter l'une OU l'autre, jamais les deux
COTE2-R1,COTE2-R2 |  | 5.1k ohm | 0402 | — | 2 | Satellite Cote 2 | [Satellite Cote 2, projet hardware/cote2/ (ex-R9,R10 de la Main, deplace le 2026-09-27).] Au pied de J1. USB-C CC1/CC2
COTE2-J2 |  | Connecteur JST-PH 6pin | JST-PH-6P | — | 1 | Satellite Cote 2 | Liaison vers J14 de la Main (VBUS, GND, D-, D+, GND, 5V_HOST)
R11,R12 |  | 22 ohm | 0402 | — | 2 | Main | Serie USB D+/D-
D1 | SS34 (MDD) | Diode Schottky SS34 (3A) | SMA | C8678 | 1 | Main | Protection MT3608 (SS14 1A insuffisant — audit A5)
COTE2-U2 | CAP1298-1-SL-TR |  | SOIC-14 | C2652072 | 1 | Satellite Cote 2 | [Satellite Cote 2, projet hardware/cote2/ (U2).] Controleur tactile, adresse I2C FIXE 0x28 (un seul CAP12xx par bus). Repartition (decision 2026-09-27) : 6 touches CS1-CS4/CS6/CS7, proximite "approche ta main" sur CS8, garde SG sur CS5 autour de l electrode de proximite. ALERT# et N/C a GND (tableau 1-1), scrutation. docs/datasheets/CAP1298.md
COTE2-C1 |  | 100nF 16V ceramique X7R | 0402 | — | 1 | Satellite Cote 2 | [Satellite Cote 2 (C1).] Decouplage VDD CAP1298 au plus pres (DS00001571B figure 3-1)
COTE2-C2 |  | 1uF 10V ceramique X5R | 0402 | — | 1 | Satellite Cote 2 | [Satellite Cote 2 (C2).] Decouplage VDD CAP1298 (figure 3-1 : 1 uF + 0,1 uF)
COTE2-J3 |  | Connecteur JST-SH 4pin | JST-SH-4P | — | 1 | Satellite Cote 2 | [Satellite Cote 2 (J3).] Qwiic vers un des J3-J6/J13 de la Main : 1 GND, 2 3V3_D, 3 SDA, 4 SCL
DESSUS-U1 | ST25DV04KC-IE6S3 |  | SO-8 | C3304276 | 1 | Satellite Dessus | [Satellite Dessus, projet hardware/dessus/ (ex-U27).] Tag NFC dynamique I2C 0x53 + 0x57. Brochage SO8 DS10925 figure 2 : 1 V_EH (NC), 2 AC0, 3 AC1, 4 VSS, 5 SDA, 6 SCL, 7 GPO (NC), 8 VCC. Antenne ANT1 = boucle PCB (hors BOM) — docs/datasheets/ST25DV04K.md
DESSUS-C1 |  | 10nF 16V ceramique X7R | 0402 | — | 1 | Satellite Dessus | [Satellite Dessus (C1).] Decouplage VCC ST25DV au plus pres (DS10925 : 10 nF + 100 nF)
DESSUS-C2 |  | 100nF 16V ceramique X7R | 0402 | — | 1 | Satellite Dessus | [Satellite Dessus (C2).] Decouplage VCC ST25DV au plus pres (DS10925 : 10 nF + 100 nF)
DESSUS-C3 |  | DNP ceramique C0G/NP0 | 0402 | — | 1 | Satellite Dessus | [Satellite Dessus (C3).] NON MONTE — accord d antenne optionnel en parallele de C_TUN (28,5 pF interne), valeur a fixer a la mesure
DESSUS-J1 |  | Connecteur JST-SH 4pin | JST-SH-4P | — | 1 | Satellite Dessus | [Satellite Dessus (J1).] Qwiic vers un des J3-J6/J13 de la Main : 1 GND, 2 3V3_D, 3 SDA, 4 SCL
DEVANT-U1 | BMP280 |  | LGA-8 | C83291 | 1 | Satellite Devant | [Satellite Devant, projet hardware/devant/ (ex-U23).] Pression / souffle, I2C 0x76 : SDO -> GND, CSB direct sur VDDIO. Trou d event vers l ouverture de la bouche — docs/datasheets/BMP280.md
DEVANT-U2 | VEML7700-TT |  | OPLGA | C1850416 | 1 | Satellite Devant | [Satellite Devant (ex-U22).] Lumiere ambiante I2C 0x10. Brochage 1 SCL, 2 VDD, 3 GND, 4 SDA (datasheet + AN figure 2) — docs/datasheets/VEML7700.md
DEVANT-C1,DEVANT-C2,DEVANT-C3 |  | 100nF 16V ceramique X7R | 0402 | — | 3 | Satellite Devant | [Satellite Devant (ex-C30-C32).] Decouplage BMP280 VDD (C1) + VDDIO (C2), VEML7700 (C3)
DEVANT-J1 |  | Connecteur JST-SH 4pin | JST-SH-4P | — | 1 | Satellite Devant | [Satellite Devant (J1).] Qwiic vers un des J3-J6/J13 de la Main : 1 GND, 2 3V3_D, 3 SDA, 4 SCL
DEVANT-J2 |  | Connecteur JST-SH 10pin | JST-SH-10P | — | 1 | Satellite Devant | [Satellite Devant (J2).] Liaison J7 de la Main (SPI3 yeux), meme ordre, cable broche a broche
DEVANT-J3 |  | Connecteur JST-SH 8pin | JST-SH-8P | — | 1 | Satellite Devant | [Satellite Devant (J3).] Liaison J7b de la Main (SPI2 bouche), meme ordre, cable broche a broche
DEVANT-J4,DEVANT-J5,DEVANT-J6 |  | Barrette femelle 1x8 2,54 mm | PinSocket_1x08_P2.54mm_Vertical | — | 3 | Satellite Devant | [Satellite Devant.] Embases des modules : J4/J5 yeux GC9A01, J6 bouche — brochage PROVISOIRE tant que les modules ne sont pas choisis
DEVANT-J7 |  | Connecteur JST-PH 4pin | JST-PH-4P | — | 1 | Satellite Devant | [Satellite Devant (J7).] Liaison J9 de la Main (5V, GND, DATA halo, NC)
DEVANT-R1 |  | 0 ohm | 0603 | — | 1 | Satellite Devant | [Satellite Devant (R1).] Retroeclairage des yeux (BLK) sur 3V3_D — provisoire, a fixer avec la fiche du module
DEVANT-LED1,DEVANT-LED2,DEVANT-LED3,DEVANT-LED4,DEVANT-LED5,DEVANT-LED6,DEVANT-LED7,DEVANT-LED8 | WS2812B-B/W | LED RGB adressable | LED-SMD 5x5 | C2761795 | 8 | Satellite Devant | [Satellite Devant.] Halo visage, suite de la chaine de la Main (J9). Nombre provisoire (~8-10 externes au budget batterie). Sans condensateur (datasheet V5)
— |  | GC9A01 module 1.28 rond | Module | — | 2 | Satellite Devant | Yeux du personnage 240x240 SPI (modules achetes) sur DEVANT-J4/J5 — fiche du module a recuperer
— |  | Ecran bouche (a choisir, pas e-ink) | Module | — | 1 | Satellite Devant | Type non choisi (FSD) — SPI2 via J7b / DEVANT-J6
COTE1-U1 | ADS7830IPWR |  | TSSOP-16 | C161747 | 1 | Satellite Cote 1 | [Satellite Cote 1, projet hardware/cote1/ (ex-U26).] ADC 8 voies 8 bits I2C 0x48 : SL1-SL4 sur CH0-CH3, RV1-RV4 sur CH4-CH7, REFIN = 3V3_D (ratiometrique) — docs/datasheets/ADS7830.md
COTE1-C1 |  | 100nF 16V ceramique X7R | 0402 | — | 1 | Satellite Cote 1 | [Satellite Cote 1 (ex-C_FP1).] Bypass VDD ADS7830 au plus pres (SBAS302C : 0,1 uF)
COTE1-C2,COTE1-C3 |  | 1uF 10V ceramique X5R | 0402 | — | 2 | Satellite Cote 1 | [Satellite Cote 1.] C2 : VDD alimente par cable (SBAS302C : 1-10 uF) ; C3 (ex-C_FP2) : REFIN
COTE1-SL1,COTE1-SL2,COTE1-SL3,COTE1-SL4 | Bourns PTA6043-2015CPB103 |  | Slide-PTA6043-60mm | C17203852 | 4 | Satellite Cote 1 | Fader 60mm 10kOhm lineaire carbon (enigmes) ; pattes 4-7 (cadre) a GND - datasheet docs/datasheets/Bourns-PTA6043.pdf
COTE1-RV1,COTE1-RV2,COTE1-RV3,COTE1-RV4 | Bourns PDB181-K420K-103B |  | Pot-PDB181-17mm-panel | C6251250 | 4 | Satellite Cote 1 | Pot rotatif 17mm 10kOhm lineaire knurled axe 6mm (enigmes) - datasheet docs/datasheets/Bourns-PDB181.pdf
COTE1-J2 |  | Connecteur JST-SH 6pin | JST-SH-6P | — | 1 | Satellite Cote 1 | [Satellite Cote 1 (J2).] Liaison J8 de la Main : 3V3_D, GND, SW1, SW2, BTN1, BTN2, cable broche a broche
COTE1-J3 |  | Connecteur JST-SH 4pin | JST-SH-4P | — | 1 | Satellite Cote 1 | [Satellite Cote 1 (J3).] Qwiic vers un des J3-J6/J13 de la Main : 1 GND, 2 3V3_D, 3 SDA, 4 SCL
COTE1-J4,COTE1-J5,COTE1-J6,COTE1-J7 |  | Connecteur JST-PH 2pin | JST-PH-2P | — | 4 | Satellite Cote 1 | [Satellite Cote 1.] Fils vers les organes de facade : J4 SW1 / J5 SW2 (signal, GND), J6 BTN1 / J7 BTN2 (signal, 3V3_D)
SW1,SW2 | E-Switch 100SP1T1B4M1QE |  | Toggle-100SP-12mm-bushing | — | 2 | Cote 1 | Toggle SPDT ON-ON panel 12mm (a sourcer DigiKey/Mouser - non LCSC), cable vers COTE1-J4/J5 ; finition or a confirmer - datasheet docs/datasheets/E-Switch-100-series-toggle.pdf
BTN1,BTN2 |  | Bouton poussoir momentane (a choisir) | Panel | — | 2 | Cote 1 | Montage panneau, cable vers COTE1-J6/J7 : contact vers 3V3_D, ACTIF HAUT (pull-down R23/R24 sur la Main) — reference non choisie
COTE3-U1 | TMAG5273A1QDBVR |  | SOT-23-6 | C3716049 | 1 | Satellite Cote 3 | [Satellite Cote 3, projet hardware/cote3/ (ex-U25).] Hall lineaire 3D I2C, variante A1 (+-40/80 mT, 0x35) ; TEST et INT -> GND (MASK_INTB=1) — docs/datasheets/TMAG5273.md
COTE3-C1 |  | 100nF 16V ceramique X7R | 0402 | — | 1 | Satellite Cote 3 | [Satellite Cote 3 (ex-C33).] Decouplage VCC TMAG5273 (SLYS045C §7.4 : >= 0,01 uF)
COTE3-J1 |  | Connecteur JST-SH 4pin | JST-SH-4P | — | 1 | Satellite Cote 3 | [Satellite Cote 3 (J1).] Qwiic vers un des J3-J6/J13 de la Main : 1 GND, 2 3V3_D, 3 SDA, 4 SCL
LS1 | PUI Audio AS04008PO-2-R | Haut-parleur 8 ohms 1 W (2 W max) | Module | — | 1 | Satellite Dessus | Cable depuis J10 de la Main (canal L en pont via FB3/FB4) — docs/datasheets/AS04008PO.md
Q1 | AO3401A | MOSFET P AO3401A -30V -4A | SOT-23 | C15127 | 1 | Main | Load switch rail 5V (marche/arret)
Q2 | 2N7002 | MOSFET N 2N7002 | SOT-23 | C8545 | 1 | Main | Inverseur de commande du load switch
R20 |  | 2.2k 1% | 0402 | — | 1 | Main | Pull-down EN_SYS. 2,2 k (et non 100 k) depuis le 2026-09-27 : courant de contact ~1,5 mA (VSYS 3,4 V) a 2,5 mA (5,5 V) dans SW3 (contacts argent E-Switch RR1), uniquement box allumee ; 14 mW max
R21 |  | 100k 1% | 0402 | — | 1 | Main | Grille-source Q1 (load switch)
J14 |  | Connecteur JST-PH 6pin | JST-PH-6P | — | 1 | Main | Liaison USB vers le satellite Cote 2 : 1 VBUS (5V_USB, ~1,1 A), 2 GND, 3 D-, 4 D+, 5 GND, 6 5V_HOST (reserve mode hote)
R22 |  | 0 ohm (DNP) | 0603 | — | 1 | Main | Reserve mode hote USB : relie le rail 5V a J14.6 pour alimenter une cle. NON MONTEE
R23,R24 |  | 10k ohm | 0402 | — | 2 | Main | Pull-down BTN1/BTN2 (GPIO45/46, strapping) vers J8.5/J8.6 — boutons actifs hauts, JAMAIS de pull-up
J12 |  | Connecteur JST-SH 2pin | JST-SH-2P | — | 1 | Main | Interrupteur marche/arret (face Cote 2)
SW3 | E-Switch RR111C1921 | Interrupteur a bascule rond Off-On, bascule rouge marquee I/O | Panel Ø20mm, cosses faston 4.8mm | — | 1 | Cote 2 | Face Cote 2 (decision 2026-09-27), cable DIRECT vers J12 de la Main (VSYS, EN_SYS) par cosses faston 4,8 mm. Non lumineux. Contacts ARGENT pour ~50 uA : voir RESTE-A-FAIRE (courant dans le contact / R20). DigiKey/Mouser (stock LCSC 0). docs/datasheets/E-Switch-RR1.md
— |  | Cellule 18650 3400-3500mAh (LG MJ1 / Samsung 35E / Panasonic NCR18650B) | 18650 | — | 1 | Batterie | Cellule nue — protection assuree par DW01A+FS8205 sur la carte
— |  | NTC 10k B3950 a coller sur la cellule | axial/CMS | — | 1 | Batterie | Surveillance thermique de charge (bq24075 TS) — fenetre 0-50 C
— |  | Support 18650 ou cellule a languettes | — | — | 1 | Batterie | Jamais de soudure au fer sur une cellule
FB3,FB4,FB5,FB6 | BLM21PG221SN1D | 220R@100MHz 2A | 0805 | C85840 | 4 | Main | Ferrites sortie haut-parleur (exigees par la datasheet PAM8406 en classe D sans filtre)
R13,R14 |  | 22 ohm | 0603 | — | 2 | Main | Resistances serie horloges SPI2/SPI3 (ex-ferrites FB1/FB2 — une ferrite arrondit les fronts)
R15,R16,R17,R18,R19 |  | 10k | 0402 | — | 5 | Main | Pull-ups carte SD (CS/DAT3 CMD DAT0 DAT1 DAT2) — obligatoires (ESP-IDF sd_pullup_requirements)
R_TMR |  | 56k 1% | 0402 | — | 1 | Main | Timer de securite bq24075 : t_MAXCHG 5.6-9.3 h (etait TMR->GND = timers desactives)
LED2,LED3,LED4,LED5,LED6,LED7,LED8,LED9,LED10,LED11,LED12,LED13 | WS2812B-B/W | LED RGB adressable | LED-SMD 5x5 | C2761795 | 12 | Main | Halo face Dessous — plafond de luminosite firmware obligatoire (budget batterie)
C_PAM_HF1,C_PAM_HF2,C_PAM_HF3,C_PAM_INL,C_PAM_INR,C_PAM_VREF |  | 1uF 16V ceramique X7R | 0603 | — | 6 | Main | PAM8406 : decouplage HF + liaison entrees + VREF
C_PAM_BULK |  | 22uF 10V ceramique X5R | 0805 | — | 1 | Main | PAM8406 : reservoir (datasheet : >= 20uF pres de l ampli)
C_U9 |  | 100nF 16V ceramique X7R | 0402 | — | 1 | Main | Decouplage DW01A
C_VBAT_SENSE |  | 100nF 16V ceramique X7R | 0402 | — | 1 | Main | Filtrage du pont diviseur VBAT_SENSE (ADC1_CH2)
R_MUTE,R_SHDN,R_MODE_D |  | 10k ohm | 0402 | — | 3 | Main | PAM8406 : MUTE/SHDN tires hauts + MODE vers 3V3_A (classe D)
R_MODE_AB |  | 10k ohm (DNP) | 0402 | — | 1 | Main | Alternative classe AB (MODE vers GND) — NE JAMAIS monter en meme temps que R_MODE_D
R_SD_PD |  | 100k ohm | 0402 | — | 1 | Main | Pull-down SD du micro ICS-43434 (datasheet)
R_CS |  | 1k ohm | 0402 | — | 1 | Main | DW01A : resistance de detection (application typique)
R_VBAT_H,R_VBAT_L |  | 1M ohm 1% | 0402 | — | 2 | Main | Pont diviseur VBAT_SENSE 1:1
TP_EN,TP_GPIO0,TP_I2CA,TP_I2CL |  | Point de test | TestPoint_Pad_D1.5mm | — | 4 | Main | Pastilles de test (EN, GPIO0, I2C SDA/SCL)
C_CLK2,C_CLK3 |  | 10pF (DNP) C0G/NP0 | 0402 | — | 2 | Main | Provision CEM sur les horloges SPI — non montees
C1 |  | 10uF 16V ceramique X5R | 0603 | — | 1 | Main | Reservoir 3V3_D au pied du module ESP32-S3
TP_VBUS1,TP_VSYS1,TP_VBAT1,TP_3V3D1,TP_3V3A1,TP_5VB1,TP_5V1,TP_GND1,TP_GND2,TP_GND3 |  | Point de test alimentation | TestPoint_Pad_D1.5mm | — | 10 | Main | Rails et masses — voir docs/pcb/03-validation-qualite.md
TP_ISET1,TP_CHG1,TP_FB1,TP_TS1,TP_ENSYS1,TP_GATE1 |  | Point de test diagnostic | TestPoint_Pad_D1.5mm | — | 6 | Main | Courant de charge, etat chargeur, boucle du boost, NTC, marche/arret, load switch
TP_SCLK2,TP_SCLK3,TP_I2SBCK,TP_I2SLRCK,TP_AUDIOL,TP_WS2812,TP_TXD0,TP_RXD0 |  | Point de test signaux | TestPoint_Pad_D1.5mm | — | 8 | Main | Fronts des horloges SPI, I2S, sortie DAC, data LED, console UART0 (TX/RX, adaptateur USB-serie 3,3 V)
