GillesClerc/blackbox/hardware/cote2/cote2.kicad_sch

## KiCad design hardware/cote2/cote2.kicad_sch (2026-09-27, an earlier design)

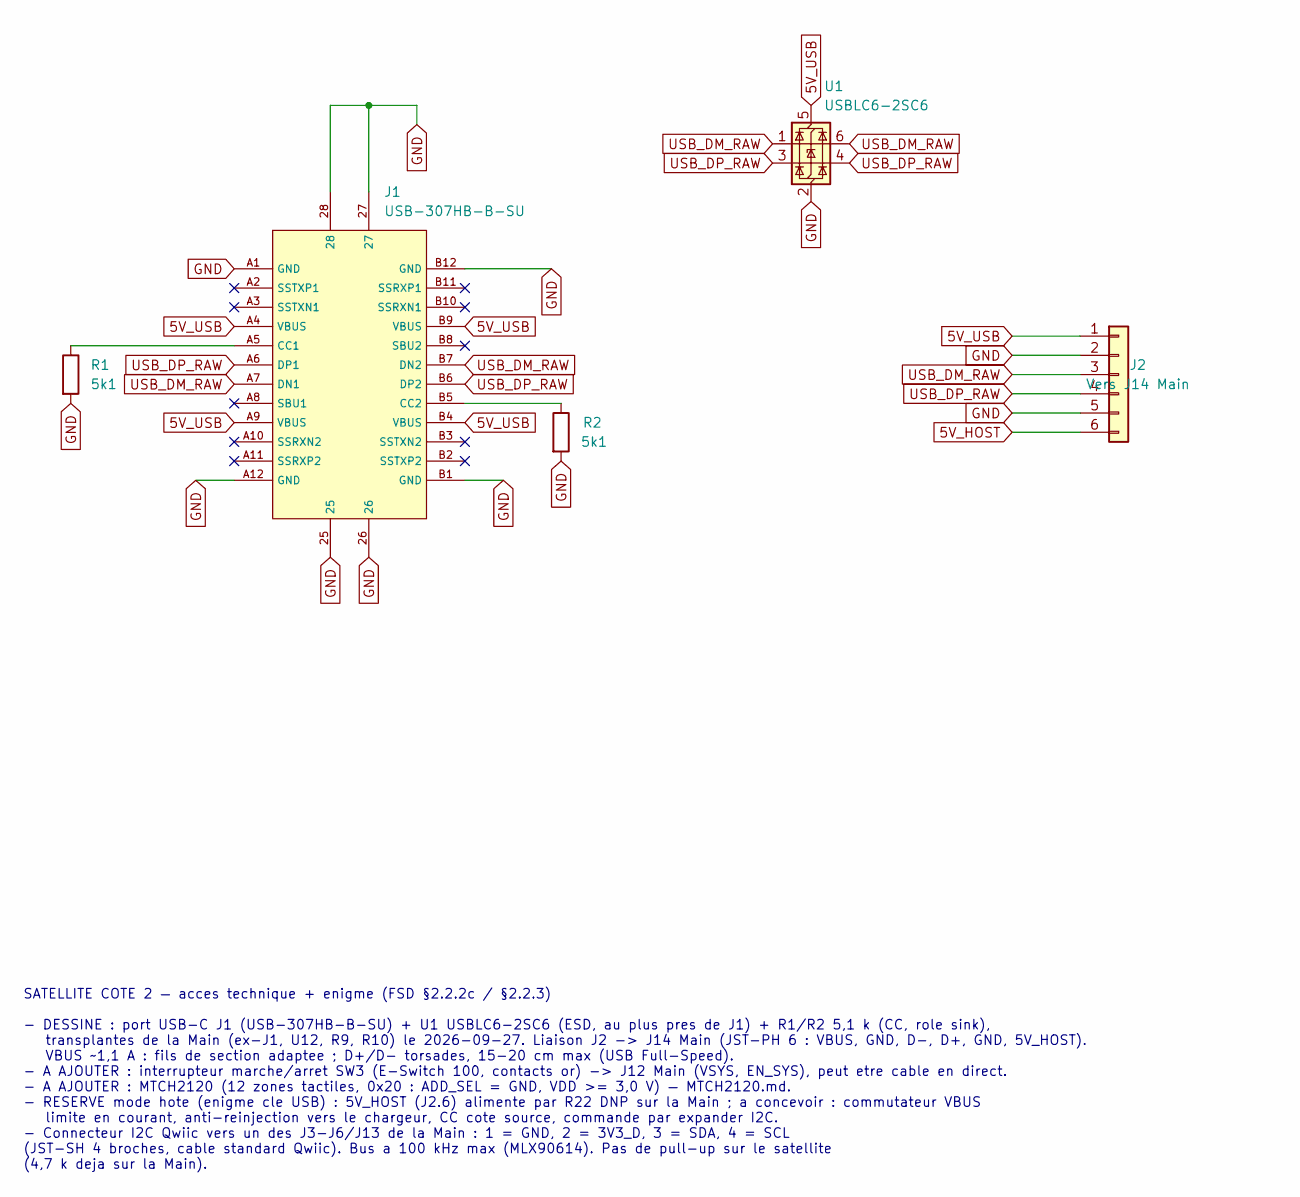
[picture p1: schematic cote2.kicad_sch]

Parts:
J1: USB-307HB-B-SU; C309361_USB-C-SMD_USB-307HB-B-SU; LCSC C309361
J2: Vers J14 Main; JST_PH_B6B-PH-K_1x06_P2.00mm_Vertical
R1, R2: 5k1; R_0402_1005Metric
U1: USBLC6-2SC6; SOT-23-6

Connections:
5V_HOST: J2.6
5V_USB: J1.A4 (VBUS), J1.A9 (VBUS), J1.B4 (VBUS), J1.B9 (VBUS), J2.1, U1.5 (VBUS)
GND: J1.25, J1.26, J1.27, J1.28, J1.A1 (GND), J1.A12 (GND), J1.B1 (GND), J1.B12 (GND), J2.2, J2.5, R1.2, R2.2, U1.2 (GND)
unnamed: J1.A5 (CC1), R1.1
unnamed: J1.B5 (CC2), R2.1
USB_DM_RAW: J1.A7 (DN1), J1.B7 (DN2), J2.3, U1.1 (I/O1), U1.6 (I/O1)
USB_DP_RAW: J1.A6 (DP1), J1.B6 (DP2), J2.4, U1.3 (I/O2), U1.4 (I/O2)

Notes on the sheet:
SATELLITE COTE 2 — acces technique + enigme (FSD §2.2.2c / §2.2.3) - DESSINE : port USB-C J1 (USB-307HB-B-SU) + U1 USBLC6-2SC6 (ESD, au plus pres de J1) + R1/R2 5,1 k (CC, role sink), transplantes de la Main (ex-J1, U12, R9, R10) le 2026-09-27. Liaison J2 -> J14 Main (JST-PH 6 : VBUS, GND, D-, D+, 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
