GillesClerc/blackbox/hardware/main/audio.kicad_sch

## KiCad design hardware/main/audio.kicad_sch (2026-09-27, an earlier design)

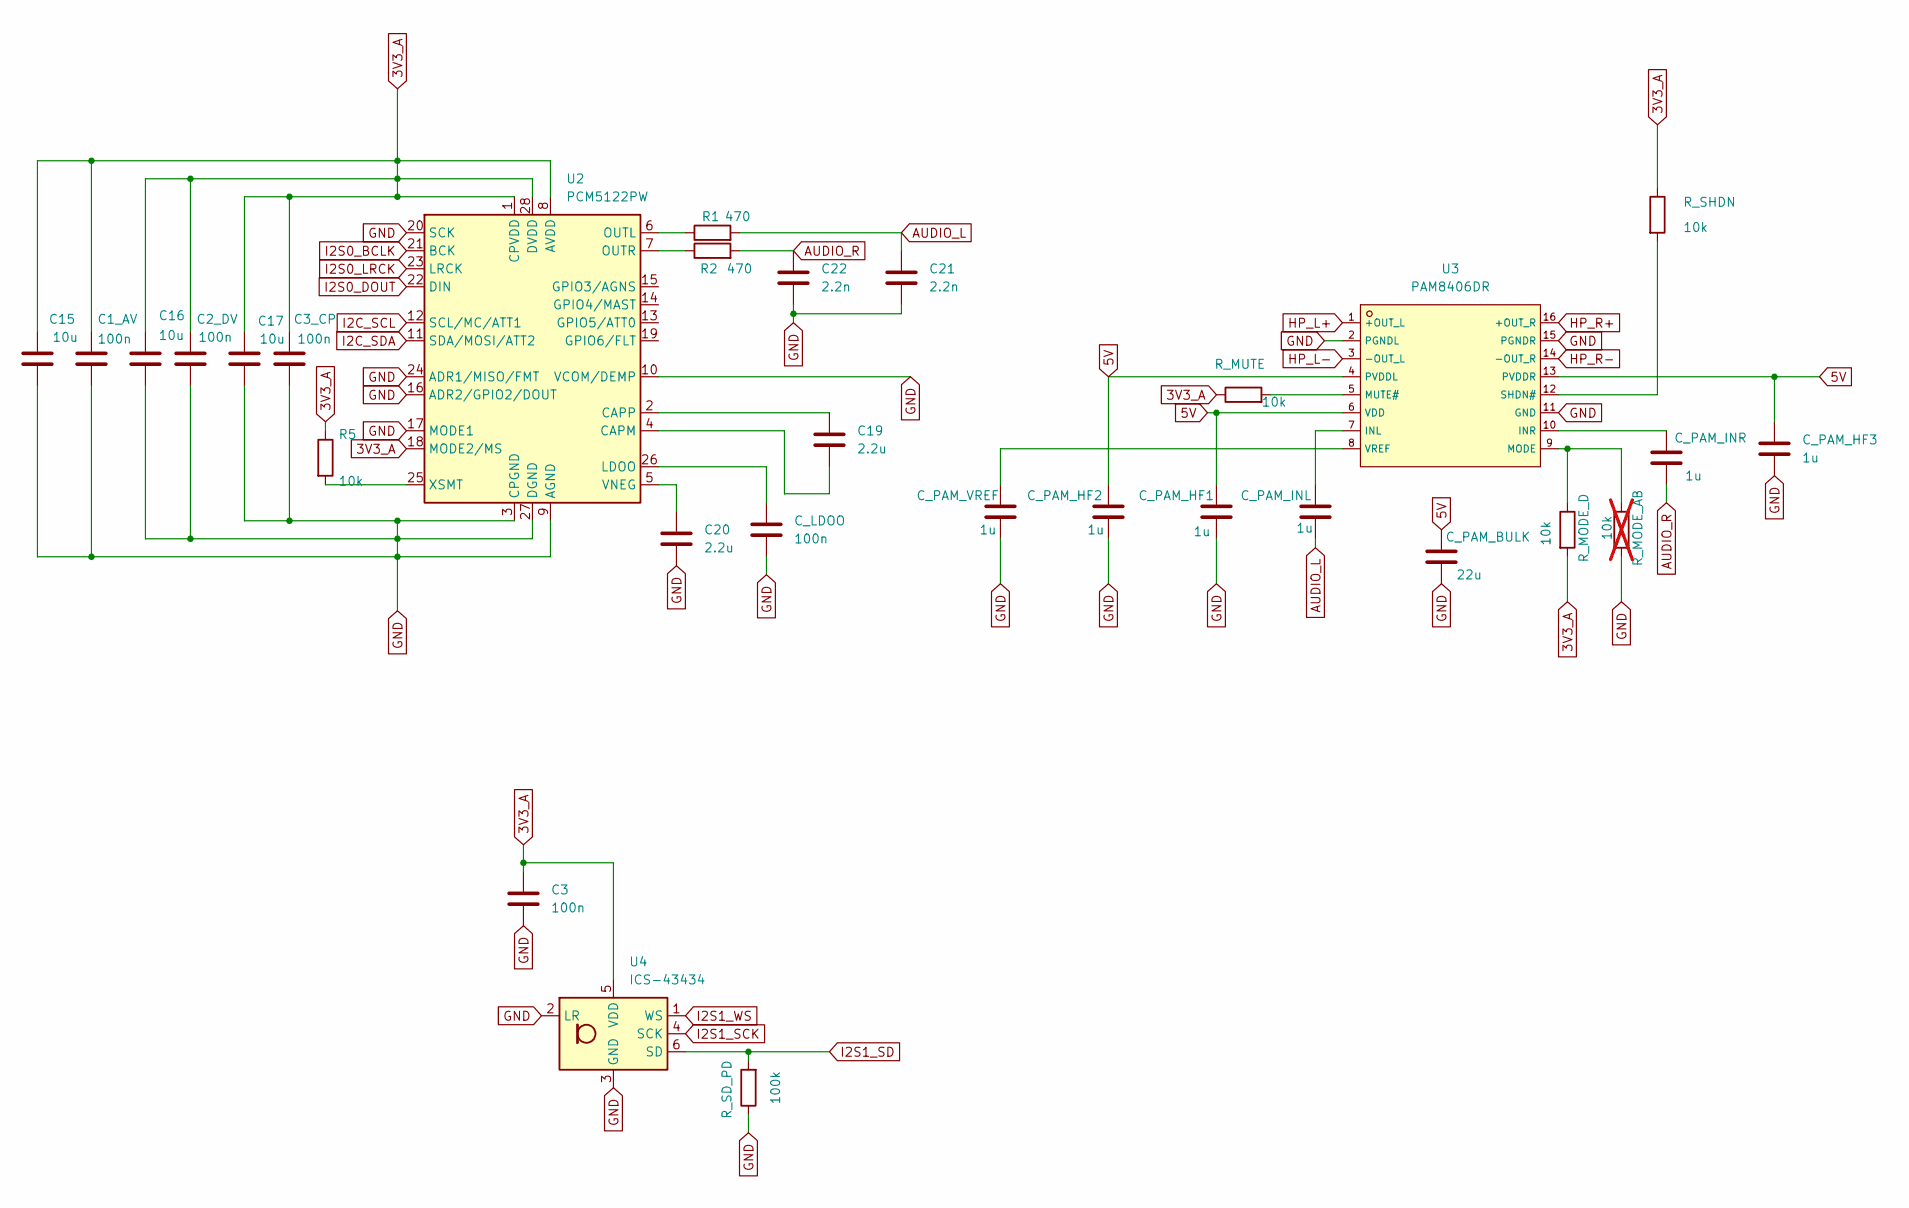
[picture p2: schematic audio.kicad_sch]

Parts:
C1_AV, C2_DV, C3, C3_CP: 100n; C_0402_1005Metric
C15, C16, C17: 10u; C_0805_2012Metric
C19, C20: 2.2u; C_0603_1608Metric
C21, C22: 2.2n; C_0603_1608Metric
C_LDOO: 100n; C_0402_1005Metric
C_PAM_BULK: 22u; C_0805_2012Metric
C_PAM_HF1, C_PAM_HF2, C_PAM_HF3: 1u; C_0603_1608Metric
C_PAM_INL: 1u; C_0603_1608Metric
C_PAM_INR: 1u; C_0603_1608Metric
C_PAM_VREF: 1u; C_0603_1608Metric
R1, R2: 470; R_0603_1608Metric
R5: 10k; R_0402_1005Metric
R_MODE_AB: 10k; R_0402_1005Metric; not fitted
R_MODE_D: 10k; R_0402_1005Metric
R_MUTE: 10k; R_0402_1005Metric
R_SD_PD: 100k; R_0402_1005Metric
R_SHDN: 10k; R_0402_1005Metric
U2: PCM5122PW; TSSOP-28_4.4x9.7mm_P0.65mm
U3: PAM8406DR; C86270_SOIC-16_L9_9-W3_9-P1_27-LS6_0-BL; LCSC C86270
U4: ICS-43434; InvenSense_ICS-43434-6_3.5x2.65mm

Connections:
3V3_A: C1_AV.1, C2_DV.1, C3.1, C3_CP.1, C15.1, C16.1, C17.1, R5.1, R_MODE_D.2, R_MUTE.1, R_SHDN.1, U2.1 (CPVDD), U2.8 (AVDD), U2.18 (MODE2/MS), U2.28 (DVDD), U4.5 (VDD)
5V: C_PAM_BULK.1, C_PAM_HF1.2, C_PAM_HF2.2, C_PAM_HF3.1, U3.4 (PVDDL), U3.6 (VDD), U3.13 (PVDDR)
AUDIO_L: C21.1, C_PAM_INL.2, R1.2
AUDIO_R: C22.1, C_PAM_INR.2, R2.2
GND: C1_AV.2, C2_DV.2, C3.2, C3_CP.2, C15.2, C16.2, C17.2, C20.2, C21.2, C22.2, C_LDOO.2, C_PAM_BULK.2, C_PAM_HF1.1, C_PAM_HF2.1, C_PAM_HF3.2, C_PAM_VREF.2, R_MODE_AB.2, R_SD_PD.1, U2.3 (CPGND), U2.9 (AGND), U2.10 (VCOM/DEMP), U2.16 (ADR2/GPIO2/DOUT), U2.17 (MODE1), U2.20 (SCK), U2.24 (ADR1/MISO/FMT), U2.27 (DGND), U3.2 (PGNDL), U3.11 (GND), U3.15 (PGNDR), U4.2 (LR), U4.3 (GND)
HP_L+: U3.1 (+OUT_L)
HP_L-: U3.3 (-OUT_L)
HP_R+: U3.16 (+OUT_R)
HP_R-: U3.14 (-OUT_R)
I2C_SCL: U2.12 (SCL/MC/ATT1)
I2C_SDA: U2.11 (SDA/MOSI/ATT2)
I2S0_BCLK: U2.21 (BCK)
I2S0_DOUT: U2.22 (DIN)
I2S0_LRCK: U2.23 (LRCK)
I2S1_SCK: U4.4 (SCK)
I2S1_SD: R_SD_PD.2, U4.6 (SD)
I2S1_WS: U4.1 (WS)
unnamed: C19.1, U2.2 (CAPP)
unnamed: C19.2, U2.4 (CAPM)
unnamed: C20.1, U2.5 (VNEG)
unnamed: C_LDOO.1, U2.26 (LDOO)
unnamed: C_PAM_INL.1, U3.7 (INL)
unnamed: C_PAM_INR.1, U3.10 (INR)
unnamed: C_PAM_VREF.1, U3.8 (VREF)
unnamed: R1.1, U2.6 (OUTL)
unnamed: R2.1, U2.7 (OUTR)
unnamed: R5.2, U2.25 (XSMT)
unnamed: R_MODE_AB.1, R_MODE_D.1, U3.9 (MODE)
unnamed: R_MUTE.2, U3.5 (MUTE#)
unnamed: R_SHDN.2, U3.12 (SHDN#)
