GillesClerc/blackbox/hardware/main/esp32.kicad_sch

## KiCad design hardware/main/esp32.kicad_sch (2026-09-27, an earlier design)

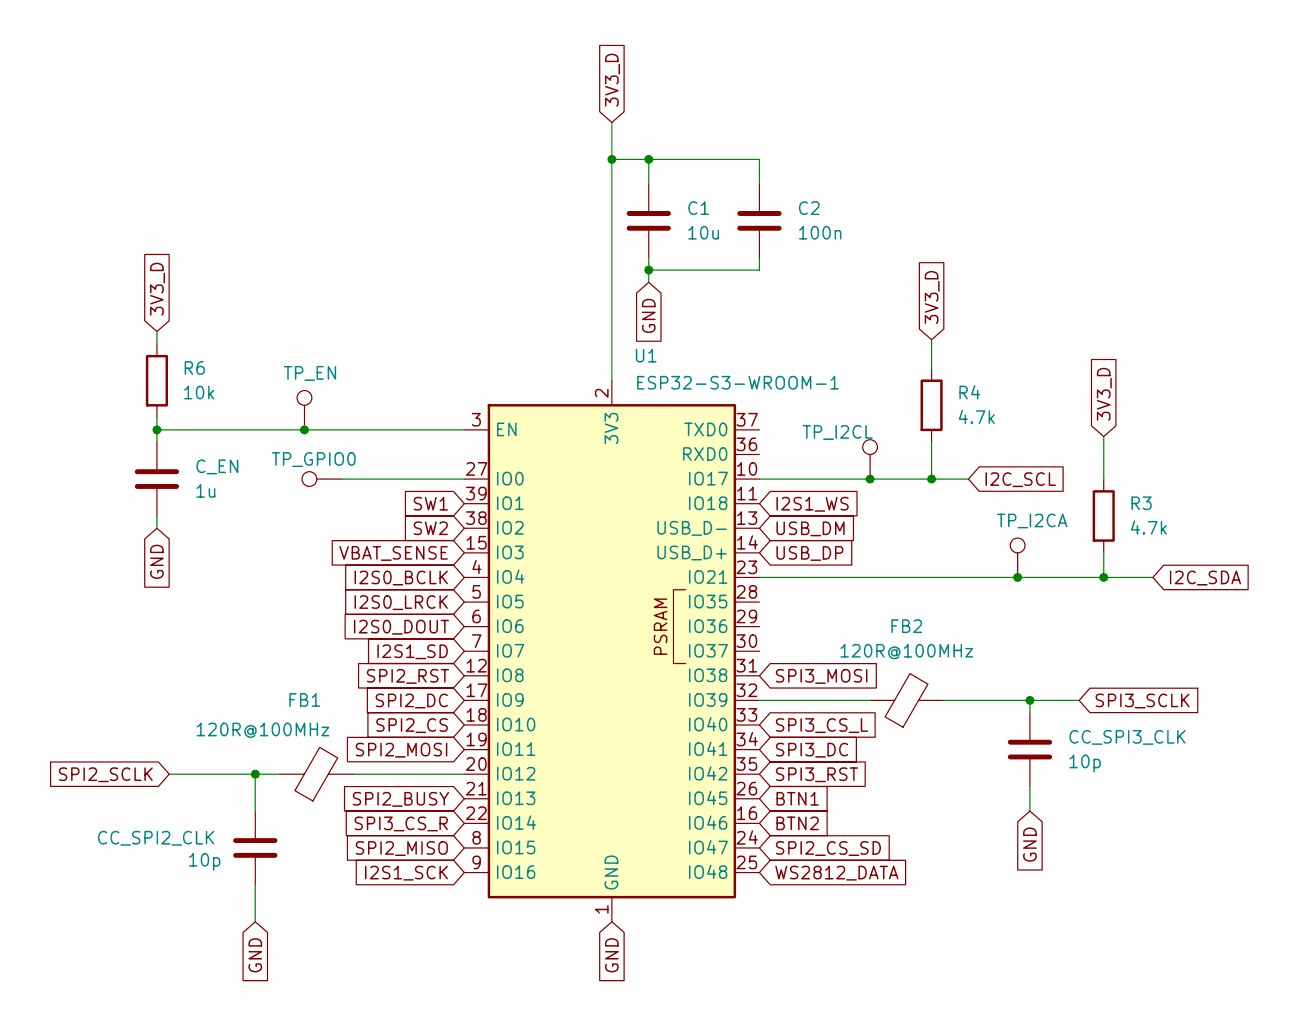
[picture p4: schematic esp32.kicad_sch]

Parts:
C1: 10u; C_0603_1608Metric
C2: 100n; C_0402_1005Metric
CC_SPI2_CLK, CC_SPI3_CLK: 10p; C_0402_1005Metric
C_EN: 1u; C_0402_1005Metric
FB1, FB2: 120R@100MHz; L_0603_1608Metric
R3, R4: 4.7k; R_0402_1005Metric
R6: 10k; R_0402_1005Metric
TP_EN: TestPoint; TestPoint_Pad_D1.5mm
TP_GPIO0: TestPoint; TestPoint_Pad_D1.5mm
TP_I2CA, TP_I2CL: TestPoint; TestPoint_Pad_D1.5mm
U1: ESP32-S3-WROOM-1

Connections:
3V3_D: C1.1, C2.1, R3.1, R4.1, R6.1, U1.2 (3V3)
BTN1: U1.26 (IO45)
BTN2: U1.16 (IO46)
GND: C1.2, C2.2, CC_SPI2_CLK.2, CC_SPI3_CLK.2, C_EN.2, U1.1 (GND), U1.40 (GND), U1.41 (GND)
I2C_SCL: R4.2, TP_I2CL.1, U1.10 (IO17)
I2C_SDA: R3.2, TP_I2CA.1, U1.23 (IO21)
I2S0_BCLK: U1.4 (IO4)
I2S0_DOUT: U1.6 (IO6)
I2S0_LRCK: U1.5 (IO5)
I2S1_SCK: U1.9 (IO16)
I2S1_SD: U1.7 (IO7)
I2S1_WS: U1.11 (IO18)
unnamed: C_EN.1, R6.2, TP_EN.1, U1.3 (EN)
unnamed: FB1.2, U1.20 (IO12)
unnamed: FB2.1, U1.32 (IO39)
unnamed: TP_GPIO0.1, U1.27 (IO0)
SPI2_BUSY: U1.21 (IO13)
SPI2_CS: U1.18 (IO10)
SPI2_CS_SD: U1.24 (IO47)
SPI2_DC: U1.17 (IO9)
SPI2_MISO: U1.8 (IO15)
SPI2_MOSI: U1.19 (IO11)
SPI2_RST: U1.12 (IO8)
SPI2_SCLK: CC_SPI2_CLK.1, FB1.1
SPI3_CS_L: U1.33 (IO40)
SPI3_CS_R: U1.22 (IO14)
SPI3_DC: U1.34 (IO41)
SPI3_MOSI: U1.31 (IO38)
SPI3_RST: U1.35 (IO42)
SPI3_SCLK: CC_SPI3_CLK.1, FB2.2
SW1: U1.39 (IO1)
SW2: U1.38 (IO2)
USB_DM: U1.13 (USB_D-)
USB_DP: U1.14 (USB_D+)
VBAT_SENSE: U1.15 (IO3)
WS2812_DATA: U1.25 (IO48)
