GillesClerc/blackbox/hardware/main/imu.kicad_sch

## KiCad design hardware/main/imu.kicad_sch (2026-09-27, an earlier design)

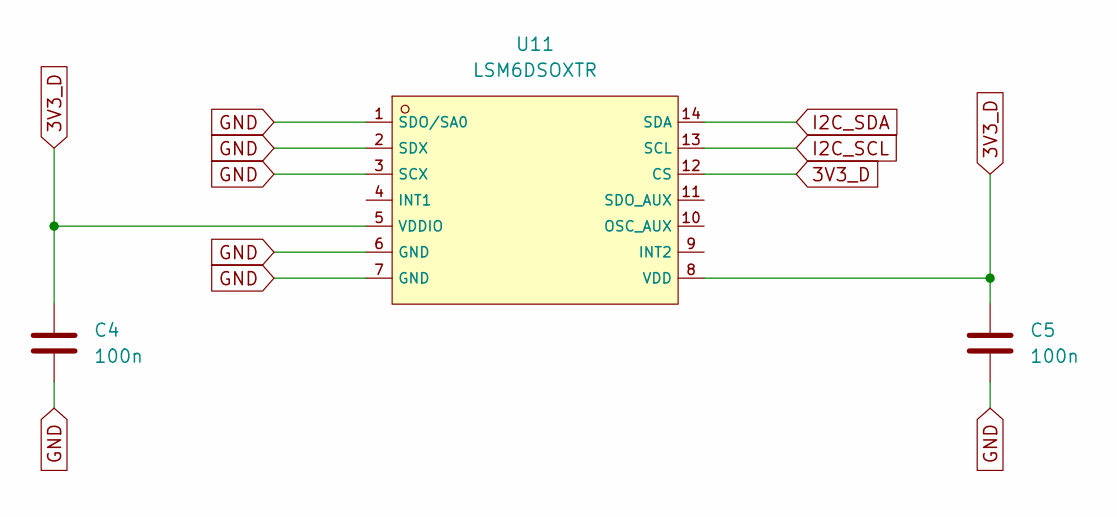
[picture p5: schematic imu.kicad_sch]

Parts:
C4, C5: 100n; C_0402_1005Metric
U11: LSM6DSOXTR; C481766_LGA-14L_L3_0-W2_5-P0_50-TL; LCSC C481766

Connections:
3V3_D: C4.1, C5.1, U11.5 (VDDIO), U11.8 (VDD), U11.12 (CS)
GND: C4.2, C5.2, U11.1 (SDO/SA0), U11.2 (SDX), U11.3 (SCX), U11.6 (GND), U11.7 (GND)
I2C_SCL: U11.13 (SCL)
I2C_SDA: U11.14 (SDA)
