GillesClerc/blackbox/hardware/main/power.kicad_sch

## KiCad design hardware/main/power.kicad_sch (2026-09-27, an earlier design)

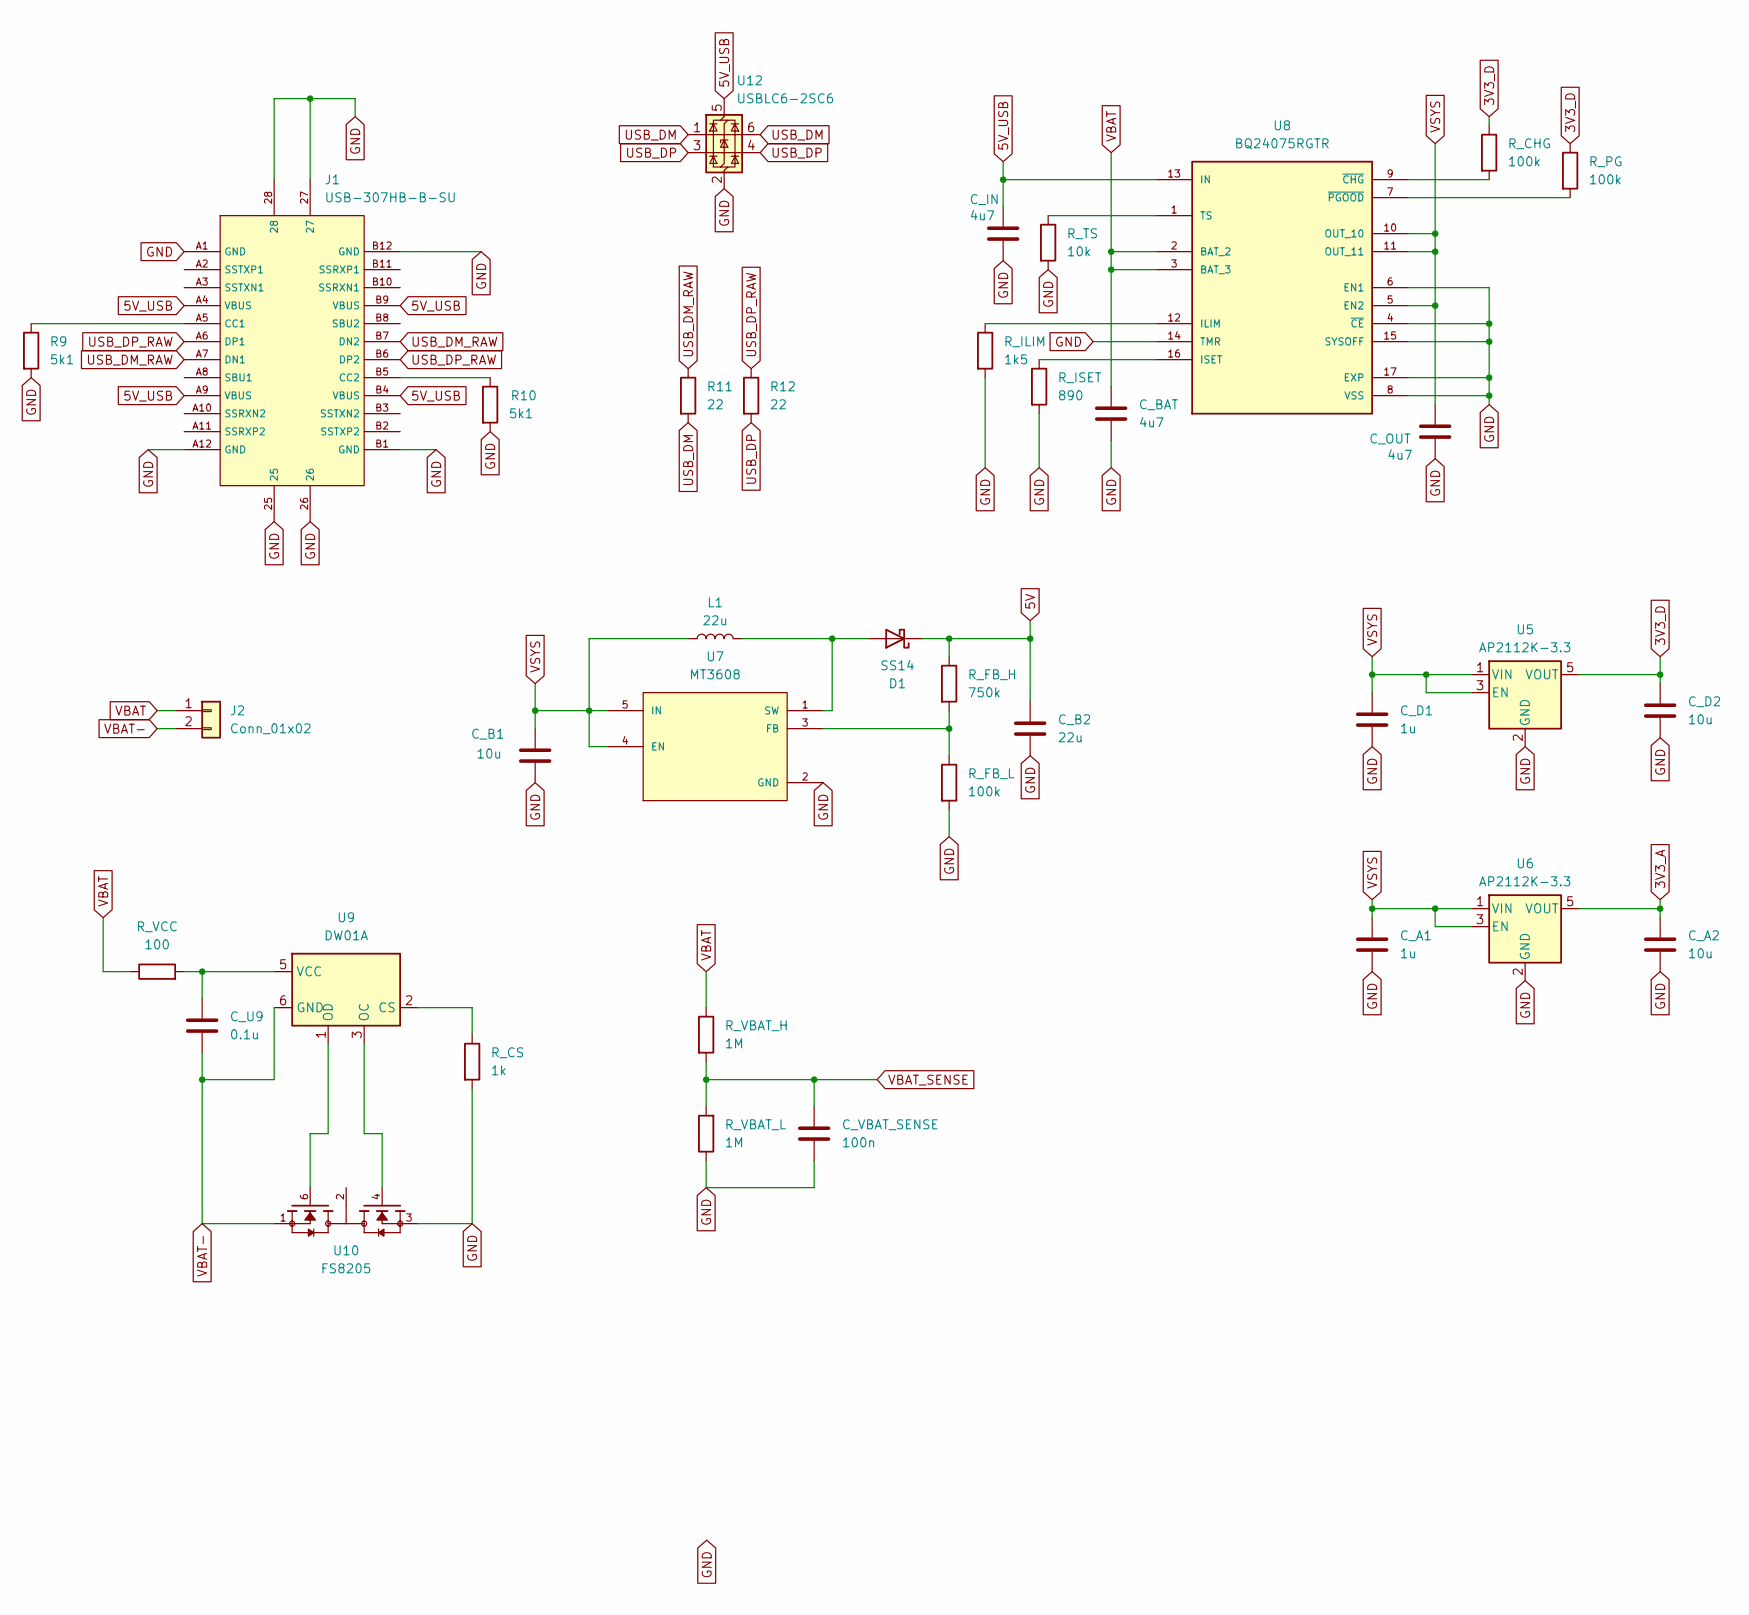
[picture p6: schematic power.kicad_sch]

Parts:
C_A1: 1u; C_0402_1005Metric
C_A2: 10u; C_0805_2012Metric
C_B1: 10u; C_0805_2012Metric
C_B2: 22u; C_0805_2012Metric
C_BAT: 4u7; C_0603_1608Metric
C_D1: 1u; C_0402_1005Metric
C_D2: 10u; C_0805_2012Metric
C_IN: 4u7; C_0603_1608Metric
C_OUT: 4u7; C_0603_1608Metric
C_U9: 0.1u; C_0402_1005Metric
C_VBAT_SENSE: 100n; C_0402_1005Metric
D1: SS14; D_SMA
J1: USB-307HB-B-SU; C309361_USB-C-SMD_USB-307HB-B-SU; LCSC C309361
J2: Conn_01x02; JST_PH_B2B-PH-K_1x02-P2.00mm_Vertical
L1: 22u; L_1210_3225Metric
R9, R10: 5k1; R_0402_1005Metric
R11, R12: 22; R_0402_1005Metric
R_CHG: 100k; R_0402_1005Metric
R_CS: 1k; R_0402_1005Metric
R_FB_H: 750k; R_0402_1005Metric
R_FB_L: 100k; R_0402_1005Metric
R_ILIM: 1k5; R_0402_1005Metric
R_ISET: 890; R_0402_1005Metric
R_PG: 100k; R_0402_1005Metric
R_TS: 10k; R_0402_1005Metric
R_VBAT_H: 1M; R_0402_1005Metric
R_VBAT_L: 1M; R_0402_1005Metric
R_VCC: 100; R_0402_1005Metric
U5, U6: AP2112K-3.3; SOT-23-5
U7: MT3608; SOT95P280X145-6N; PARTREV 1.0
U8: BQ24075RGTR; QFN50P300X300X100-17N; PARTREV M
U9: DW01A; SOT-23-6
U10: FS8205; SOT95P280X145-6N; PARTREV 1.9
U12: USBLC6-2SC6; SOT-23-6

Connections:
3V3_A: C_A2.1, U6.5 (VOUT)
3V3_D: C_D2.1, R_CHG.1, R_PG.1, U5.5 (VOUT)
5V: C_B2.1, D1.1 (K), R_FB_H.1
5V_USB: C_IN.1, J1.A4 (VBUS), J1.A9 (VBUS), J1.B4 (VBUS), J1.B9 (VBUS), U8.13 (IN), U12.5 (VBUS)
GND: C_A1.2, C_A2.2, C_B1.2, C_B2.2, C_BAT.2, C_D1.2, C_D2.2, C_IN.2, C_OUT.2, C_VBAT_SENSE.2, J1.25, J1.26, J1.27, J1.28, J1.A1 (GND), J1.A12 (GND), J1.B1 (GND), J1.B12 (GND), R9.2, R10.2, R_CS.2, R_FB_L.2, R_ILIM.2, R_ISET.2, R_TS.2, R_VBAT_L.1, U5.2 (GND), U6.2 (GND), U7.2 (GND), U8.4 (~CE), U8.6 (EN1), U8.8 (VSS), U8.14 (TMR), U8.15 (SYSOFF), U8.17 (EXP), U10.3, U12.2 (GND)
unnamed: C_U9.1, R_VCC.2, U9.5 (VCC)
unnamed: D1.2 (A), L1.2, U7.1 (SW)
unnamed: J1.A5 (CC1), R9.1
unnamed: J1.B5 (CC2), R10.1
unnamed: R_CHG.2, U8.9 (~CHG)
unnamed: R_CS.1, U9.2 (CS)
unnamed: R_FB_H.2, R_FB_L.1, U7.3 (FB)
unnamed: R_ILIM.1, U8.12 (ILIM)
unnamed: R_ISET.1, U8.16 (ISET)
unnamed: R_PG.2, U8.7 (~PGOOD)
unnamed: R_TS.1, U8.1 (TS)
unnamed: U10.2, U10.5
unnamed: U9.3 (OC), U10.4
unnamed: U9.1 (OD), U10.6
USB_DM: R11.2, U12.1 (I/O1), U12.6 (I/O1)
USB_DM_RAW: J1.A7 (DN1), J1.B7 (DN2), R11.1
USB_DP: R12.2, U12.3 (I/O2), U12.4 (I/O2)
USB_DP_RAW: J1.A6 (DP1), J1.B6 (DP2), R12.1
VBAT: C_BAT.1, J2.1, R_VBAT_H.1, R_VCC.1, U8.2 (BAT_2), U8.3 (BAT_3)
VBAT-: C_U9.2, J2.2, U9.6 (GND), U10.1
VBAT_SENSE: C_VBAT_SENSE.1, R_VBAT_H.2, R_VBAT_L.2
VSYS: C_A1.1, C_B1.1, C_D1.1, C_OUT.1, L1.1, U5.1 (VIN), U5.3 (EN), U6.1 (VIN), U6.3 (EN), U7.4 (EN), U7.5 (IN), U8.5 (EN2), U8.10 (OUT_10), U8.11 (OUT_11)
