GillesClerc/blackbox/docs/pcb/kicad-patches/connector.kicad_sch

## KiCad design docs/pcb/kicad-patches/connector.kicad_sch (2026-09-23)

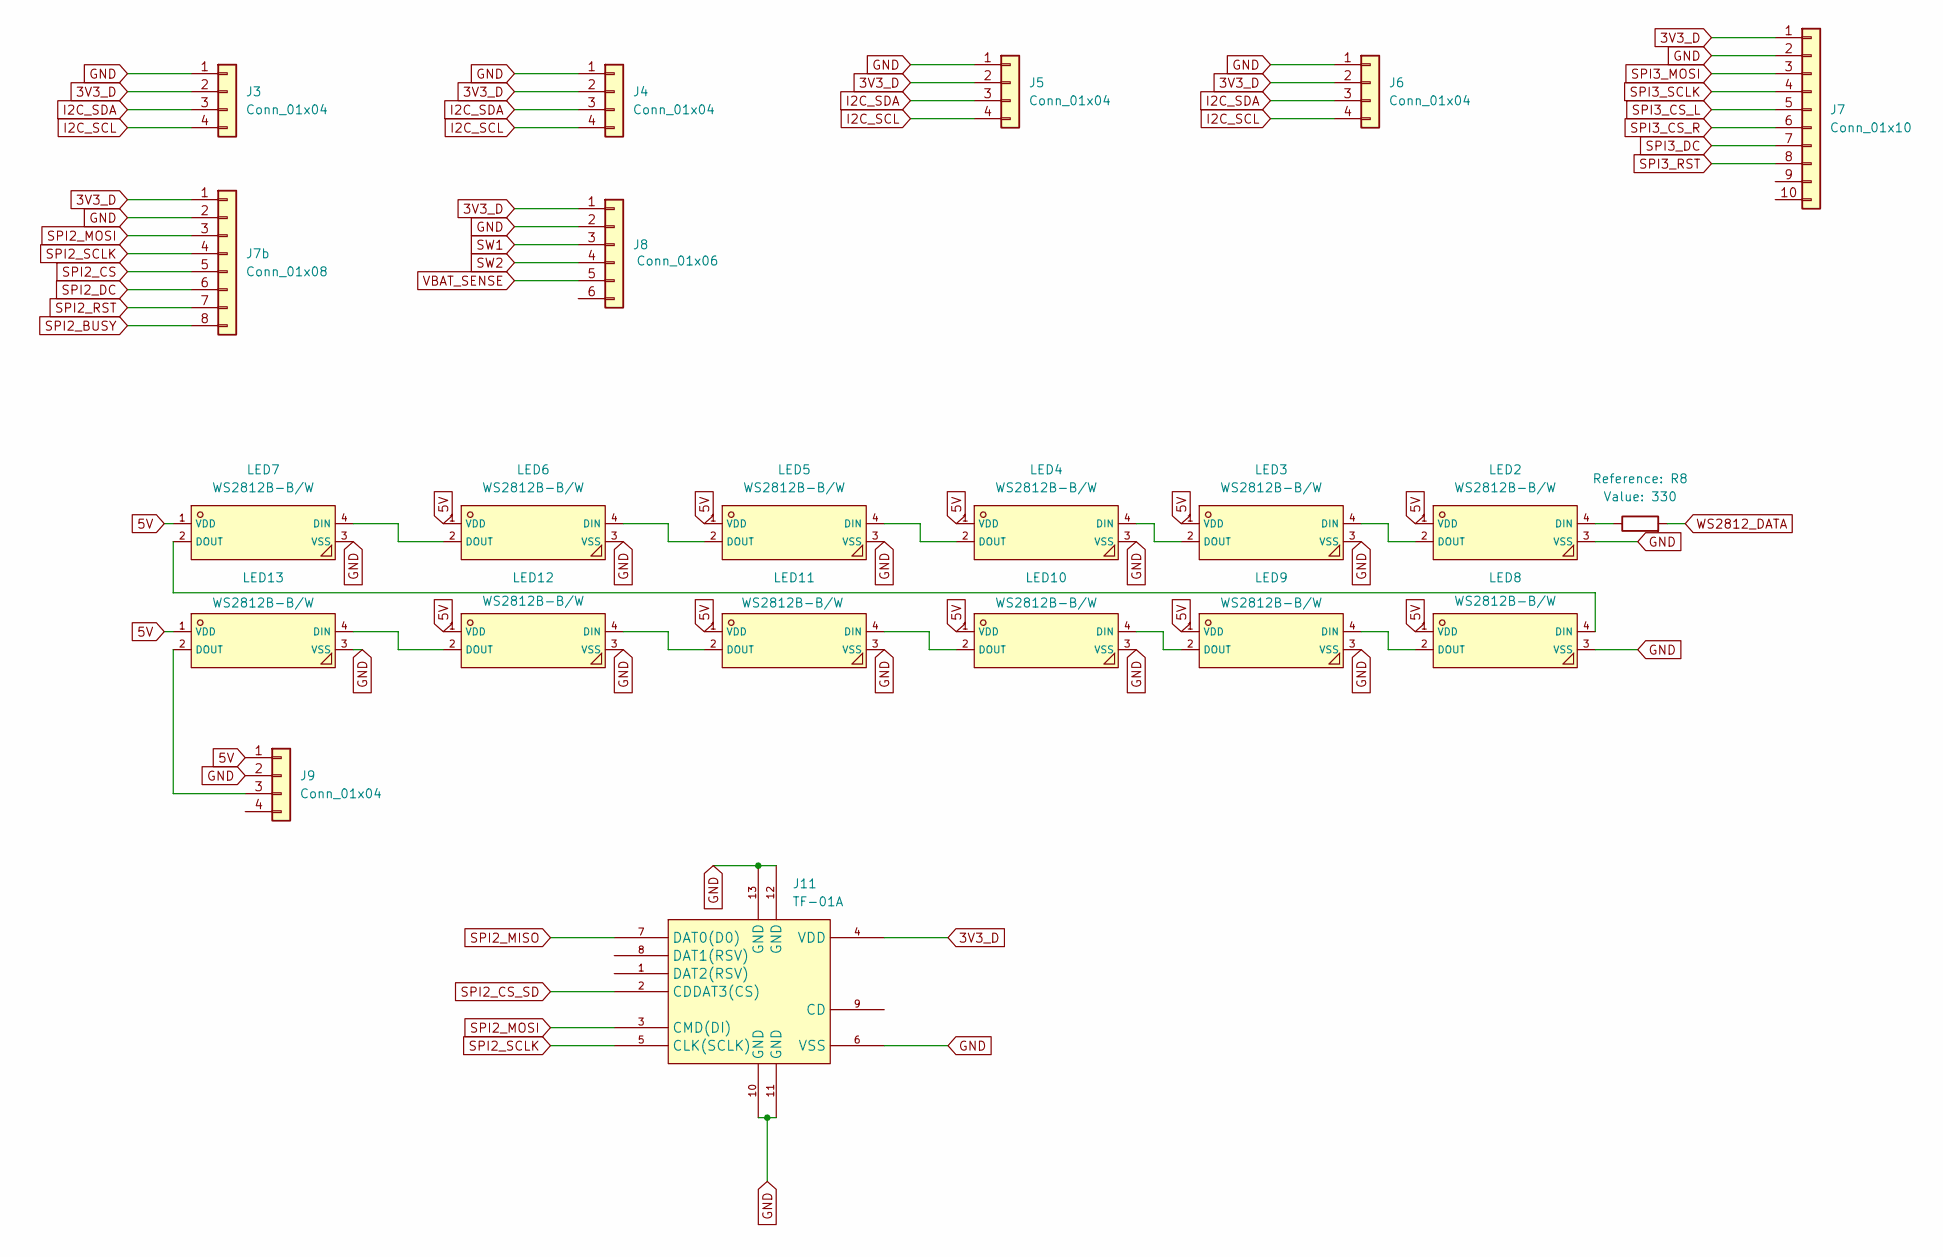
[picture p7: schematic connector.kicad_sch]

Parts:
J3, J4, J5, J6: Conn_01x04; JST_SH_BM04B-SRSS-TB_1x04-1MP_P1.00mm_Vertical
J7: Conn_01x10; JST_SH_BM10B-SRSS-TB_1x10-1MP_P1.00mm_Vertical
J7b: Conn_01x08; JST_SH_BM08B-SRSS-TB_1x08-1MP_P1.00mm_Vertical
J8: Conn_01x06; JST_SH_BM06B-SRSS-TB_1x06-1MP_P1.00mm_Vertical
J9: Conn_01x04; JST_PH_B4B-PH-K_1x04-P2.00mm_Vertical
J11: TF-01A; C91145_TF-SMD_TF-01A; LCSC C91145
LED2, LED3, LED4, LED5, LED6, LED7, LED8, LED9, LED10, LED11, LED12, LED13: WS2812B-B/W; C2761795_LED-SMD_4P-L5_0-W5_0-TL_WS2812B-B; LCSC C2761795
R8: 330; R_0402_1005Metric

Connections:
3V3_D: J3.2, J4.2, J5.2, J6.2, J7.1, J7b.1, J8.1, J11.4 (VDD)
5V: J9.1, LED2.1 (VDD), LED3.1 (VDD), LED4.1 (VDD), LED5.1 (VDD), LED6.1 (VDD), LED7.1 (VDD), LED8.1 (VDD), LED9.1 (VDD), LED10.1 (VDD), LED11.1 (VDD), LED12.1 (VDD), LED13.1 (VDD)
GND: J3.1, J4.1, J5.1, J6.1, J7.2, J7b.2, J8.2, J9.2, J11.6 (VSS), J11.10 (GND), J11.11 (GND), J11.12 (GND), J11.13 (GND), LED2.3 (VSS), LED3.3 (VSS), LED4.3 (VSS), LED5.3 (VSS), LED6.3 (VSS), LED7.3 (VSS), LED8.3 (VSS), LED9.3 (VSS), LED10.3 (VSS), LED11.3 (VSS), LED12.3 (VSS), LED13.3 (VSS)
I2C_SCL: J3.4, J4.4, J5.4, J6.4
I2C_SDA: J3.3, J4.3, J5.3, J6.3
unnamed: J9.3, LED13.2 (DOUT)
unnamed: LED2.2 (DOUT), LED3.4 (DIN)
unnamed: LED2.4 (DIN), R8.1
unnamed: LED3.2 (DOUT), LED4.4 (DIN)
unnamed: LED4.2 (DOUT), LED5.4 (DIN)
unnamed: LED5.2 (DOUT), LED6.4 (DIN)
unnamed: LED6.2 (DOUT), LED7.4 (DIN)
unnamed: LED7.2 (DOUT), LED8.4 (DIN)
unnamed: LED8.2 (DOUT), LED9.4 (DIN)
unnamed: LED10.2 (DOUT), LED11.4 (DIN)
unnamed: LED9.2 (DOUT), LED10.4 (DIN)
unnamed: LED11.2 (DOUT), LED12.4 (DIN)
unnamed: LED12.2 (DOUT), LED13.4 (DIN)
SPI2_BUSY: J7b.8
SPI2_CS: J7b.5
SPI2_CS_SD: J11.2 (CDDAT3(CS))
SPI2_DC: J7b.6
SPI2_MISO: J11.7 (DAT0(D0))
SPI2_MOSI: J7b.3, J11.3 (CMD(DI))
SPI2_RST: J7b.7
SPI2_SCLK: J7b.4, J11.5 (CLK(SCLK))
SPI3_CS_L: J7.5
SPI3_CS_R: J7.6
SPI3_DC: J7.7
SPI3_MOSI: J7.3
SPI3_RST: J7.8
SPI3_SCLK: J7.4
SW1: J8.3
SW2: J8.4
VBAT_SENSE: J8.5
WS2812_DATA: R8.2
