GillesClerc/blackbox/firmware/components/hal_i2c_bus/include/hal_i2c_bus_priv.h

// hal_i2c_bus_priv — réservé aux implémentations hal_* (jamais au code applicatif).
// Expose le handle du bus partagé et les helpers registre.
#pragma once
#include "esp_err.h"
#include "hal_i2c_bus.h"
#include "driver/i2c_master.h"

// Pins I2C partagées par tous les capteurs + audio DAC
#define I2C_BUS_SDA  21
#define I2C_BUS_SCL  17   // GPIO38=EYES_MOSI, GPIO42=EYES_RST, GPIO48=WS2812 — GPIO17 libre
#define I2C_BUS_FREQ 100000  // 100 kHz — stable sur breadboard (400kHz KO)

// Retourne le handle bus (singleton).
i2c_master_bus_handle_t hal_i2c_bus_handle(void);

// Helpers bas niveau pour les drivers de capteurs.
esp_err_t hal_i2c_bus_write_reg(i2c_master_dev_handle_t dev, uint8_t reg, uint8_t val);
esp_err_t hal_i2c_bus_read_reg(i2c_master_dev_handle_t dev, uint8_t reg, uint8_t *out);
esp_err_t hal_i2c_bus_read_regs(i2c_master_dev_handle_t dev, uint8_t reg, uint8_t *buf, size_t len);
