GillesClerc/blackbox/firmware/components/hal_light/include/hal_light.h

#pragma once
#include <stdint.h>
#include "esp_err.h"

// VEML7700 — capteur de lumière ambiante — Vishay
// Adresse I2C fixe : 0x10
#define VEML7700_ADDR  0x10

typedef struct {
    float lux;        // luminance calculée (lux)
    uint16_t als_raw; // valeur brute du canal ALS
    uint16_t white;   // valeur brute du canal white
} hal_light_data_t;

// Initialise et démarre les mesures (temps d'intégration 100ms).
esp_err_t hal_light_init(void);

// Lit la luminosité courante.
esp_err_t hal_light_read(hal_light_data_t *out);

// Retourne la luminosité en lux, ou -1.0 si erreur.
float hal_light_lux(void);
