GillesClerc/blackbox/(commit log)

2026-05-10 docs: migrate to ESP-IDF, fix filenames and docker setup
    - FSD: replace all Arduino/PlatformIO references with ESP-IDF v6.1
    - CLAUDE.md: fix doc filenames and GitHub remote URL
    - start.sh: fix SSH/gitconfig paths for dev user, use escapebox-dev image
    - Dockerfile: add to version control
2026-05-10 feat: display ST7735 validé + structure firmware Phase 1
    - Driver ST7735 1.8" SPI DMA 40MHz (flag SPI_DEVICE_NO_DUMMY requis en ESP-IDF v6)
    - Effet plasma animé (LUT sin, framebuffer complet, transaction DMA unique)
    - Structure composants firmware/ prête pour la suite (audio, nfc, servo, leds, scenario)
    - Docker : dev ajouté au groupe dialout, chmod 666 ttyUSB* au démarrage, mount ~/.claude
    - CLAUDE.md mis à jour avec statut Phase 1 et notes USB/SPI
2026-05-10 feat: moteur de scénario YAML/JSON — state machine Phase 1
    - scenario_engine : tâche FreeRTOS + xQueue pour les events capteurs
    - Parser JSON (cJSON bundlé) → navigation de steps par ID
    - Types de steps : narrative (auto-avance), trigger, input, end
    - Timeout par step configurable
    - Dispatch d'actions par callbacks enregistrés (display, audio, led, servo)
    - Simulateur d'events embarqué pour tester sans hardware
    - Scénario de test 5 steps : intro → rfid → keypad → servo → fin
    - Validé sur device : scénario complet de bout en bout dans les logs
2026-05-10 chore: gitignore artefacts IDF (managed_components, dependencies.lock, sample_project)
2026-05-10 docs: mise à jour CLAUDE.md — moteur scénario validé
2026-05-10 feat: boot screen animé — barre de progression, status cycling, titre pulse
    - Police bitmap 5x7 (ASCII 32-126) + display_draw_char/draw_string
    - Nouvelles couleurs : CYAN, ORANGE, GRAY, GOLD
    - Boot screen statique avec layout complet
    - Tâche FreeRTOS boot_anim : barre 0-100% en 5s, messages status
    (compiling, linking, caffeinating, hallucinating...), titre pulse gold→orange→jaune
2026-05-10 docs: remplacement MAX98357A par PCM5122PW + PAM8406 (audio stéréo)
    - Bus I2S0 : PCM5122PW (DAC stéréo, addr I2C 0x4C, MCLK interne)
    - PAM8406 : amplificateur Class D 5W+5W, purement analogique, pas de driver
    - Phase 1 checklist : 3 tâches audio (câblage, volume I2C, EQ DSP)
    - Troubleshooting §9 : 4 cas audio spécifiques PCM5122/PAM8406
    - §10.1 références : MAX98357A → PCM5122PW + PAM8406
    - MPR121 → MTCH2120 dans §10.1 (cohérence avec update précédent)
2026-05-10 feat: drivers audio/LEDs/capteurs + outil YAML→JSON
    Drivers firmware (code complet, validé à la compilation) :
    - audio/ : PCM5122PW I2S DAC + I2C config, tone generator sinusoïdal
    - leds/ : WS2812B via RMT 10MHz, buffer GRB, helper hex color
    - sensors/ : bus I2C master (singleton), LSM6DSOTR (IMU 6 axes),
    AS5600 (angle magnétique 12 bits), VEML7700 (lux),
    MTCH2120 (touch capacitif 12 canaux)
    Outil auteur (tools/yaml2json.py) :
    - Lit un scénario YAML, valide le format (types, actions, next, branch ops)
    - Génère le JSON firmware avec rapport d'erreurs clair
    Docs : remplacement MPU6050 → LSM6DSOTR dans FSD et CLAUDE.md
    (adresse I2C 0x6A, WHO_AM_I=0x6C, se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
2026-05-11 feat: drivers NFC/servo/SD + MPR121 touch proto
    - nfc/: driver PN532 I2C (SAMConfiguration, InListPassiveTarget, UID string)
    - servo/: driver SG90 MCPWM 50Hz, 2 servos GPIO1+2 (open/close/set_angle)
    - storage/: driver SD card SPI+FAT (mount, read, write, list)
    - sensors/: ajout MPR121 (breakout Phase 1) — même API que MTCH2120 (Phase 2 PCB)
    - CLAUDE.md + FSD mis à jour (statuts, tableau capteurs I2C Phase 1/2)
    - Build validé
2026-05-11 fix: NFC crash sur timeout + conventions code dans CLAUDE.md
    - nfc.c: remplace ESP_ERROR_CHECK par retour d'erreur explicite dans
    pn532_read_ack() et pn532_read_response() — évite abort() sur timeout
    légitime (ex. aucun tag présent)
    - CLAUDE.md: documente la règle ESP_ERROR_CHECK (init uniquement) et
    la contrainte GPIO servo (ESP32-S3 uniquement, pas le Lolin dev)
2026-05-11 docs: design cube 6 faces + mecanique revelation sans servo
    - CLAUDE.md: section boitier Phase 1 (cube 120mm, assignation 6 faces)
    - FSD 2.2.2b: assignation faces + mecanique revelation victoire sans servo Phase 1
    - Servo documente comme optionnel Phase 2 (hardware_required YAML)
2026-05-11 docs: CLAUDE.md — ajout sections Web Platform + Business, nettoyage mémoire
    Consolide dans CLAUDE.md (auto-chargé chaque session) les infos web et business
    qui n'étaient que dans les fichiers mémoire. Supprime project_docs.md et
    project_box_design.md (redondants avec CLAUDE.md). MEMORY.md réduit à 3 entrées.
2026-05-11 docs: mise à jour plan web — améliorations ultraplan (eslint flag, box-auth guard)
2026-05-14 feat: agents Claude Code — nextjs, backend, typescript, esp32, iot, embedded, security, project-validator
2026-05-14 docs: review multi-agents FSD — corrections firmware, sécurité, web platform, IoT
    - Hardware : adresse PN532 0x24→0x48, GPIO I2C dev/cible séparés, SPI3 GPIO43/44→GPIO47/46 (UART0 conflict)
    - Firmware : scenario_engine parse JSON (pas YAML), storage SPI+FAT, ESP-ADF external SDK, drivers écrits marqués [x]
    - Sécurité : HMAC GET /box/challenge (anti-replay), ECDSA P-256 spécifié, OTA signé ECDSA, JWT 2h, binding scénario par box, R2 Presigned URLs, BLE Secure Connections
    - API : ajout /box/challenge, /box/register, revoked_scenarios[], firmware.ecdsa_signature
    - Web : Route Groups App Router, routes manquantes (checkout, leaderboard /v/), webhook Stripe Phase 1, simulateur a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
2026-05-14 docs: FSD — processus création scénario détaillé (9 étapes)
    Vision/cadrage, direction artistique, cahier des charges narratif, design énigmes
    avec mapping hardware, spec YAML, production assets, intégration, playtest, itération.
    Phase 2 : référence au processus Phase 1 + contraintes diversification.
2026-05-14 docs: FSD — personas, proposition de valeur, budget/jalons, métriques go/no-go, feedback loop
    - §1.1 : personas A (famille) + B (escape fans), proposition de valeur, positionnement concurrentiel, B2C-only P1/P2
    - §3.0 : budget Phase 1 (500-2000 CHF), jalons M0-M3 avec dates (cible août-sept 2026), séquencement workstreams
    - §3.1 : validation renforcée — critères techniques + critères produit (WTP ≥ 100 CHF, NPS ≥ 7, 3 précommandes)
    - §3.1 scénario : roadmap contenu minimale (cadence, coût de production, décision scénariste externe)
    - §7.3.4 : micro-enquête post-partie sur page QR (3 questions, liées aux données session)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
2026-05-14 docs: refactor web guide + vision
    - web-platform-escapebox.md → web-implementation.md (guide opérationnel uniquement)
    Aligné sur FSD : box_uid (eFuse), JWT 2h + jti, challenge HMAC anti-replay,
    routes /v/[scenario]/[session], /box/register, arborescence Route Groups,
    schema SQL complet (device_scenarios, game_sessions), snippets TypeScript à jour
    - escapebox-vision.md : ton neutre, personas A/B, proposition de valeur,
    référence Lunii supprimée, B2B déplacé en Phase 3, FFF→Kickstarter ajouté
2026-05-14 docs: pin Next.js 16.2.6 LTS dans CLAUDE.md et web-implementation.md
2026-05-24 feat(display): driver ILI9488 4" SPI pour ESP32-S3, test screen couleurs + texte
2026-05-24 feat: test hardware I2C scan + audio + touch MPR121 → ILI9488
2026-05-24 fix: mpr121_read sans abort + résultats tests affichés sur ILI9488
    [main.c, mpr121.c]
2026-05-24 fix(i2c): 400kHz -> 100kHz stable sur breadboard
2026-05-24 hw: valider display ILI9488 + audio PCM5122 I2S + touch MPR121 sur ESP32-S3 DevKitC-1
    - ILI9488 4" : driver SPI 20MHz RGB666, grille touch affichée en temps réel
    - PCM5122 : mode hardware I2S (sans I2C), gamme Do majeur + fade-out silence anti-crunch
    - MPR121 : I2C sur SDA=21/SCL=17 (GPIO38=LED, GPIO42=JTAG exclus), adresse 0x5A
    - Fix critique : i2c_master_transmit prend des ms directs, pas pdMS_TO_TICKS()
    - Fix : mpr121_init retourne les erreurs I2C sans ESP_ERROR_CHECK sur les writes
    - LED RGB intégrée (GPIO38) éteinte au boot via leds_init
    [main.c, mpr121.c]
2026-05-24 feat: app scénario capitaine_verdier + harness test hardware
    main.c : moteur de scénario complet — JSON embarqué via EMBED_TXTFILES,
    handlers screen_main/secondary, led, audio (mapping play→tone), servo stub,
    set_var/incr_var. Tâche MPR121 : chiffres 0-9, backspace (pad 10), confirm
    (pad 11), hold 2s pour simuler rfid_read / rotary_value / accel_tilt.
    test.c : harness debug permanent — LED RGB cycle, barres couleur display,
    scan I2C, gamme audio, grille tactile interactive. Activer via CMakeLists.txt.
    CMakeLists.txt : +scenario +EMBED_TXTFILES capitaine_verdier.json, commentaire
    pour basculer sur test.c.
2026-05-24 fix: scenario handlers effacés par engine_init + maj FSD
    scenario_engine_init() reset s_handler_count=0 — les actions enregistrées
    avant l'init étaient silencieusement perdues, d'où l'écran figé sur
    "Chargement...". Corrigé : scenario_engine_init() en premier, puis register.
    Suppression des handlers set_var/incr_var en main.c (built-ins dans le moteur).
    FSD §3.1 : ILI9488 et MPR121 marqués validés, items test.c + main.c ajoutés.
    FSD §2.2.2 : note I2C corrigée (DevKitC-1, SCL=GPIO17).
    [main.c]
2026-05-24 feat: audio bg music, enveloppe anti-crissement, display fancy, scénario enrichi
    audio: mutex I2S + enveloppe ADSR (fade-in 5ms, fade-out 12ms) sur tous les
    tons — élimine les clics/crissements. Musique de fond sous-marine (tâche bg,
    prio 3) interruptible en <20ms par les sons foreground. audio_play_sequence()
    pour les arpèges multi-notes (correct, victoire, wrong).
    display: nouveau layout (header 30px + 3 zones séparées), typewriter 18ms/char,
    bordure colorée par étape (vert/bleu/or), hints effacés à chaque screen_main,
    action "flash" (LED + écran) pour la victoire.
    LED: brightness 32→80 (couleurs visibles sur tous les tons du scénario).
    scénario: textes narratifs enrich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
    [main.c]
2026-05-24 feat: minimp3 — playback MP3 ambient en boucle, détection automatique
    Composant minimp3 (single-header MIT, lieff/minimp3) ajouté comme composant
    natif ESP-IDF. audio_bg_mp3_start() : tâche FreeRTOS prio 3, décode frame par
    frame, boucle automatique, mono→stereo, volume 15 %, interruptible par les
    sons foreground via le même mutex I2S (latence max 20 ms).
    CMakeLists main : EMBED_FILES détecte automatiquement ambient.mp3 dans
    firmware/assets/audio/. Sans fichier → fallback tons synthétiques (weak
    symbols). Pas de rebuild si le fichier est absent.
    Pour activer : déposer firmware/assets/audio/ambient.mp3 (44100 Hz, mono ou
    stereo recommandé) puis rebuilder.
2026-05-24 fix: audio PCM5122 — config PLL I2C, filtre anti-artefact, flash 8MB
    - PCM5122 en mode I2C (MODE pins GND) : config PLL complète
    (BCK×16 = 45.16MHz, dividers DAC/NCP/DSP)
    - Filtre ringing-less low latency FIR (reg 0x2B=7)
    - Auto-mute désactivé (évite pops silence→audio)
    - Volume hardware -6dB + amplitudes numériques réduites
    - Flash 8MB avec partition custom (7.9MB app) pour gros MP3
    - I2C scan diagnostic au boot
    - Display: mutex SPI thread-safe
    - Scenario: xQueueReset entre steps
    - MP3 embed via #ifdef HAS_AMBIENT_MP3 (plus de weak symbol)
    - Stack bg_mp3_task portée à 24KB (minimp3 scratch ~16KB)
    [partitions.csv]
2026-05-28 feat: refonte UI LVGL complete + animations subtiles
    - Integration LVGL 9.2 : flush callback ILI9488 RGB565->RGB666 via SPI DMA
    - Refonte de toutes les etapes du scenario (header, progression, panneau
    principal, indices, barre de saisie) avec effet typewriter non bloquant
    - Polices Montserrat 14/16/20/28 activees dans sdkconfig
    - Animations : pulsation du dot actif, fondu d'apparition des indices,
    fondu en cascade du titre au boot
    - Manifeste idf_component.yml pour la dependance lvgl/lvgl
2026-05-28 fix: mutex LVGL recursif + gestion d'erreur du demarrage scenario
    - s_lv_mutex passe en mutex recursif : evite tout deadlock si un
    contexte imbrique plusieurs ui_lock
    - scenario_engine_start : erreur affichee a l'ecran au lieu d'un abort
    via ESP_ERROR_CHECK, coherent avec scenario_engine_init
    [main.c]
2026-05-28 fix(scenarios): pipeline YAML->JSON correct + docs alignees
    - yaml2json.py : desactive la resolution YAML 1.1 de on/off/yes/no en
    booleens (le DSL utilise 'on:' comme declencheur et 'off' comme mode LED).
    Avant, 'on:' devenait la cle True -> JSON casse, corrige a la main d'ou
    la derive YAML(1.0)/JSON(1.1). Ajoute l'action 'flash' au schema.
    - Scenario regenere : YAML redevient source de verite (v1.1), JSON =
    artefact genere byte-stable (round-trip verifie).
    - FSD : audio = minimp3 (ESP-ADF reporte Phase 2+), note JSON artefact.
    - Plan web : middleware -> proxy.ts (Next 16, runtime nodejs), garde de
    routes corrige (route groups ne creent pas de segment URL), auth par-box
    derivee d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
    [yaml2json.py]
2026-05-28 docs: aligner web sur l'artefact JSON + slug capitaine_verdier, marquer DSL cible FSD
    - web: scénario servi en JSON généré (suppression js-yaml, yaml_path → scenario_path)
    - slug et titre alignés sur le firmware (capitaine_verdier / "Le Mystère...")
    - box-auth: jwtSecret dérivé du master (corrige secret indéfini), commentaire proxy.ts
    - FSD: note signalant les constructions DSL pas encore implémentées (exemple = cible)
2026-05-30 docs: spec menu on-device (tactile LVGL), mode test capteurs, modèle sync pull
    - FSD §6.4 réécrit : accueil/sélection scénario, Réglages (volume, luminosité,
    langue, reconfig WiFi, diagnostic réseau, infos box, reset usine)
    - Mode dev déverrouillé par 7× tap version firmware (flag NVS) → Mode Test :
    dashboard live capteurs/actionneurs pour debug hardware
    - Sync auto au boot non bloquante + manuelle, fallback offline
    - Note vocabulaire §2.1 : proxy.ts Next (web) vs couche sync device-to-cloud (box)
    - web: device_scenarios documenté comme modèle pull servi par /api/box/sync
    - backlog Phase 2 firmware mis à jour
2026-05-31 feat: paysage 480x320, tactile XPT2046, menu on-device, audio PCM5122 corrige
    - Display: portrait→paysage (MADCTL 0x28), MISO active pour SPI partage
    - XPT2046: driver tactile resistif avec calibration, PENIRQ, LVGL indev
    - UI Manager: ecrans boot/menu/game/settings/test en LVGL 9, animations
    - Config Manager: persistance NVS (volume, brightness, dev_mode)
    - Audio PCM5122: volume digital corrige (0x30=0dB, 0xFF=mute), gain
    analogique page 1 reg 0x02, filtre DSP avec standby, VU-metre temps reel
    - MP3 BG volume: 8%→50%, auto-mute desactive (reg 0x41/0x42)
    - Test mode: slider volume, selecteur filtre DSP, gain analogique
    - main.c refactorise: UI deplacee dans ui_manager, menu avec lancem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
    [main.c]
2026-05-31 docs: schemas PCB complets + FSD hardware corrige
    FSD section 2.2 reecrite : GPIO corriges (SPI2=GPIO8-15), composants
    Phase 1 confirmes (drop servos/laser/AS5600), alimentation 2x LDO,
    architecture Main+Satellites, table GPIO WROOM-1-N16R8 complete.
    7 schemas detailles : bloc systeme, ESP32 core, ecrans SPI, capteurs
    I2C, LEDs/potards/boutons, micro MEMS, alimentation audio.
2026-05-31 docs: BOM LCSC + netlist + workflow Fusion 360 pour PCB
    BOM avec numeros LCSC pour PCBA JLCPCB (main board), netlist
    complete structuree par bus (I2C/I2S/SPI/ADC/GPIO), guide
    workflow Fusion 360 Electronics avec librairies et export.
    [02-bom-lcsc.csv]
2026-05-31 docs: remplacement TP4056 par bq24075 (TI, power path DPPM)
    Architecture alim revisee : USB → bq24075 → VSYS → regulateurs.
    Power path permet alimentation systeme sur USB sans user la batterie.
    DW01A+FS8205 conserves pour protection sur-decharge.
    AP2112K et MT3608 valides et conserves.
    Toutes references TP4056 supprimees dans 8 fichiers.
    [02-bom-lcsc.csv]
2026-05-31 docs: LSM6DSOXTR (MLC), TMAG5273 Hall I2C, USBLC6-2SC6 ESD
    - LSM6DSOTR → LSM6DSOXTR : meme footprint, ajoute Machine Learning Core
    - A3144E (digital) → TMAG5273 (lineaire 3D I2C) : mesure distance/angle
    aimant, libere GPIO47. Adresse I2C 0x35 sur bus satellite capteurs.
    - Ajout USBLC6-2SC6 protection ESD sur USB D+/D- (C7519, ~0.06$)
    [02-bom-lcsc.csv]
2026-05-31 feat: refonte display (2x GC9A01 yeux + SSD1680 e-ink bouche), scenario Le Reveil, pinout power verifie
    - Remplacement ILI9488 4" + XPT2046 par 2x GC9A01 ronds (yeux) + SSD1680 e-ink 2.9" (bouche)
    - SPI2 = e-ink bouche, SPI3 = 2x GC9A01 (CS partage GPIO40 + GPIO14)
    - GPIO14 recycle (ex-XPT2046 CS), GPIO15 libere
    - Scenario 01-le-reveil.md : personnage grognon, voix Animal Crossing, gag "Machin"
    - Pinout alimentation verifie contre datasheets officiels :
    AP2112K pin 1=VIN/2=GND (etait inverse), FS8205A drain=pin1+8 (pas 7+8),
    DW01A GND=midpoint MOSFETs, bq24075 EN2=L/EN1=H pour 500mA, ISET ajoute
    - BOM: inductance 22uH, R_ISET/R_VCC/R_FB ajoutees, C_BAT/C_OUT ajoutees
    - Netlist: nets bq24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
    [02-bom-lcsc.csv]
2026-06-01 fix(docs): PCM5122 TSSOP-28, C_IN bq24075 4.7uF, C25 16V, flux DW01A clarifie
    Corrections verifiees contre datasheets officiels :
    - BOM: PCM5122 footprint TSSOP-20 → TSSOP-28 (erreur critique)
    - bq24075 C_IN: 1uF → 4.7uF (minimum datasheet SLUS810N)
    - MT3608 C_B2: 10V → 16V (derating DC bias X5R a 5V)
    - EN config: EN2=L/EN1=H (pas EN1=H/EN2=H qui est Standby)
    - Inductance: 4.7uH → 22uH (recommande pour 3.7V→5V)
    - DW01A/FS8205: supprime prose contradictoire, flux courant clarifie
    - R_IL comment precise (RILIM mode EN2=H/EN1=L)
    [02-bom-lcsc.csv]
2026-06-01 feat(docs): schéma SVG pin-à-pin alimentation complète
2026-06-01 feat(docs): schéma électronique SVG style standard (symboles + pin numbers + net labels)
2026-06-04 feat(display): yeux GC9A01 animes (port Uncanny Eyes)
    - pipeline Adafruit Uncanny Eyes porte sur esp_lcd_gc9a01 (assets MIT)
    - ui_face : facade emotion/regard pour pilotage scenario
    - rendu full-frame DMA 32 KiB (1 draw_bitmap/frame, evite races buffer DMA)
    - desactivation CS_R=14 en Phase 1 (un seul ecran cable, evite blocage
    spi_device_get_trans_result sur CS flottant)
    - fix main.c : WS2812 sur GPIO48 (etait sur GPIO38 = MOSI yeux)
    - suppression composants obsoletes ILI9488/ST7735/XPT2046/ui_manager
    [eyes_anim.c, eyes_anim.h, main.c, ui_face.c, ui_face.h]
2026-06-04 feat(display): activation du deuxieme oeil GC9A01 (CS_R=14)
    - panel_setup pour EYE_RIGHT reactive (ecran droit cable physiquement)
    - framebuffer DMA par oeil (32 KiB chacun, 64 KiB total) : evite la race
    entre CPU et DMA quand on alterne les ecritures vers les 2 panels
    - vTaskDelay(20ms) apres draw_bitmap pour laisser le DMA finir (HACK ;
    a remplacer par on_color_trans_done callback + semaphore proprement)
    - resultat mesure : ~16 fps par oeil, animation Uncanny Eyes fluide sur
    les deux ecrans
2026-06-04 refactor(display): on_color_trans_done callback + semaphore par oeil
    Remplace le vTaskDelay(20ms) hack par la synchronisation propre via
    callback ISR (xSemaphoreGiveFromISR) + eyes_wait_done(eye) cote caller.
    Pattern conforme a l'exemple Espressif test_esp_lcd_gc9a01 :
    draw_bitmap (async) -> eyes_wait_done (bloque sur ISR signal)
    Le CPU est libere pendant le DMA donc le scheduler peut faire tourner
    d'autres tasks, vs le vTaskDelay qui imposait une latence fixe.
    API publique : eyes_wait_done(eye_id_t) ajoutee dans eyes.h.
    [eyes_anim.c]
2026-06-04 fix: applique fixes audit embedded-systems (criticals + majors + minors)
    Fixes audit embedded-systems sur audio, mpr121, eyes, ui_face, leds, scenario.
    Critiques
    - audio: s_tone_buf statique alloue dans audio_init (plus de malloc en chemin chaud)
    - audio: bg_mp3_task stack 24576 -> 32768
    - audio: audio_play_raw prend s_mutex avant disable/reconfig I2S (race condition)
    - mpr121: ESP_ERROR_CHECK -> check explicite + return ret (appel runtime)
    Majeurs
    - ui_face: portMAX_DELAY -> pdMS_TO_TICKS(200) + compteur timeouts
    - eyes_anim: stack eye_task 6144 -> 8192
    - audio: s_fg_play volatile -> atomic_bool (C11)
    - eyes_anim: frame() mono-contexte explicite
    - scenario: xQueueReset retire (preserve le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
    [eyes_anim.c, main.c, mpr121.c, ui_face.c]
2026-06-04 fix(concurrency): elimine le freeze ~500ms perceptible sur l'animation yeux
    4 fixes identifies par audit concurrence ciblé.
    Fix#1 — action_flash deporte dans une task dediee
    Le flash LED (4 iterations × 180ms = 720ms bloquants) tournait dans le callback
    scenario_engine (prio 5 non-pinned), qui pouvait migrer sur core 1 et preempter
    eye_task (prio 4). On poste maintenant un flash_cmd_t dans une queue, consomme
    par flash_task pinned core 0 prio 3.
    Fix#2 — eyes_fill drain par counting semaphore au lieu de while+timeout
    Le drain par timeout etait sujet a race : une transaction encore en vol au
    moment du drain firait son ISR APRES, laissant un give parasite qui decalait
    la wait_done suiva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
    [main.c]
2026-06-09 docs: corrige les incoherences FSD/vision et structure le plan web en phases
    - FSD : WS2812 GPIO48, MPR121 dans la table I2C, partitions reelles
    (factory 7.9MB) + cible OTA Phase 2, commande flash esptool,
    esp_https_ota au lieu d'espota.py, URL API box.agill.es/api/box
    - FSD 6.4 : menu on-device reecrit en modele boutons physiques + visage
    (touches capacitives, annonces vocales, NFC = raccourci, volume pot)
    - FSD/vision : taille cube notee comme non tranchee (a valider au proto)
    - Plan web : decoupage en phases 0-5, SQL micro-enquete game_sessions,
    arborescence Next.js 16 (proxy.ts, route groups), purge box_challenges
2026-06-09 fix(firmware): applique les 14 findings de l'audit (5 critical, 4 major, 5 minor)
    CRITICAL
    - audio: timeout i2s_channel_write dimensionne sur la duree du buffer (+1s)
    - sensors (lsm6/veml/as5600/mtch2120): plus d'ESP_ERROR_CHECK en runtime,
    verification explicite + ESP_LOGW + return (un glitch I2C ne reboote plus)
    MAJOR
    - storage: SD deplacee sur SPI2_HOST pins FSPI natifs (CS=10 MOSI=11 CLK=12
    MISO=13) — l'ancien cablage conflictait avec SPI3 yeux, GPIO14 et USB D-
    - audio: s_bg_run/s_bg_exited en atomic_bool, fin de tache signalee par flag
    (supprime le TOCTOU eTaskGetState dans audio_bg_stop)
    - main: flash_task portMAX_DELAY -> pdMS_TO_TICKS(500)
    MINOR
    - i2c_bus: commentaire GPIO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
    [eyes_anim.c, main.c, mtch2120.c, ui_face.c]
2026-06-10 docs(datasheets): ajoute syntheses LSM6DSOXTR + VEML7700 et composants face avant au BOM
    - PDF officiels + syntheses markdown (pinout, registres, init) via /component-research
    - BOM : faders Bourns PTA6043, pots PDB181, toggles E-Switch 100SP
    - CLAUDE.md : reference le workflow docs/datasheets/
    [02-bom-lcsc.csv]
2026-06-10 docs(fsd): aligne la table de partitions OTA cible sur le skill esp32-escapebox-expert
    - Phase 2 : nvs + otadata + nvs_keys + factory 3MB (image de secours) + ota_0/ota_1 3MB + LittleFS 6.9MB
    - Note migration FW-04 : 16MB, rollback gated par self-test boot, assets MP3 vers LittleFS
2026-06-10 refactor(firmware): supprime servo/ et as5600 (composants retires du Phase 1)
    - FSD §2.2.2 : AS5600/SG90/laser remplaces par pots ADC + interactions software
    - action_servo conservee en stub (scenarios Phase 2)
    - verifie sur cible : boot propre, yeux + audio + scenario OK
2026-06-10 refactor(hal): opacifie les headers publics — les handles I2C ne fuient plus
    - les _init() capteurs/audio/nfc ne prennent plus de bus handle (i2c_bus_handle() interne)
    - driver/i2c_master.h retire de tous les headers publics sauf i2c_bus.h (bus owner)
    - deps driver passees en PRIV_REQUIRES (audio, nfc, leds, storage, sensors)
    - STORAGE_SPI_HOST deplace dans storage.c
    - verifie sur cible : boot propre, audio PLL locked, MPR121 OK, scenario actif
2026-06-10 refactor(hal): renomme les composants en hal_* et eclate sensors/
    - sensors/ eclate en hal_i2c_bus (public/priv split), hal_imu, hal_light,
    hal_touch (facade MTCH2120/MPR121 selectionnee par probe I2C)
    - audio/display/leds/nfc/storage renommes hal_audio/hal_display/hal_leds/
    hal_nfc/hal_storage, prefixes de fonctions alignes
    - hal_display : esp_lcd entierement encapsule, nouvelle API opaque
    hal_display_draw_eye() (blit bloquant), eyes_panel() supprime
    - ui_manager ne depend plus d'esp_lcd ; main.c migre sur les API hal_*
    - fixes au passage : mtch2120_init sans ESP_ERROR_CHECK (runtime-safe),
    scl_speed_hz 400k -> I2C_BUS_FREQ (100 kHz breadboard)
    Verifie sur cible : boot propre, yeux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
    [eyes_anim.c, eyes_anim.h, hal_audio.c, hal_audio.h, hal_display.c, hal_display.h, hal_i2c_bus.c, hal_i2c_bus.h]
2026-06-11 fix(pcb): applique l'audit de coherence — bq24075 TS/EN, SD sur SPI2, MLX -BAA
    - bq24075 : TS = 10k fixe vers GND (datasheet SLUS810N §9.3.6, le diviseur
    10k/10k vers VSYS risquait de suspendre la charge silencieusement) ;
    EN2=H/EN1=L = mode RILIM ~1.07A (coherent avec I_CHG=1A via R_ISET=890R)
    - ajoute docs/datasheets/bq24075.pdf + synthese bq24075.md (53 pages lues)
    - microSD J11 sur SPI2 partage : MISO=15, CS=47 (netlist, BOM, hal_storage.h)
    - MLX90614 : variante ESF-BAA 3V (AAA=5V incompatible), adresse 0x5A->0x5C
    - PN532 : adresse harmonisee 0x24 (7 bits) dans FSD et schema 03
    - LSM6DSOXTR : ref LCSC corrigee C481766 (verifiee en ligne)
    - netlist MT3608 : nets BOOST_SW/BOOST_FB,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
    [02-bom-lcsc.csv]
2026-06-11 feat(pcb): ADS7830 sur face avant — 8 controles analogiques en I2C, GPIO1-3 liberes
    Les 4 faders SL1-SL4 et 4 pots RV1-RV4 sont numerises par un ADS7830
    (I2C 0x48, ratiometrique REFIN=3V3) directement sur le PCB face avant,
    au lieu de tirer 3 signaux analogiques vers l'ADC ESP32. GPIO1/2
    re-affectes aux toggles SW1/SW2 (J8 re-cable), GPIO3 en reserve.
    Datasheet synthese + PDF ajoutes (component-research).
    [02-bom-lcsc.csv]
2026-06-12 fix(pcb): applique les mineurs de l'audit — designateurs, R7, PGOOD/CHG, J9, LEDS_DEFAULT_GPIO
    - LEDS_DEFAULT_GPIO 16 -> 48 (16 = I2S1 SCK micro, vrai pin WS2812 = 48)
    - Harmonisation designateurs netlist/BOM/schemas : C_D1/C_D2/C_A1/C_A2/
    C_B1/C_B2/C_IN canoniques, R_IL -> R_ILIM, table locale du schema 06
    alignee sur le BOM global, R5 (pull-up XSMT) deplace sur 3V3_A
    - R7 reaffecte : pull-up RSTPD PN532 (ex-Hall A3144E retire)
    - R_PG/R_CHG 100k ajoutes (pull-up debug PGOOD/CHG, DNP par defaut)
    - J9 passe en JST-PH 2mm (32 LEDs WS2812 = ~1.9A sur 5V, JST-SH insuffisant)
    [02-bom-lcsc.csv]
2026-06-12 feat(storage): partitions OTA 16MB + scenario et MP3 charges depuis la carte SD
    - partitions.csv : nvs+otadata+nvs_keys+factory/ota_0/ota_1 (3MB) + storage littlefs 6.9MB
    - sdkconfig : flash 16MB, rollback bootloader active
    - main.c : montage SD optionnel au boot, scan /sdcard/scenarios/, chargement
    scenario.json en PSRAM avec fallback embarque, ambient.mp3 depuis le dossier
    du scenario actif avec fallback MP3 embarque puis tons synthetiques
    [partitions.csv]
2026-06-12 fix(psram): active la PSRAM octal 8MB (jamais activee) + listing SD debug au boot
    - CONFIG_SPIRAM=y mode octal 80MHz : les allocs MALLOC_CAP_SPIRAM
    (scenario SD, buffer MP3 hal_audio_play_bg) echouaient silencieusement
    - main.c : liste le contenu de /sdcard au boot et logue le dossier quand
    scenario.json est introuvable (diagnostic bench)
    Valide sur cible : scenario.json et ambient.mp3 charges depuis la SD,
    fallback embarque sans carte, PSRAM 8MB au heap.
    [main.c]
2026-06-12 feat(web): Phase 1 — landing « Ouvrez l'œil » + waitlist (Next.js 16 + shadcn)
    - scaffold create-next-app 16.2.6 (TS, Tailwind, App Router) dans web/
    - direction design : nuit d'atelier / iris ambre, Unbounded + Public Sans + Space Mono
    - box-face : yeux animés (regard en amande, suivi curseur, saccades, clins d'œil),
    bouche e-ink qui tape le tagline, perspective 3D, prefers-reduced-motion
    - sections : comment ça joue, 8 sens + carte mystère, scénario Capitaine Verdier
    - waitlist : server action zod + Supabase (insert idempotent), formulaire hero + footer
    - lib/supabase client+server (snippets du plan)
    - start.sh : publie le port 3000 pour le dev server
2026-06-12 docs: FSD + CLAUDE.md a jour — partitions OTA 16MB/PSRAM/SD valides, Phase 1 web livree (landing + waitlist sur Coolify)
2026-06-12 feat(web): auth email/password — login, register, compte, proxy de session
    - proxy.ts (ex-middleware, runtime nodejs) : refresh session Supabase + redirect
    /login sur les routes protégées (préfixes réels du route group (app))
    - server actions signUp/signIn/signOut (zod, messages FR, signup direct sans
    confirmation e-mail — pas de SMTP pour l'instant)
    - pages /login et /register (direction « Ouvrez l'œil », carte sombre, labels mono)
    - shell authentifié (app)/layout.tsx + page /account (e-mail, membre depuis,
    placeholder box/scénarios/scores)
2026-06-14 feat(web): visage plus vivant — paupières naturelles + yeux/bouche cliquables
    - paupières moins arrondies et dérive lente « respiration » au repos
    - clic sur un œil : sursaut (clin) + dilatation des pupilles
    - clic sur la bouche : réplique mystérieuse tapée à l'écran e-ink, retour au tagline
    - retire le sens « souffle » de la landing (moins en dévoiler)
2026-06-14 refactor(web): détecte prefers-reduced-motion via useSyncExternalStore
    Supprime le setState synchrone dans un effet (avis react-hooks/set-state-in-effect) :
    reduced est désormais une valeur dérivée, plus de flash ni de risque de mismatch
    d'hydratation.
2026-06-14 feat(web): API box challenge/auth/register/sync (HMAC HKDF + JWT 2h)
    Authentification box sans secret embarque : secret par box derive du
    BOX_MASTER_SECRET serveur (HKDF), preuve par HMAC sur nonce anti-replay,
    puis JWT box 2h. Register en option A (claim simple, max 3 box). Sync pull :
    scenarios installes + bloc OTA firmware si release plus recente. Lecture des
    secrets paresseuse pour ne pas casser next build. Script tools/test_box_api.py
    pour simuler la box.
2026-06-20 feat(wifi): hal_wifi STA + smoke-test HTTPS valide sur cible
    - hal_wifi : connexion STA, creds en NVS (wifi_creds), event group + retry, API opaque
    - provision_box.py : flags --wifi-ssid/--wifi-pass (meme image NVS que box_creds)
    - main : connexion + smoke-test HTTPS (esp_crt_bundle) dans une tache dediee core 0
    (pile 8 KB pour le handshake TLS, evite le stack overflow de main_task)
    - tools/read_logs.py : reset + capture serie one-shot depuis le container
    - FSD : hal_wifi valide, box_sync = prochaine etape
    [hal_wifi.c, hal_wifi.h, main.c, provision_box.py, read_logs.py]
2026-07-02 feat(cloud): composant cloud_client — auth challenge/HMAC → JWT + sync, validé sur cible
    Jalon F1 du plan firmware-cloud-client : task core 0 prio 3, esp_http_client
    + crt bundle, cJSON, JWT en RAM (ré-auth à 110 min ou sur 401), horloge réglée
    depuis server_time, API URL via Kconfig (surcharge NVS cloud/api_url).
    Remplace le smoke-test HTTPS de main.c. PROJECT_VER=0.1.0 rapporté au sync.
2026-07-02 docs: CLAUDE.md — flux box↔cloud F1 valide sur cible
2026-07-02 feat(cloud): F2 — scénarios téléchargés sur SD au sync, validé sur cible
    Streaming HTTPS vers /sdcard/scenarios/<slug>/scenario.json (.tmp + rename,
    plafond 256 Ko, slug assaini) + manifest.json réécrit à chaque sync (skip si
    présent au manifest ET fichier existant — self-healing). Dette notée dans
    CLAUDE.md : artefacts servis en statique public, à protéger avant Stripe.
    [cloud_client.c]
2026-07-02 docs: CLAUDE.md — F2 valide (scenarios SD + manifest)
2026-07-02 docs: plan firmware v2 — packages d'assets (F3) + mixer audio (F4), scores optionnels
2026-07-02 docs: plan F3 en deux temps — F3.2 solde la dette de livraison statique (route pkg JWT)
2026-07-02 feat(cloud): F3 — packages d'assets versionnés + livraison contrôlée
    - tools/package_scenario.py : manifest généré (version, sha256/taille par fichier)
    - web/scenario-packages/ hors de public/ ; route GET /api/box/pkg/[slug]/[...path]
    (JWT box + droit device_scenarios + path assaini + streaming)
    - sync renvoie package_path + version
    - firmware : install incrémentale (skip par version puis par taille+sha256,
    reprise après coupure), sha256 PSA au fil de l'eau, Bearer sur les downloads
    avec ré-auth sur 401, vérif espace SD, orphelins conservés, migration F2
    [cloud_client.c, package_scenario.py]
2026-07-02 docs: F3 valide sur cible — dette livraison statique soldee
2026-07-03 chore(scenarios): capitaine_verdier v3 — asset audio/intro_ambient.mp3 (test one-shot F4)
2026-07-03 feat(audio): F4 — mixer logiciel 4 voix, one-shot MP3 des scénarios
    Une seule task audio_mixer écrit l'I2S : bg MP3 (boucle, ducking auto pendant
    un one-shot), one-shot MP3 (assets audio/<nom>.mp3 des packages, résolus par
    "play" avec fallback tons builtin), bips fg (queue asynchrone — ne bloquent
    plus l'appelant ni la musique), ambiance tons fallback. Somme 32 bits saturée,
    buffers PSRAM alloués au boot. Remplace les tasks audio_bg/audio_bg_mp3 et le
    mutex I2S ; hal_audio_play_raw supprimé (aucun appelant).
2026-07-03 docs: F4 mixer valide sur cible (logs) — qualite a confirmer a l'oreille
2026-07-03 chore(scenarios): capitaine_verdier v4 — sinus 3 notes comme asset de test one-shot
2026-07-03 fix(audio): mixer prio 3→4 + DMA 130 ms — underruns au boot (TLS/sha256 de cloud_client à prio égale affamait le mixer)
    [hal_audio.c]
2026-07-03 feat(audio): buffers mixer en RAM interne + sentinelle temps réel
    Diag craquements proto : production mesurée en temps réel exact (5000 ms
    audio en ~4995 ms), sortie du mixer vérifiée identique à la référence sur
    banc host (gcc + minimp3), A/B avec l'ancien pipeline identique à l'oreille
    → les craquements viennent du câblage breadboard (dupont/alim), pas de F4.
    La sentinelle ne logge que si la production décroche (>5,3 s ou chunk >100 ms).
2026-07-03 docs: F4 valide — craquements imputes au cablage breadboard (A/B + banc host)
2026-07-04 feat(ble): F5 — provisioning BLE (ble_prov NimBLE) + register option B + page /devices/add
    Firmware : service GATT e5c40001-… (box_uid, wifi_ssid/pass write-only, status
    notify, challenge→HMAC preuve de possession), fenêtre 5 min fermée proprement
    (nimble_port_deinit), déclencheurs : boot sans wifi_creds ou touche maintenue.
    hal_wifi_set_credentials (NVS + reconfig sans reboot). Allocations WiFi/LWIP,
    mbedTLS et NimBLE en PSRAM (la RAM interne ne suffisait plus au TLS avec BT).
    Web : /devices/add (Web Bluetooth) ; register exige challenge+HMAC (option B,
    dette squat d'UID soldée).
    [ble_prov.c, ble_prov.h, hal_audio.c, hal_wifi.c, hal_wifi.h, main.c]
2026-07-04 fix(ble): coexistence BLE+WiFi — stack mixer en PSRAM, BLE_MAX_ACT=3
    121 Ko internes libres avant réseau : advertising + TLS/sync simultanés
    validés sur cible, fenêtre fermée proprement (BLE deinit rend ~50 Ko).
    [hal_audio.c]
2026-07-04 docs: F5 code fait — dette option A soldee, reste le parcours E2E navigateur
2026-07-04 feat(menu): menu de boot boutons+visage + page /devices
    Firmware : invite 4 s au boot (double bip + LEDs), menu au keypad ◀=4 ▶=6 ✓=#
    — items JOUER / SCÉNARIO (cycle + NVS cloud/active_scenario, respecté par le
    chargeur) / APPAIRAGE BLE (fenêtre 5 min). Annonces par yeux+LEDs+bips (e-ink
    et voix viendront). Remplace le déclencheur touche-au-boot, invisible à cause
    de la calibration MPR121 (le doigt posé pendant le boot devient la référence).
    Web : nav MES BOX + page /devices (liste des box du compte, RLS).
2026-07-04 docs: menu de boot v1 note au plan
2026-09-11 chore(docker): persiste l'install Claude Code native entre les runs
    ~/.local est monte depuis l'hote pour survivre aux mises a jour, mais
    vide au premier lancement -> masque l'install faite au build de l'image.
    On seed /opt/claude-local-seed au build et on le recopie sans ecraser au
    premier demarrage si le montage est vide.
2026-09-11 fix(pcb): pins PCM5122 corriges + BOM reformate pour Pinscope
    Netlist : tous les numeros de pins PCM5122 etaient faux (verifie contre
    la datasheet TI SLAS763C) sauf OUTL/OUTR par coincidence - corrige les
    13 pins concernees (SDA/SCL/XSMT/LDOO/CAPP/CAPM/VNEG/AVDD/DVDD/CPVDD/
    BCK/LRCK/DIN). Ajoute la NET SAT_GND manquante et des notes sur les
    gaps trouves (alimentation PN532, pins MTCH2120/TMAG5273/MLX90614
    desormais confirmes contre datasheet).
    BOM : reformate pour Pinscope - designateurs eclates (C1,C2,... au lieu
    de C1-C12), colonne MPN separee du Value generique pour les passifs.
    [02-bom-lcsc.csv]
2026-09-20 docs(pcb): filtre PCM5122 TI, e-ink bouche retire (display TBD), PN532->ST25DV
    - PCM5122 mode I2C corrige dans le FSD (MODE1/MODE2), filtre sortie
    aligne sur la reco datasheet TI (470R/2.2nF au lieu de 100R/22nF)
    - Ecran bouche SSD1680 e-ink retire de partout (composant abandonne),
    remplace par "display bouche, type a definir ulterieurement"
    - PN532 (EOL chez NXP) remplace par ST25DV04KC-IE6S3 : use case lecture
    de badge externe abandonne, seul le role tag (telephone -> box) est
    conserve. Cablage beaucoup plus simple (8 pins vs 40, pas de cristal,
    pas de reseau d'adaptation RF complexe)
    - Correction budget GPIO perime dans le FSD (GPIO3/15/47 dits "libres"
    alors que deja utilises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
    [02-bom-lcsc.csv]
2026-09-21 docs(pcb): reorganisation faces cube + Main sans NFC, avec IMU et halo LED
    Repartition des capteurs par face du cube figee (FSD 2.2.2c) : Devant=visage
    (yeux/bouche/BMP280 souffle/VEML7700), Dessus=HP+NFC, Cote1=panneau controle,
    Cote2=USB+enigme cle/tactile, Cote3=zone magique IR+Hall, Dessous=Main+IMU.
    Sur le schema Main :
    - ST25DV04KC (NFC) sorti vers le futur satellite Dessus (nfc.kicad_sch
    reutilisable tel quel)
    - LSM6DSOXTR (IMU) ajoute a la place, pinout verifie datasheet ST DS12814
    - 12x WS2812B-B/T (halo face Dessous) ajoutees en chaine derriere R8,
    bug de cablage residuel corrige au passage (fil direct R8->J9 en trop)
    - BOM/netlist resynchronises (U11/C4/C5 reaffectes, J10->J2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
    [02-bom-lcsc.csv]
2026-09-23 fix(auth): séparation de domaine des signatures box (auth vs register)
    La box signait "<uid>:<challenge>" pour /api/box/auth comme pour la preuve
    d'appairage BLE. Le canal BLE n'étant pas authentifié, n'importe qui à portée
    pendant la fenêtre d'appairage pouvait faire signer un challenge /auth et
    obtenir un JWT au nom de la box (accès aux packages licenciés).
    Le message signé devient "<purpose>:<uid>:<challenge>" :
    - firmware : hal_box_auth_sign(purpose, ...) ; cloud_client signe "auth",
    ble_prov ne signe que "register"
    - serveur : verifyBoxHmac(purpose, ...) — /auth exige "auth", /register
    exige "register"
    - tools : box_crypto.box_hmac(purpose=...), test_box_api vérifie qu'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
    [ble_prov.c, box_crypto.py, cloud_client.c, cloud_client.h, hal_box_auth.c, hal_box_auth.h, test_box_api.py, test_box_crypto.py]
2026-09-23 fix(box_auth): identité box dans une partition NVS dédiée (box_nvs)
    config_manager_init() appelle nvs_flash_erase() si la NVS est pleine ou change
    de format (MAJ ESP-IDF) : cela effaçait aussi box_creds, rendant la box
    définitivement non authentifiable sans reprovisioning par le master secret.
    - partitions.csv : box_nvs (data/nvs, 0x12000, 24 Ko) dans le trou libre
    avant factory — aucun offset existant ne bouge
    - hal_box_auth : lit box_nvs ; migration auto depuis l'ancien namespace de la
    NVS applicative ; ancienne table (box_nvs absente) → lecture legacy + warning.
    box_nvs n'est jamais effacée, sauf illisible ET copie des identifiants en RAM
    - provision_box.py : --flash n'é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
    [partitions.csv]
2026-09-23 fix(boot): la box démarre sans DAC ni écran au lieu de rebooter en boucle
    hal_audio_init() renvoie une erreur si le PCM5122 ne répond pas, et app_main
    l'appelait via ESP_ERROR_CHECK → abort → reboot infini (un fil desserré suffit
    à briquer la box). Idem pour hal_display_init().
    - main : écran et audio optionnels (log d'erreur, la box continue) ; sans écran,
    ui_face n'est pas démarré (sinon eye_task tournerait à vide sur le core 1)
    - hal_audio : sur DAC absent, libère le device I2C et le canal I2S — l'API
    reste appelable et sans effet
    - ui_face : API sans effet si non initialisé ; ui_face_start refuse sans init
    [hal_audio.c, main.c, ui_face.c, ui_face.h]
2026-09-23 fix(scenario): validation structurelle au chargement, moteur NULL-safe
    Un scénario syntaxiquement valide mais mal typé crashait le moteur (strcmp sur
    NULL) : expect.code/uid numériques (code: 7394 non quoté en YAML), id absent
    ou non chaîne, action non objet. Et un next vers un step inexistant laissait
    le moteur rejouer les actions du step courant en boucle.
    - scenario_validate.c (dépend de cJSON seul) : steps, ids uniques, types et
    événements connus, expect.uid/code chaînes, listes d'actions = tableaux
    d'objets, conditions de branch, références next/next_timeout/default.
    Appelé par scenario_engine_init → un scénario SD refusé bascule sur
    l'embarqué (logique existan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
    [yaml2json.py]
2026-09-23 fix(web): preuve de possession demandée juste avant /register
    /devices/add faisait signer le challenge dès la connexion BLE, puis attendait
    la saisie du WiFi et la connexion de la box (≤ 15 s) : au-delà de 60 s (TTL du
    challenge), /api/box/register répondait 401 « challenge expiré ».
    La preuve est maintenant obtenue après wifi_ok, juste avant l'enregistrement
    (la connexion BLE est toujours ouverte) ; un nouvel essai reprend un challenge
    frais. Texte d'aide mis à jour : la fenêtre s'ouvre depuis le menu de boot
    (la « touche maintenue au boot » ne fonctionne pas avec le MPR121).
2026-09-23 docs: rapport d'audit 2026-09-23 + CLAUDE.md à jour
    - docs/audits/2026-09-23-audit.md : plan de correction des 5 points critiques
    (fait, avec commits), vérifications effectuées, procédure de déploiement
    (rupture de protocole + flash complet pour box_nvs), points restants
    - CLAUDE.md : format de signature avec purpose, partition box_nvs,
    provisioning, tests host, conventions périphériques optionnels et
    validation de scénario, déclencheur BLE = menu de boot
2026-09-23 docs: audit hardware KiCad (Main) + schéma DB 2026-09-23
    Netlist extraite des feuilles power/esp32/imu/connector (audio.kicad_sch
    manquant) et recoupée avec le firmware, les datasheets et la netlist
    documentée. Pinout firmware ↔ schéma cohérent.
    Critiques : BTN1/BTN2 sur GPIO45/46 (strapping — pull-up prévue sur GPIO45 =
    VDD_SPI 1,8 V, la box ne boote plus), J3-J6 au brochage inverse du standard
    Qwiic/STEMMA QT, feuille audio absente. Importants : pas d'extinction
    possible, AP2112K 3V3 sous-dimensionné, WS2812 en 3,3 V sous 5 V, SD sans
    pull-ups ni découplage, ferrites sur horloges SPI, charge LiPo sans timer ni
    NTC, CHG/PGOOD non routés. DB : licences liées à la box plutôt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
2026-09-23 docs(datasheets): datasheets officielles + synthèses .md pour tous les composants
    PDF ajoutés (sources officielles ou miroirs LCSC/Farnell) : ESP32-S3,
    ESP32-S3-WROOM-1, AP2112, MT3608, SS14, DW01A, FS8205, USBLC6-2, PAM8406,
    ICS-43434, WS2812B V5 (C2761795), TF-01A.
    Synthèses créées pour chaque PDF du dossier (gabarit component-research, valeurs
    relevées dans les PDF uniquement) : les 12 ci-dessus + pcm5122 (synthèse
    complète, en plus de pcm5122-registers), Bourns PDB18/PTA, E-Switch 100,
    PN532 (marqué obsolète, remplacé par ST25DV), note d'application VEML7700.
    LSM6DSOX.pdf = doublon exact de LSM6DSOXTR.pdf, référencé depuis sa synthèse.
    Guidelines ESP32 : GPIO45/46 flottan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
2026-09-23 docs(audit): audit hardware rév. 2 vérifié datasheets + patch J3-J6 Qwiic
    Révision de l'audit KiCad du 2026-09-23 : chaque constat vérifié dans la
    datasheet et sourcé. Corrections de la rév. 1 : GPIO45/46 flottantes conformes
    (seule une pull-up externe sur GPIO45 serait fatale), WS2812 V5 conformes en
    3,3 V (V_IH 2,7 V), courant LEDs recalculé (12 mA/couleur).
    Nouveaux constats (feuille audio reçue) : C20 du PCM5122 câblé CAPM→VNEG au lieu
    de VNEG→GND, sorties haut-parleur sans connecteur, ICS-43434 sans 100 nF, gain
    fixe 24 dB du PAM8406 → volume à plafonner vers -20 dB, rail 5 V (SS14 1 A,
    seuil DW01A) limite en crête, timings WS2812 firmware hors spec V5.
    Propositions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
    [connector.kicad_sch]
2026-09-23 docs: datasheets satellites + audit rév. 2.1 + FSD mis à jour
    Datasheets ajoutées avec synthèse : BMP280, TMAG5273, MLX90614 (fournies),
    MTCH2120, MPR121, GC9A01A, USB-307HB-B-SU (téléchargées). ST25DV : adresses
    0x53/0x57 vérifiées.
    Audit rév. 2.1 — section satellites et bus I2C :
    - MTCH2120 : adresse réelle 0x20/0x21 (ADD_SEL), pas 0x28 ; adressage mémoire
    16 bits (DEVID 0x0000, BTNSTA 0x0102) → driver firmware à réécrire
    - MLX90614 : variante 3 V (Bxx) obligatoire sur le 3V3 des satellites ; bus
    limité à 100 kHz ; reprogrammation d'adresse inutile sans MPR121
    - bus I2C : ≤ ~250 pF avec pull-ups 4,7 kΩ (t_R ≤ 1000 ns), aucun conflit
    d'adresse en Phase 2
    - B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
2026-09-23 docs: validation sur cible de l'audit logiciel + procédure usbipd
    Flash complet sur la box ESP32S3-8FF7-D684 : table avec box_nvs, identité
    migrée (box_creds relu en flash), boot sans warning ni erreur, auth cloud OK
    avec la signature "<purpose>:<uid>:<challenge>", sync OK. CLAUDE.md : la
    DevKitC apparaît en CH343 dans usbipd, BUSID variable, attach + mknod.
2026-09-23 docs(audit): synthèse vivante de ce qui reste à faire
    docs/audits/RESTE-A-FAIRE.md consolide les audits logiciel et hardware/DB en
    une checklist par domaine (PCB Main, satellites, firmware, web/DB, sécurité
    produit, datasheets manquantes), avec priorité et responsable. Référencé
    depuis CLAUDE.md.
2026-09-27 chore(docker): devcontainer VS Code aligne sur start.sh
    Meme Dockerfile, user dev, montages ~/.claude / ~/.claude-code-local / ~/.ssh
    et entrypoint (ESCAPEBOX_DEVCONTAINER garde le container vivant). Env IDF dans
    ~/.bashrc de dev. tty-nodes.sh factorise la creation des nodes serie, relancable
    via sudo apres un usbipd attach a chaud.
2026-09-27 hardware: projet KiCad Main dans le repo
    Copie du projet KiCad (schemas 6 feuilles, libs LCSC, modeles 3D, BOM) sous
    hardware/main/ pour pouvoir le versionner et le modifier depuis le container.
    .gitignore : .history/ (historique local VS Code), *.lck, *.kicad_prl,
    metadonnees Windows *:Zone.Identifier, backups KiCad.
    Etat de depart, avant corrections de l'audit 2026-09-23 :
    - C20 deja corrige cote Gilles (VNEG-GND, verifie par netlist)
    - J3-J6 encore en brochage inverse (pin 1 = 3V3_D) : patch a appliquer
    - HP_L+/-, HP_R+/- toujours sans connecteur
    Claude-Session: https://claude.ai/code/session_01MMaRLhHbueFYg5T2BWU4YW
    [02-bom-lcsc.csv, audio.kicad_sch, blackbox.kicad_pcb, blackbox.kicad_sch, connector.kicad_sch, esp32.kicad_sch, imu.kicad_sch, power.kicad_sch]
2026-09-27 hardware+tools: brochage Qwiic J3-J6 applique, outils de verification
    - connector.kicad_sch : patch Qwiic reporte dans le projet (pin 1 = GND,
    2 = 3V3_D, 3 = SDA, 4 = SCL). Verifie par netlist sur les 4 connecteurs.
    Solde le point bloquant H2 de l'audit 2026-09-23.
    - tools/kicad_netlist.py : reconstruit la netlist depuis les .kicad_sch
    (wires, junctions, global labels, pins transformees). Le script de l'audit
    n'avait pas ete commite et avait ete perdu ; il l'est desormais.
    91,9 % des 430 pins raccordees, 123 nets. Options --ref / --net / --all.
    - tools/pdf_text.py : extraction de texte PDF en stdlib seule (ni poppler ni
    pypdf dans le container), avec decodage du kerning TJ — sa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
    [connector.kicad_sch]
2026-09-27 hardware(audio): connecteur haut-parleur J10 + ferrites FB3-FB6
    Solde le dernier point bloquant de l'audit 2026-09-23 (A2) : HP_L+/-, HP_R+/-
    n'aboutissaient a aucun connecteur.
    Schema (feuille audio, zone verifiee libre) :
    U3.OUT -> HP_x -> FB3..FB6 -> SPK_x -> J10.1..4
    - J10 : JST PH 4 broches (1 = L+, 2 = L-, 3 = R+, 4 = R-), meme famille que J9.
    Sorties en pont : aucune masse commune, les "-" ne doivent jamais etre reliees
    entre elles ni a GND (note portee dans le champ Description du symbole).
    - FB3-FB6 : Murata BLM21PG221SN1D, une ferrite par fil, exigee par la datasheet
    PAM8406 en classe D sans filtre (Application Note 2). 220 ohm a 100 MHz, 2 A a
    85 C, 45 mOhm, LCSC C85840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
    [audio.kicad_sch]
2026-09-27 hardware: pull-ups carte SD, resistances serie d'horloge, timer de charge
    Trois points "important" de l'audit 2026-09-23, verifies un par un sur le
    schema avant modification (tools/kicad_netlist.py).
    H7 — carte SD : aucune pull-up sur J11. L'ESP-IDF les rend obligatoires
    (sd_pullup_requirements.rst : « en mode SPI ou SD 1 bit, CMD et DAT0-DAT3
    doivent etre tirees au plus par 10k, y compris les lignes non reliees a
    l'hote »). Ajout de R15-R19 (10k) sur un rail 3V3_D commun, feuille connector.
    DAT1 (J11.8) et DAT2 (J11.1) n'avaient aucun fil : nets nommes SD_DAT1/SD_DAT2.
    H8 — horloges SPI : FB1/FB2 (ferrites 120R) remplacees par R13/R14 = 22 ohm
    0603. Device:R et Device:FerriteBead on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
    [audio.kicad_sch, connector.kicad_sch, esp32.kicad_sch, power.kicad_sch]
2026-09-27 hardware(power): D1 SS14 -> SS34 (3 A)
    Audit 2026-09-23 A5 : le MT3608 est un boost asynchrone, donc tout le courant
    du rail 5 V passe par D1. Charge actuelle ~0,83 A (12 WS2812 en blanc 432 mA +
    PAM8406 sur 8 ohm ~400 mA), soit juste sous le 1 A du SS14 et sans marge ; le
    moindre usage de J9 le depasse. Le SS34 porte la limite a 3 A dans la meme
    empreinte SMA pour ~0,013 $.
    - Symbole Diode:SS34 derive de Diode:SS14 (memes broches, meme dessin, meme
    empreinte) et embarque dans la feuille : KiCad n'est pas installe dans le
    container, impossible de piocher dans la bibliotheque systeme. Si celle-ci
    n'a pas de symbole SS34, KiCad le signalera a un « Update Symbols from
    Library » — s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
    [02-bom-lcsc.csv, power.kicad_sch]
2026-09-27 hardware(power): bouton marche/arret (option B) — EN_SYS + load switch 5 V
    Audit 2026-09-23 H4 : les EN de U5 (LDO 3V3_D), U6 (LDO 3V3_A) et U7 (boost
    MT3608) etaient cables directement sur VSYS, donc la box s'allumait des qu'une
    batterie etait branchee — ~10 mA de repos, soit ~12 jours pour 3000 mAh.
    Montage (feuille power) :
    - net EN_SYS commun aux trois EN, pull-down R20 100k (etat bas garanti si J12
    est ouvert ou debranche), pilote par SW3 (E-Switch 100, contacts or, face
    Cote 2) via J12, JST-SH 2 broches.
    - load switch Q1 (AO3401A) sur le rail 5 V, commande par Q2 (2N7002) + R21
    100k. Il est indispensable : le MT3608 est un boost asynchrone, EN bas laisse
    passer VBAT par L1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
    [02-bom-lcsc.csv, power.kicad_sch]
2026-09-27 hardware(power): U5 (3V3_D) en SO-8 — AP2112M-3.3TRG1
    Audit 2026-09-23 H5 : en SOT-25 (theta JA 184 C/W), U5 dissipe 0,56 W sous USB
    a 400 mA, soit +103 C d'elevation en boitier ferme. Le SO-8 (114 C/W) ramene
    l'elevation a +64 C — meilleur que le SOT-89-5 envisage dans l'audit (120 C/W),
    et surtout disponible chez LCSC (C5290219), ce que n'etait pas le SOT-89-5.
    U6 (3V3_A) reste en SOT-25 : il n'alimente que le PCM5122, ~25 mA, il ne
    chauffe pas. Deux references du meme LDO dans la BOM, assume.
    Brochage SO-8 releve sur le dessin de la datasheet (le tableau correspondant
    n'est pas extractible en texte, et les sources web se contredisaient) :
    1 = VOUT, 2/3/4 = NC, 5 = EN, 6+7 = GND, 8 =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
    [02-bom-lcsc.csv, connector.kicad_sch, esp32.kicad_sch, power.kicad_sch]
2026-09-27 hardware(power): corrections issues de l'ERC — jonction L1 et empreintes JST
    Deux points remontes par l'ERC du 2026-09-27 (0 erreur, 148 warnings).
    1. REGRESSION de ma part, corrigee : en isolant l'EN de U7 pour le net EN_SYS,
    j'avais aussi supprime la jonction (105.41, 111.76) en la croyant devenue
    inutile. Elle portait en realite une seconde derivation : VSYS -> L1,
    l'inductance du boost. Sans elle, KiCad signalait une extremite de fil non
    connectee — autrement dit le MT3608 n'etait plus alimente. Jonction
    retablie, L1.1 de nouveau sur VSYS (verifie par netlist).
    Lecon : une jonction peut porter plus de branches que celle qu'on retire ;
    verifier ce qui passe par l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
    [audio.kicad_sch, connector.kicad_sch, power.kicad_sch]
2026-09-27 hardware(connector): colonne de labels SD/SPI2 recalee sur la grille
    L'ERC signale 61 fils dont une extremite est hors de la grille de connexion
    (1,27 mm). Six d'entre eux sont la colonne de labels de la carte SD, a
    x = 87,52 mm (= 68,91 pas de grille) : les quatre fils preexistants et les deux
    stubs SD_DAT1/SD_DAT2 que j'ai ajoutes en m'alignant dessus sans verifier.
    Colonne entiere recalee a 87,63 mm (69 pas). Netlist comparee avant/apres,
    strictement identique — la correction est geometrique, pas electrique.
    Restent 55 fils hors grille, tous preexistants (connector, imu, esp32). Sans
    effet sur le PCB, mais ils rendent les editions futures hasardeuses : un fil
    tire a la grille de 50 mi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
    [connector.kicad_sch]
2026-09-27 hardware(power): J2 en 3 broches pour la NTC de la cellule 18650
    Batterie retenue : cellule Li-ion 18650 de 3400-3500 mAh (et non plus une LiPo
    pouch). Meme chimie, mais enveloppe acier avec event de surpression : plus
    robuste dans un objet concu pour etre secoue et retourne. Une seule cellule —
    deux auraient porte la charge a ~8 h, au-dela du pire cas du timer R_TMR qui
    vient d'etre pose, et auraient impose de revoir R_ISET et R_ILIM.
    - J2 : Conn_01x02 -> Conn_01x03, descendu de 2,54 mm pour que les broches 1 et
    2 restent exactement sur leurs fils. Broche 3 -> nouveau net BAT_TS.
    Empreinte JST_PH_B3B-PH-K_1x03_P2.00mm_Vertical (verifiee).
    - R_TS (10k fixe) conservee mais passee en DN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
    [02-bom-lcsc.csv, power.kicad_sch]
2026-09-27 hardware+tools: BOM reconciliee avec le schema + controleur automatique
    Controle complet demande apres la decouverte que la BOM avait derive. Nouvel
    outil tools/check_bom.py : verifie references manquantes des deux cotes,
    quantites, valeurs et empreintes, et liste les champs LCSC absents. Il
    normalise les notations (4u7 vs 4.7uF, 1k5 vs 1.5k) pour ne pas crier au loup.
    Ecarts trouves et corrigés :
    - 33 composants du schema ne figuraient PAS dans la BOM, tous preexistants :
    les 12 WS2812 du halo, les 7 condensateurs du PAM8406, C_U9, C_VBAT_SENSE,
    8 resistances nommees (R_MUTE, R_SHDN, R_MODE_*, R_SD_PD, R_CS, R_VBAT_*) et
    les 4 points de test. La carte n'aurait pas pu etre assemblee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
    [02-bom-lcsc.csv, esp32.kicad_sch]
2026-09-27 docs: squelette de validation/controle qualite + constat LSM6DSOX invalide
    docs/pcb/03-validation-qualite.md : points de test a poser AVANT le routage
    (8 obligatoires sur les rails et masses, 6 de diagnostic, 6 de signaux, plus
    les 4 deja au schema), regles de pose, check-list QA en 6 phases, et la piste
    d'un auto-test firmware.
    Deux choix structurants y sont argumentes :
    - le couple TP_5VB / TP_5V encadre le load switch : une seule mesure dit si le
    defaut vient du boost ou de Q1 ;
    - TP_ISET permet de mesurer le courant de charge sans couper de piste, la
    tension sur ISET refletant le courant reel (bq24075).
    Valeurs attendues tirees des datasheets deja verifiees (0,6 V sur FB du MT3608,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
2026-09-27 hardware: 48 erreurs ERC traitees, 22 points de test poses, VBAT_SENSE retire de J8.5
    Les rapports ERC precedents portaient « Report includes: Warnings » : les
    erreurs en etaient exclues a l'export et le resume affichait « Errors 0 ».
    Elles etaient donc presentes depuis le debut et je ne les ai pas vues — il faut
    exporter avec les erreurs incluses.
    48 erreurs, trois familles, toutes des faux positifs au sens electrique mais
    qu'il faut declarer sinon l'ERC reste inexploitable :
    1. power_pin_not_driven (14) : le projet n'utilise aucun symbole d'alimentation,
    les rails sont des global labels, et KiCad exige qu'un net « power input »
    soit pilote par une pin « power output ». Ni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
    [02-bom-lcsc.csv, audio.kicad_sch, connector.kicad_sch, esp32.kicad_sch, imu.kicad_sch, power.kicad_sch]
2026-09-27 docs: entete du document de validation, doublon de statut retire
2026-09-27 hardware+tools: 5 dernieres erreurs ERC + deux bugs de mes outils
    ERC 48 -> 5 -> 0 attendu. Les 5 restantes venaient toutes de mes PWR_FLAG :
    j'en avais pose neuf, soit trois de trop, et mal nommes.
    - 3V3_D et 3V3_A sont deja pilotes par une vraie pin « power output » (les VOUT
    des deux LDO) : deux sources sur un meme net = erreur. Flags retires.
    - VSYS : la sortie du bq24075 est une sortie d'alimentation. Plutot que d'y
    ajouter un flag, OUT_10 est typee power_out — c'est elle qui pilote le net.
    OUT_11 reste passive (les deux broches sont la meme sortie sur le QFN).
    - U9.VCC (DW01A) n'arrive qu'a travers R_VCC, aucune pin ne le pilote : net
    nomme DW_VCC et flag ajoute. C'etait l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
    [power.kicad_sch]
2026-09-27 docs: audit complet du 2026-09-27, reste-a-faire recree, FSD v0.3 nettoye
    - audit : 3 points avant routage (inductance L1, retour NTC sur VBAT-,
    brochage FS8205 non lu), 4 decisions de placement, BOM de reference
    fausse (U11 PN532, filtre DAC), ecarts firmware/hardware, flag PLL
    PCM5122 lu dans un registre reserve
    - RESTE-A-FAIRE recree a partir de l'audit
    - FSD : alimentation, connectique, API, BLE, flash et depot alignes sur
    le schema et le code ; servos/AS5600 retires des exigences
    - LSM6DSOXTR.md : tableau de brochage corrige (broches 4 a 14)
2026-09-27 docs(datasheets): inductance du boost — synthese Sunlord SWPA5040S, proposition SWPA5040S6R8MT
    - catalogue SWPA 2023 (scan) relu page par page : Isat/Irms/DCR, empreinte
    - SWPA5040S4R7MT (C48496) absent du catalogue actuel, 4R7NT a +-30 % sous
    les 4,7 uH recommandes par le MT3608 -> 6,8 uH +-20 % (C36411)
    - C_B1 10 uF alors que la datasheet MT3608 recommande 22 uF
    - pdf_text.py : ne plante plus sur les dictionnaires inline des images
2026-09-27 docs+bom: L1 = Sunlord SWPA5040S6R8MT (C36411), choix valide
    BOM, FSD, synthese MT3608 et reste-a-faire alignes ; le schema KiCad
    (22u 1210) reste a modifier cote layout. Rappel C_B1 10 uF -> 22 uF.
    [02-bom-lcsc.csv]
2026-09-27 hardware(libs): empreinte L_Sunlord_SWPA5040S pour L1 (C36411)
    Land pattern du catalogue Sunlord SWPA (pastilles 1,4 x 4,2 mm, ecart
    interieur 2,3 mm, corps 5 x 5 mm). La modification du symbole L1 est dans
    power.kicad_sch, laisse non commite avec la sauvegarde KiCad en cours.
2026-09-27 bom+docs: C_B1 (entree MT3608) 10 uF -> 22 uF 16 V, recommande par la datasheet
    Schema modifie dans power.kicad_sch (non commite, avec la sauvegarde KiCad
    en cours).
    [02-bom-lcsc.csv]
2026-09-27 hardware+docs: J2 en 4 broches (retour NTC sur GND), J13 5e connecteur I2C, FS8205 confirme
    - BOM : J2 4 broches, J13, noms des TP alignes sur l'annotation KiCad
    (check_bom OK)
    - L1 : empreinte LCSC importee (C36411, modele 3D), la mienne supprimee
    - FS8205 : brochage confirme sur la datasheet (capture de Gilles)
    - FSD, synthese bq24075, validation, reste-a-faire a jour
    Les feuilles KiCad modifiees (power, connector) restent non commitees avec
    la sauvegarde KiCad en cours.
    [02-bom-lcsc.csv]
2026-09-27 bom+docs: USB-C deporte sur le satellite Cote 2 (J14), BTN1/BTN2 routes vers J8
    - J1, U12 (USBLC6), R9/R10 passent sur le satellite Cote 2 ; J14 JST-PH 6
    (VBUS, GND, D-, D+, GND, 5V_HOST) sur la Main ; R22 0R DNP reserve le mode
    hote (enigme cle USB)
    - BTN1/BTN2 (GPIO45/46) vers J8.5/J8.6, pull-down R23/R24 10k
    - FSD, reste-a-faire, syntheses USB-C et USBLC6 a jour ; check_bom OK
    Schema modifie dans power/connector.kicad_sch (non commites, sauvegarde
    KiCad en cours).
    [02-bom-lcsc.csv]
2026-09-27 hardware: projets KiCad des 5 satellites, Cote 2 avec la partie USB
    - hardware/{devant,dessus,cote1,cote2,cote3}/ : .kicad_pro derive de la Main
    (memes regles), feuille racine avec cartouche de specification, tables de
    bibliotheques pointant vers hardware/main/libs
    - cote2 : J1 USB-C, USBLC6 (sur les lignes brutes), CC 5k1 transplantes
    depuis la Main avec leur cablage + J2 vers J14 ; netlist verifiee
    - BOM : references COTE2-*, notes CSV mal echappees reparees (check_bom OK)
    - FSD, reste-a-faire, CLAUDE.md a jour
    [02-bom-lcsc.csv, cote1.kicad_sch, cote2.kicad_sch, cote3.kicad_sch, dessus.kicad_sch, devant.kicad_sch]
2026-09-27 docs+bom: MLX90614 retire du produit, Cote 3 = TMAG5273 + proximite capacitive
    Cout de la variante 3 V (6,6-8,9 USD), bus I2C bride a 100 kHz. Controleur
    tactile de Cote 2 a rechoisir (MTCH2120 sans stock, MPR121 en fin de vie).
    Synthese MTCH2120 : boitier REB, motif de pastilles, PDF chiffre.
    [02-bom-lcsc.csv, cote3.kicad_sch]
2026-09-27 datasheets: ATtiny1616, CH32V003, STM32F042 (option microcontroleur pour le tactile)
2026-09-27 datasheets: ATtiny1616, reference documentaire non inventee
    [audio.kicad_sch, connector.kicad_sch, esp32.kicad_sch, imu.kicad_sch, power.kicad_sch]
2026-09-27 hardware+docs: CAP1298 retenu pour le tactile de Cote 2, BOM de reference corrigee (H8)
    - Cote 2 : CAP1298-1-SL-TR (C2652072, 8 touches, 0x28 fixe) remplace le MTCH2120
    (aucun stock) ; proximite de Cote 3 en suspens (pas de second CAP12xx).
    - BOM : U11 = LSM6DSOXTR, doublon U21 retire, filtre DAC 470 ohm + 2,2 nF C0G,
    TMAG5273A1 (C3716049), U10 SOT-23-6, ecran bouche a choisir, LCSC de D1/Q1/Q2
    dans la bonne colonne, ST25DV et haut-parleur ajoutes.
    - docs/pcb/02-bom-lcsc.csv (perimee) supprimee : une seule BOM.
    - FSD, RESTE-A-FAIRE, syntheses et cartouches satellites alignes.
    [02-bom-lcsc.csv, cote1.kicad_sch, cote2.kicad_sch, cote3.kicad_sch, dessus.kicad_sch, devant.kicad_sch]
2026-09-27 hardware(cote2): partie tactile CAP1298 dessinee, approche ta main sur Cote 2
    - U2 CAP1298 (0x28), C1 100 nF + C2 1 uF (figure 3-1), J3 Qwiic, ALERT# et N/C a GND.
    - 6 touches (CS1-4, CS6, CS7), proximite CS8 gardee par SG (CS5), electrodes
    E1-E8 sur le PCB (TestPoint provisoires, hors BOM). Netlist verifiee.
    - Cote 3 = TMAG5273 seul. Bibliotheque : CAP1298 importe, MLX90614 et
    MTCH2120 retires. BOM, FSD, RESTE-A-FAIRE et synthese CAP1298 alignes.
    [02-bom-lcsc.csv, cote2.kicad_sch, cote3.kicad_sch]
2026-09-27 validation schema Main + Cote 2, guide AN2934 (dessin des electrodes)
    - power : no_connect retire sur U10 (D12 superposees, erreur ERC), ajoutes sur
    U5 2-4, U6.4, U9 TD (NC selon datasheets).
    - Rapport docs/audits/2026-09-27-validation-main-cote2.md : interfaces J14/J2 et
    Qwiic conformes, pastilles UART0 absentes (point ouvert).
    - Synthese AN2934 : regles de dessin des electrodes self-capacitance.
    [power.kicad_sch]
2026-09-27 power: no_connect remis sur U10 (pin 5 cachee, erreur ERC) ; sauvegarde KiCad de Gilles (orientation de labels)
    [connector.kicad_sch, power.kicad_sch]
2026-09-27 main: pastilles UART0 TP_TXD0/TP_RXD0 ; SW3 cable en direct sur J12 (modele a rechoisir)
    [02-bom-lcsc.csv, cote2.kicad_sch, esp32.kicad_sch]
2026-09-27 bom: SW3 reste un E-Switch serie 100 en facade (cable direct J12), finition or a confirmer
    [02-bom-lcsc.csv]
2026-09-27 SW3 = E-Switch RR111C1921 (bascule ronde de facade), synthese datasheet RR1
    [02-bom-lcsc.csv, cote2.kicad_sch]
2026-09-27 power: R20 100k -> 2k2 (courant de contact pour SW3 E-Switch RR1, contacts argent)
    [02-bom-lcsc.csv, power.kicad_sch]
2026-09-27 bom: dielectriques precises (C0G/X7R/X5R), C_EN 1 uF sorti de la ligne 100 nF ; verification des empreintes et passifs
    [02-bom-lcsc.csv]
2026-09-27 power: C_IN 4,7 uF 25 V X7R 0805 (YAGEO C354262), au lieu de 10 V 0603
    [02-bom-lcsc.csv, power.kicad_sch]
2026-09-27 power: C_IN 4,7 uF 25 V X5R 0603 (Samsung CL10A475KA8NQNC, C69335), empreinte 0603 conservee
    [02-bom-lcsc.csv, power.kicad_sch]
2026-09-27 hardware: schemas des satellites Dessus, Devant, Cote 1 et Cote 3
    - Dessus : ST25DV04KC (10 nF + 100 nF), antenne boucle ANT1 (~4,8 uH, empreinte a creer), accord C3 DNP, Qwiic
    - Devant : BMP280 (CSB sur VDDIO, SDO GND), VEML7700, liaisons J7/J7b/J9, embases yeux/bouche provisoires, halo 8 WS2812B
    - Cote 1 : ADS7830 ratiometrique, 4 faders PTA6043, 4 pots PDB181, liaison J8, toggles/boutons en facade sur JST-PH
    - Cote 3 : TMAG5273A1 (INT et TEST a GND), 100 nF, Qwiic
    - BOM : lignes satellites prefixees par face, recoupees avec les schemas
    - Brochages corriges dans les syntheses : ST25DV (1 V_EH, 2 AC0) et VEML7700 (2 VDD, 4 SDA)
    - Questions ouvertes : docs/audits/2026-09-27-questions-satelli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
    [02-bom-lcsc.csv, cote1.kicad_sch, cote3.kicad_sch, dessus.kicad_sch, devant.kicad_sch]
2026-09-28 hardware(satellites): fichiers Cote 3 / Devant rechargeables, faders de Cote 1 raccordes
    - cartouches de Cote 3 et Devant : reste de l ancien texte colle apres le nouveau (guillemets
    echappes non geres par le script) -> erreur de chargement KiCad
    - Cote 1 : extremites de fils arrondies au 1/100 mm alors que les pins du PTA6043 sont hors
    grille (5,334 mm...) -> 28 pins non connectees a l ERC ; coordonnees exactes
    - cartouche de Devant remis sous le halo
    [cote1.kicad_sch, cote3.kicad_sch, devant.kicad_sch]
2026-09-29 hardware: Dessus enregistre par KiCad (reformatage, connectivite inchangee) ; kicad_pro Main (ordre des designators)
    [dessus.kicad_sch]
2026-09-29 docs(pcb): guide de layout composant par composant (Main 4 couches + satellites 2 couches)
    Regles KiCad/JLCPCB standard (empilement JLC04161H-7628, contraintes, classes de nets, vias),
    zonage de la Main, fiche par composant d apres les datasheets, bonnes pratiques des notes
    d application (TI, ST, Espressif, Microchip, Azoteq, Bosch, Vishay, NXP...) avec sources et
    contradictions signalees ; checklist avant DRC.
2026-09-30 docs(web): roadmap vers le site de presentation et l inventaire des histoires (proposition a arbitrer)
2026-09-30 web(E0): fondations — cle JWT box derivee, en-tetes de securite, tests, CI, Next 16.3.7
    - JWT box : cle HKDF(master, escapebox:jwt) + iss/aud + algorithms figes (les jetons
    existants deviennent invalides, la box se re-authentifie sur 401) ; /register -> 409 sur 23505
    - next.config : CSP sans nonce, HSTS, X-Frame-Options, Permissions-Policy (bluetooth=(self))
    - Vitest + tests box-auth (vecteur aligne sur tools/test_box_crypto.py) ; scripts typecheck/test
    - CI GitHub Actions : web (typecheck, lint, tests, build sans secret), crypto, tests host firmware
    - Next 16.2.6 -> 16.3.7 (advisory SSRF rewrites, non exploitable ici) + npm audit fix : 0 vulnerabilite
    - shadcn en devDependencies ; reque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
2026-09-30 web(E0): snapshot-schema.sql — colonnes qualifiees dans la jointure pg_trigger/pg_class (oid ambigu)
2026-09-30 web(E0): migrations versionnees — 0001_baseline (etat exact de la prod) + 0002_security
    Le releve du schema a revele deux failles :
    - box_challenges sans RLS avec tous les droits pour anon : la cle publique permettait de
    lire/consommer/effacer les nonces (deni de service de l'auth box) ;
    - policy devices FOR ALL sans WITH CHECK : un utilisateur connecte pouvait inserer une box
    avec n'importe quel box_uid via l'API Supabase, contournant la preuve BLE (option B).
    0002 : RLS + droits clients retires sur les tables serveur, devices/profiles en lecture
    seule, waitlist insertion seule (anon + authenticated), handle_new_user search_path vide,
    NOT NULL sans changer le sens des NULL, index devi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
2026-09-30 web(E0): README migrations — controle apres passage
2026-09-30 web(E0): desindexation pilotee par SITE_NOINDEX + guide staging (mot de passe, securite)
    - SITE_NOINDEX=1 : X-Robots-Tag sur toutes les pages (proxy.ts) et robots.txt Disallow: /,
    lu a chaque requete (robots.ts force-dynamic) -> un Restart suffit, pas de rebuild ;
    sans la variable, robots.txt exclut /api/ et les espaces prives
    - vitest.config.ts : alias @/ ; tests lib/indexing.test.ts (14 tests au total)
    - staging-coolify.md : SITE_NOINDEX (staging + prod tant que la marque n'est pas choisie),
    basic auth Traefik en laissant /api/box ouvert, regles de securite du staging
2026-09-30 web(E0): SITE_NOINDEX (en-tete seul, prod) et SITE_BLOCK_CRAWL (robots.txt, staging) separes
    Un Disallow dans robots.txt empeche le robot de lire le noindex de la page (une URL liee
    ailleurs peut alors sortir sans description) : en prod on ne pose que l'en-tete, robots.txt
    reste ouvert ; le blocage du crawl est reserve au staging, deja derriere un mot de passe.
2026-09-30 docs(staging): sous Coolify une variable exige un Redeploy (Restart ne la recharge pas)
2026-09-30 roadmap: staging termine, prod en deploiement manuel, mot de passe staging reporte
2026-09-30 web(E1): modele d'inventaire — licences au compte, versions d'histoires, fiche catalogue
    - migration 0003_inventory (additive) : scenario_versions, licenses, profiles.role,
    scenarios.status/summary/theme/ambiance/joueurs/age/langue/couverture/current_version_id,
    device_scenarios devient suivi d'installation ; reprise des droits par box en licences
    - /api/box/sync et /api/box/pkg : droit = licence active du proprietaire de la box,
    version = version publiee (lib/entitlements.ts) ; format de reponse inchange (firmware)
    - types generes depuis la base de staging (lib/database.types.ts), client admin type
    - tests : entitlements (logique pure), migrations rejouees dans PGlite (0001->0003 +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
2026-09-30 web(E1): valide en staging (parcours box via l'API de tbox), outil tools/test_box_e2e.py
2026-09-30 web(E2): back-office /admin — fiche, versions (zip -> Storage), publication atomique, licences
    - validateur de scenario porte en TypeScript (lib/scenario/validate.ts) ; cas de test
    PARTAGES avec le firmware (firmware/test_host/scenario_cases.json, lu par le test C
    et par Vitest : toute derive casse un des deux tests) ; fidelite cJSON (casse des cles,
    null != absent) confirmee par le C
    - regles de package portees (lib/scenario/package.ts) : manifest identique a
    package_scenario.py (verifie sur Capitaine Verdier v4), 100 Mo max, zip via fflate (MIT)
    - migration 0004 : bucket prive scenario-packages + publish_scenario_version() atomique
    - routes /api/admin/* (role admin, session ou Be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
2026-09-30 CLAUDE.md : poser une question de clarification si la demande est ambigue
2026-09-30 web(E3): refonte du site — direction « Ardoise », cube vivant, patron des six faces, catalogue public
    - identite repensee (esprit « Ouvrez l'oeil » garde) : site clair aux matieres de la box
    (craie, ardoise, noyer, laiton ; lueur iris reservee aux ecrans), Young Serif / Atkinson
    Hyperlegible Next / Martian Mono
    - accueil : cube en perspective pose sur la table, yeux qui suivent le pointeur, bouche qui
    ecrit et repond au clic ; « comment ca joue » ; patron deplie des six faces ; histoires
    - pages /la-box (une section par face), /histoires et /histoires/[slug] (lues depuis
    l'inventaire publie), /faq, /confidentialite, /mentions-legales
    - espace connecte, connexion et inscriptio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
2026-10-02 web(E3): quatre pistes de design sur /proto (Veillée, Récré, Affiche, Atelier)
    Deuxième tour de la refonte : pages d'essai non indexées, mêmes textes,
    quatre directions. Les yeux sont ceux du firmware : port navigateur
    d'Uncanny Eyes (web/components/eyes/engine.ts, même algorithme que
    eyes_anim.c, rendu suréchantillonné x2), textures converties depuis
    defaultEye.h par tools/eye_assets_web.py. Regard qui suit le pointeur
    par saccades, lampe qui contracte la pupille, clin d'oeil, bouche qui
    écrit mot à mot.
2026-10-03 web(E3): piste E « Veillée v2 » — personnages, lampe au défilement, énigmes en 3D
    - Moteur des yeux multi-personnages : l'œil de la box (formule du
    firmware) et six formes Adafruit (dragon, faune, triton, abysse,
    sentinelle, chat), teinte d'iris réglable, changement pendant un
    clignement. tools/eye_assets_web.py convertit tous les .h et génère
    catalog.gen.ts.
    - Veillée v2 : visage plus discret qui change de personnage toutes les
    9 s (sélecteur), lampe sur toute la page (souris ; sur mobile, un
    faisceau sous lequel on fait défiler), box en 3D collée pendant la
    lecture de six énigmes (une par face, chiffre gravé).
    - /proto/yeux : planche des personnages.
